SebicheParrilla/The-primis/mechanical/Pneumatics/Penumatic_Engine/README.md

# Pneumatic Engine

The pneumatic engine is the primary mechanical power source of AIZA.
It converts the energy stored in compressed air into rotational motion,
which is then transferred to the transmission.

The engine consists of four cylinders, and 2 crankshafts, two pistons per crankshaft. Compressed air is admitted to each cylinder at a specified point in the crankshaft's rotation, producing a sequence of piston movements
that maintains continuous rotation.

### Lego pistons and valves

<table>
<tr>
<td width="50%" align="center">

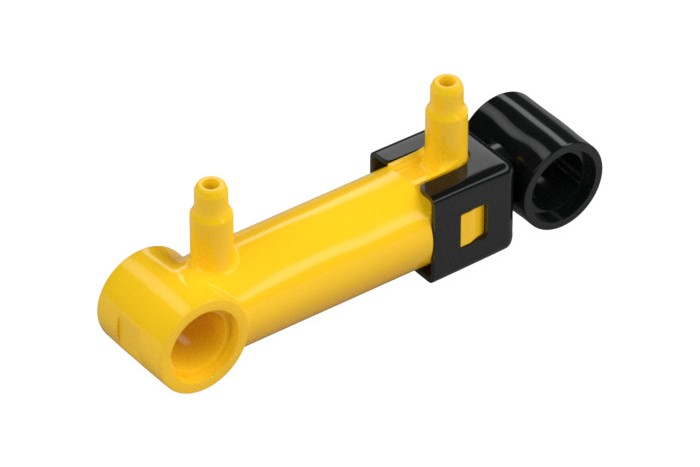
[picture p33: media/photos/legopneumaticcylinder.jpg]


**Lego Piston**
</td>
<td width="60%" valign="top">

Lego's pneumatic pistons have two inlets, depending in which inlet you apply air pressure to, the piston will contract or expand.

</td>
</tr>
</table>

<table>
<tr>
<td width="50%" align="center">

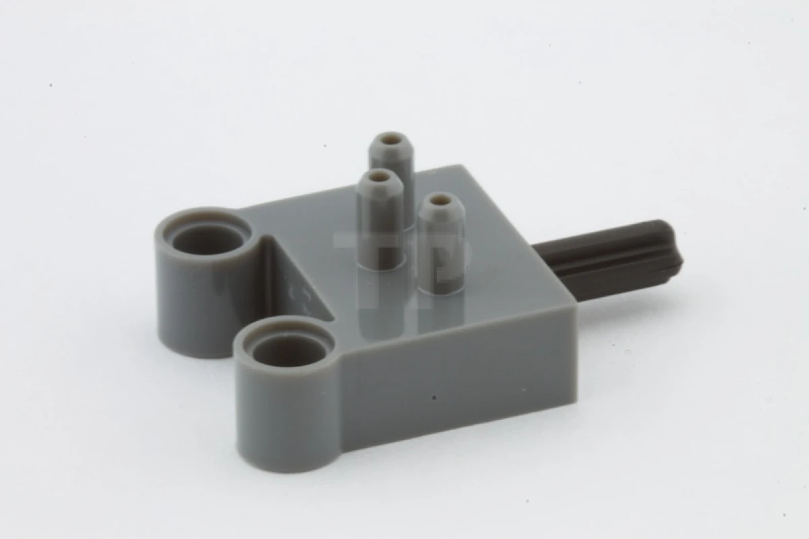
[picture p34: media/photos/LegoAirSwitch.webp]


**Lego Pneumatic Valve**
</td>
<td width="60%" valign="top">

 The switches are components that control the direction of air pressure with the direction of a lever.

</td>
</tr>
</table>

### Engine timing 
<table>
<tr>
<td width="50%" align="center">

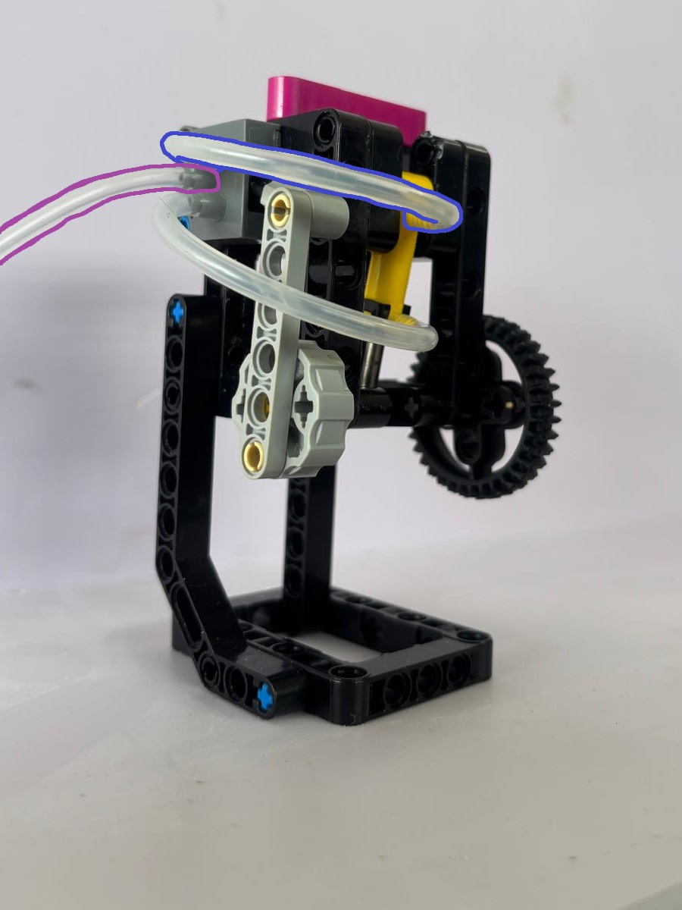
[picture p35: media/photos/Stroke22_croppedpainted.jpg]


**0° - 90°**
</td>
<td width="60%" valign="top">

Here we have a simple pneumatic engine with 1 switch and 1 piston, in this case the output of the engine is the black gear, the axle which its connected is called the crankshaft. On the rear of the engine we have a clear view of the pushrod resposible for connecting the crankshaft to the switch, if the crankshaft spins, the lever on the switch will move up and down. 
In this case, if we were to look at the engine from the front, (facing the black gear), the engine will spin clockwise.The hose outlined in purple is the supply of the switch, and the blue hose is the one activated and pressurised by the switch, if you follow the line you'll see that the line  top hole of the piston is the one being pressurised so the piston will expand, making the crankshaft spin 90°.

</td>
</tr>
</table><table>
<tr>
<td width="50%" align="center">

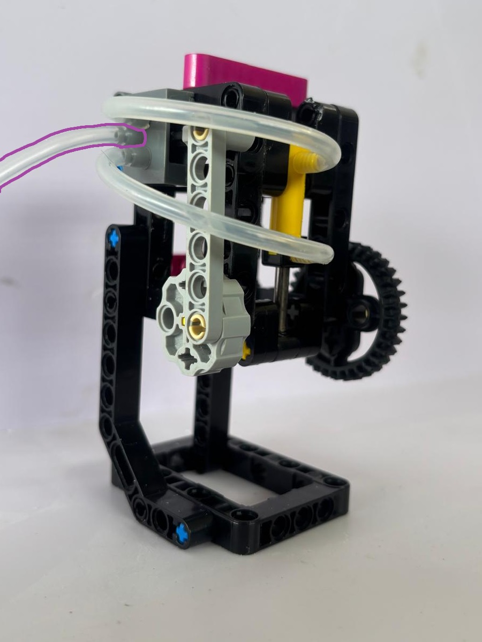
[picture p36: media/photos/Stroke33_croppedpainted.jpg]


**90° - 180°**
</td>
<td width="60%" valign="top">

The piston has expanded to it's maximum, and now needs to contract to keep spining the engine, but now the pushrod sets the valve to the middle which means neither of the outputs of the valve are being pressurised.

This causes the engine to lock itself, since the piston can't make the valve give itself pressure to contract and keep the chain reaction going. 

To counter this, one must install a flywheel specially on 1 cylinder engines so that the inertia from the flywheel keeps the motor spinning. Another way to fix this is to add more pistons, if you have a piston that is in a different timing, it can push another piston out of it's lock zone and vise-versa.

</td>
</tr>
</table><table>
<tr>
<td width="50%" align="center">

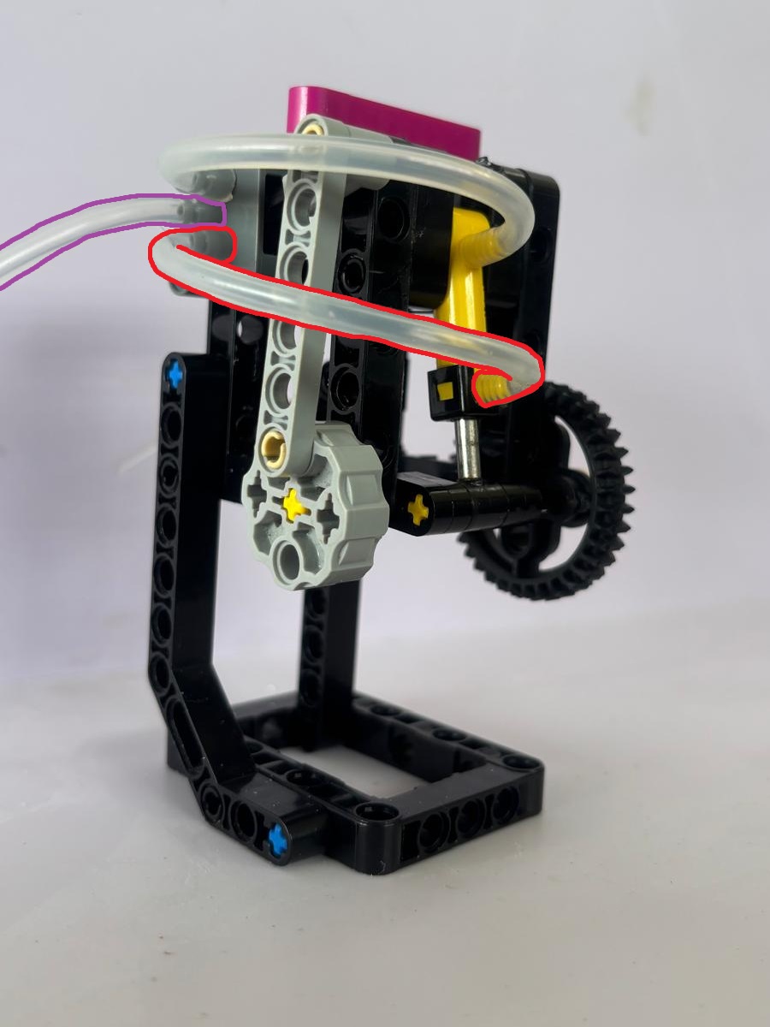
[picture p37: media/photos/Stroke44_croppedpainted.jpg]


**180° - 270°**
</td>
<td width="60%" valign="top">

Now the pushrod has reached its most upward position, and the valve has opened the lower output with pressure so the piston starts to contract.

</td>
</tr>
</table><table>
<tr>
<td width="50%" align="center">



**270° - 360°**
</td>
<td width="60%" valign="top">

This is the last 90° for a complete revolution, the valve is closed and blocking both outputs. 

Now the Piston will expand and keep the cycle going.

</td>
</tr>
</table>
