SebicheParrilla/The-primis/hardware/mechanical/Pneumatics/ASMS/README.md

# Air Supply and Management System (ASMS)

The Air supply and management system plays a crutial part in making our vehicle work, it ensures eficient and leak free supply of compressed air to the pneumatic engine. The high pressure side needed to be safe for 100psi, and ur low pressure side needed to be safe for a max of 30 psi,all of ur pneumatic components are rated higher pressure than the most they will ever endure. We knew this system was going to take up a lot of space and weight, so we allways kept in mind picking lightweight and compact components.

<div align= "center">


This flowchart represents the components in the ASMS
</div>

## Air tanks and hoses

it was very difficult to find lightweight, decent pressure and compact tanks for our proyect, but struck gold when we found a manufacturer for RC airplane pneumatic systems, this was absolutley perfect for ur proyect, since airplanes crutially need reliable, lightweight and cmpact components.

We used their hoses, that are rated at a max of 120psi and their air tanks, that have a displacement of 14.5³ inches, having **X**, making a total of **XX**³ inches.

## Air regulator
 After testing with various vertins of our pneumatic engines, we deduced that we needed to supply our engines with 20-25 psi of constant pressure for a minimum of 90 seconds
