SebicheParrilla/The-primis/build_guide/Step06/Chassis(00).md

# Step 6: Chassis

## Step 6.1 3DPrinted components
Print every component and note quatities.
| Component | Code | STL File |
|---|---|---|
| Output gears **x2** | C01 | [Download STL](../../media/CAD/STL/output_Gears.stl) |
| Chassis | C02 |[Download STL](../../media/CAD/STL/Car_Frame_3.stl)|
| Raspberry pi base | C03 |[Download STL](../../media/CAD/STL/RaspberryBase1.stl)|
| Air tank base | C04 |[Download STL](../../media/CAD/STL/Air_tanks_Base_3.stl)|
| Camera arm | C05 |[Download STL](../../media/CAD/STL/Camera_arm.stl)|
| Camera Base | C06 |[Download STL](../../media/CAD/STL/Camera_Base.stl)|

## Step 6.2  Miscelanious components

| Component | Quantity |
|---|---|
| Servo Screws | x2 |
| High pressure hose 60mm | x2 |
| High pressure hose 100mm | x1 |
| High pressure hose T | x1 |
| LEGO Pin with friction ridges | x14 |
| LEGO 4L axle | x1 |
| Photointerruptor LM393 | x1 |
| 1/2' screw | x8 |
| M4 screws | x2 |
| Panel mount sdpt toggle switch | x2 |
| Cytron Motion 2350 | x1 |
| BNO085 IMU | x1 |
| Boost converter | x1 |
| Buck converter | x1 |
| Micro usb cable | x1 |
| 18650 baterry holder in series  | x1 |
| 18650 baterries | x2 |
| Raspberry pi 3B+ | x1 |
| IMX708 | x1 |

| Tools |
|---|
| Dupont connector crimper  |
| Hot glue gun and silicone  |

[Once you have all the materials and objects printed go to the next step linked here.](../Chassis(01).png)
