SebicheParrilla/The-primis/mechanical/eCVT/eCVT_4.0.md

# eCVT 4.0
> Retrospective log from March 20, 2026: This entry's information was digitized from the physical engineering notebook.

<div align= "center">
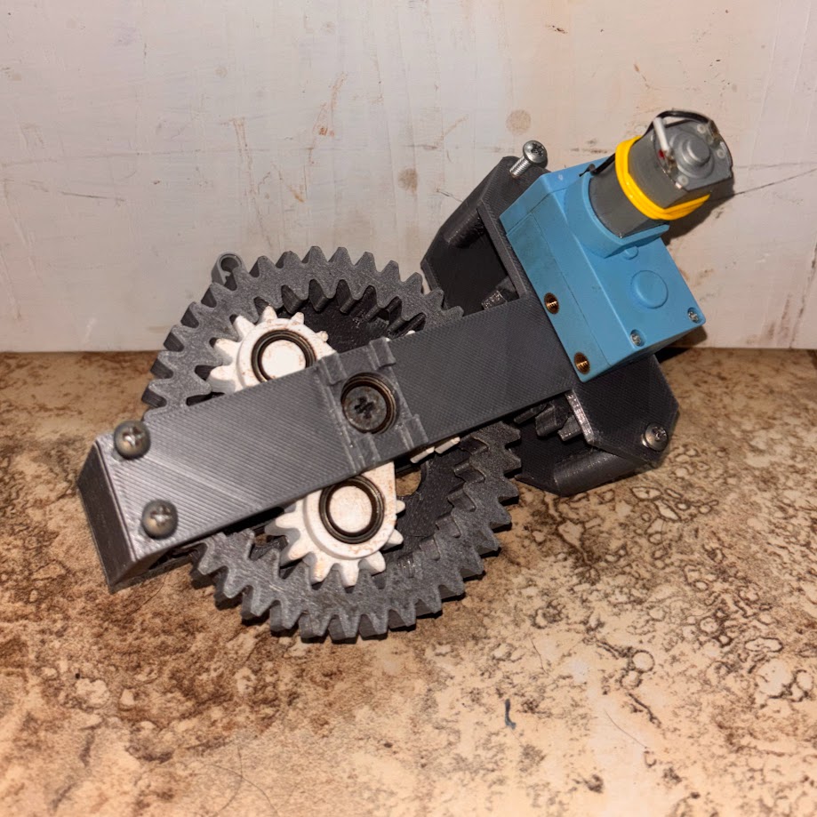
[picture p38: media/photos/IMG_2879.jpg]

</div>

## Specs
- Module: 2
- Pressure angle: 20°
- Gear ratio, 1 (Sun) : 4 (planet Carrier)
- R (Ring Gear) = 30
- S (Sun Gear) = 12
- P (Planet Gear) = 6
- OR (Outside Ring Gear) = 40

This was our first complete version that was equiped with everything the vehicle needed, we used this transmission for the first movable version of the vehicle, [AIZA 1.0](../../development_process/vehicle_iterations/AIZA_1.0.md), which we used for the Pueto Rico National Robot Olympiad.

## Improvements

With everything we learned with out past mistakes with the 3.0 and 3.1 versions we were able to make a smaller version of the transmission.

As the first iteration that had a transmission motor we made the gear ratio 4:1 opting for torque over speed.

## Improvements proyected for the E-CVT 5.0

This was  a great improvement over our past versions but we strived for a even smaller version in the future.
