SebicheParrilla/The-primis/mechanical/eCVT/eCVT_1.0.md

# eCVT 1.0
> Retrospective log from February 22, 2026: This entry's information was digitized from the physical engineering notebook.

Our first attempt of making our planetary gear transmission, this was mostly an attempt that tought us how to use fusion360, how our 3d printer worked and introduced us to gear ratio calculations.

We printed some parts and already saw some problems, so we didn't fully asemble it.

<div align= "center">
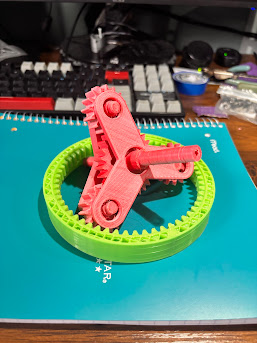
[picture p40: media/photos/IMG_1895.jpg]

</div>

## Specs
- Module: 2
- Pressure angle: 20°
- Gear ratio, 1 (Sun) : 4 (planet Carrier)
- R (Ring Gear) = 48
- S (Sun Gear) = 12
- P (Planet Gear) = 18

## Transmission Output/Input

Our plan was to make the pneumatic engines input on the sun gear, the electric motor's input on the planetary carrier and the output to be the ring gear.

## Improvements proyected for the E-CVT 2.0

Change the electric motor input to the ring gear, and the output to be the planetary carrier, this allows us to be able to move the car in the event of the pneumatic system failing.

We knew we it would be dificult to fit a big transmission on the car, so making things more compact and smaller will allways be a target.
