SebicheParrilla/The-primis/mechanical/eCVT/eCVT_3.0&3.1.md

# eCVT 3.0
> Retrospective log from March 10, 2026: This entry's information was digitized from the physical engineering notebook.

This was a prototype for a ultra small eCVT.

You can change a gear's size by making the module smaller, but you can only go so far, you will reach a point to where the teeth are going to be very small and you'll still have a big gear.

by reducing the number of teeth bt not the module you'll have the same size teeth but on a smaller radius gear.

<div align= "center">
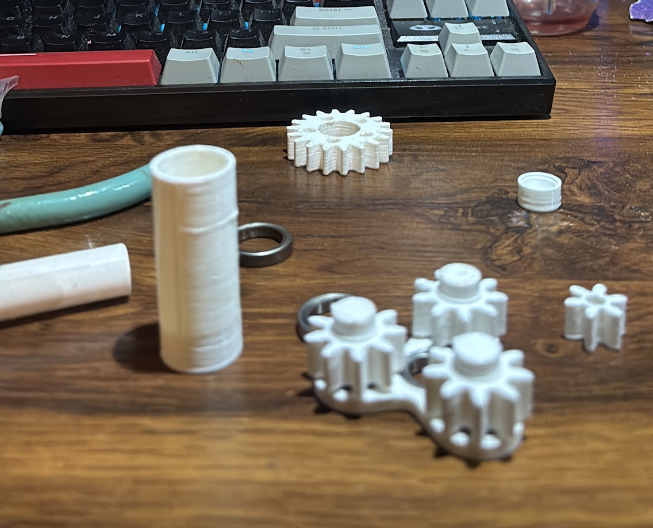
[picture p42: media/photos/ECVT3.jpg]

</div>

## Specs
- Module: 2
- Pressure angle: 20°
- Gear ratio, 1 (Sun) : 4 (planet Carrier)
- R (Ring Gear) = 24
- S (Sun Gear) = 6
- P (Planet Gear) = 9
- OR (Outside Ring Gear) = 30

## Why it failed 
Every gear from the past iteration as cut by half, and therefore it was way smaller thatn the previous version.

But we didn't see something coming, since the gears had large teeth compared to the size we had to make a big planet carrier, and we accientaly made it bigger than the teeth on ou ring gear, so it was impossible to assemble.

We desingned the planet carrier with the bearing for the planet gears and the sun gear very close together, when we assembld the planet carrier, it warped and snaped because of metal not stretching nor cmpling with the error of tolerances made by our 3d printer.

## Improvements proyected for the E-CVT 4.0

We learned that we had to keep in mind how we would assemble our designs when printed.

We knew we needed a balance of reducing the mdule and teeth number in order to have proportional gears for the transmission.

---
# eCVT 3.1

This was an attempt of fixing the problems of the 3.0, to try and make a ultra small version.

We kept printing slightly tune parts, but nothing worked, we will try later to make a ultra light and compact version, and focus on having something functional to keep testing our pneumatic engine.
