SebicheParrilla/The-primis/hardware/vehicle iterations/AIZA 1.0.md

# AIZA 1.0

 The first alive and moving vertion of AIZA, was only using the E-CVT V.4's motor to move, the pneumatic engine was installed, but the ASMS wasn't, so it had no way for it to activate.

## [Vehicle Photos](../../v-photos)

<div align= "center">
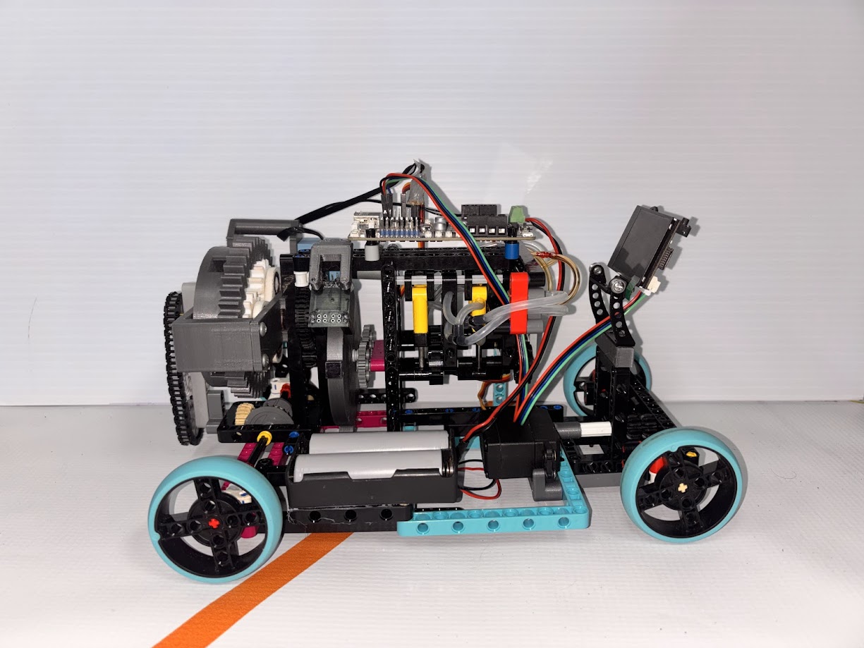
[picture p43: v-photos/Past iterations/IMG_2725.jpg]

</div>

It used the Huskylens Ai camera to detect the color of pilars and the lines of the playmat to determine its trayectory, and had a rack and pinion based steering system.
