SebicheParrilla/The-primis/mechanical/Pneumatics/Penumatic_Engine/2.0.md

# Pneumatic engine 2.0
> Retrospective log from March 3, 2026: This entry's information was digitized from the physical engineering notebook.

<div align= "center">
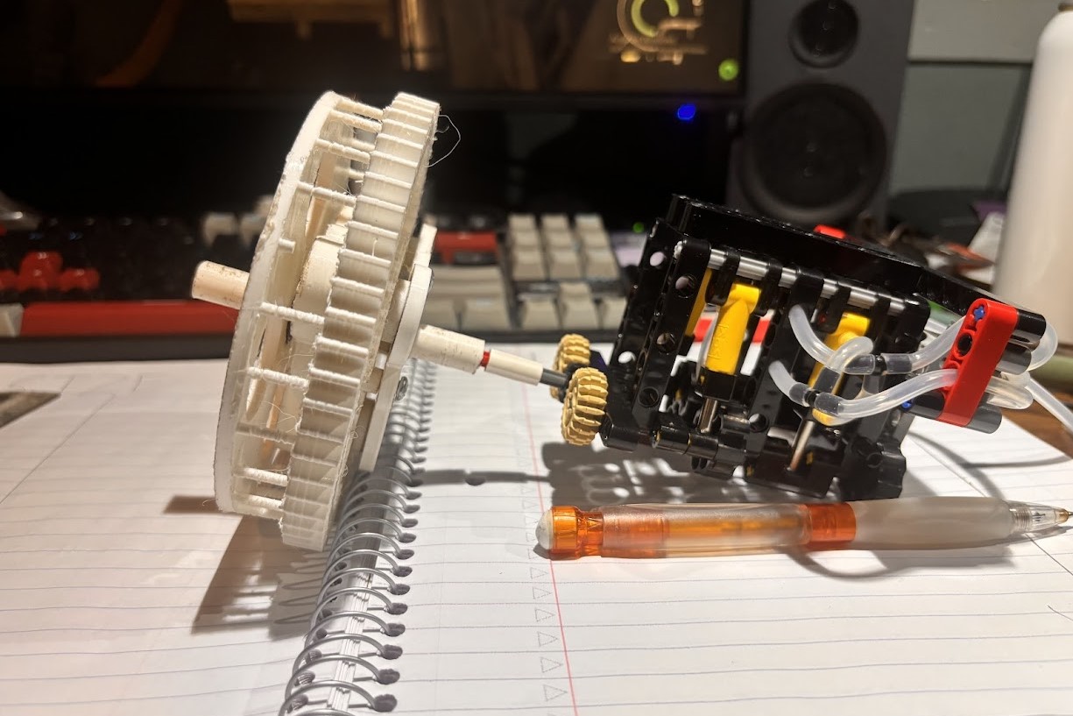
[picture p46: media/photos/pneng2ecvt2.jpg]
</td>
</div>

This engine had the same structure as the previous engine, with 3 frames in parallel, but with 5x7 frames instead of 7x11 frames. This made a engine with the same advantages as the previous engine, with almot half the size.

---

<div align= "center">
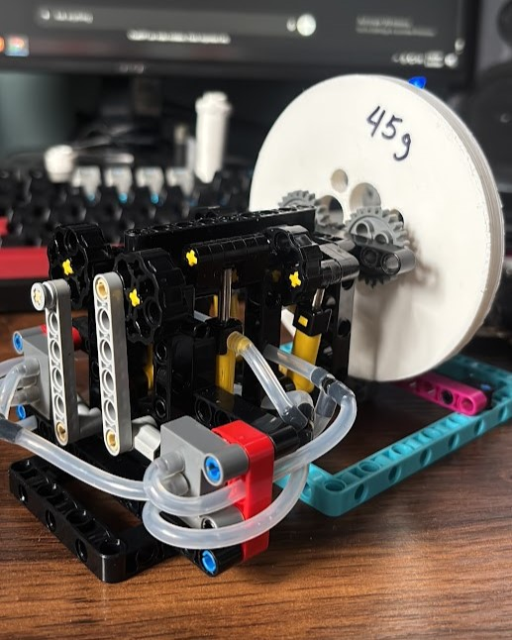
[picture p47: media/photos/pneng2flywheel.jpg]
</td>
</div>

On the image above you can see the engine with a flywheel on its output, and the both crackshafts with a 24 tooth gear, and the output with a 8 tooth gear, so a 1:3 gear ratio, so the flywheel spun 3 times as fast as the engine, amking it spin faster and store more energy, this later prooved that torque was reduced significantly and was not worth loosing.

Although it wasn't connected to the ASMS and inoperational, it was used in the [AIZA V.1](../../../development_process/vehicle_iterations/AIZA_1.0.md) .
