SebicheParrilla/The-primis/hardware/mechanical/eCVT/eCVT 4.0.md

# eCVT 4.0
> Retrospective log: This entry's information was digitized from the physical engineering notebook on 2026-06-29.

<div align= "center">

</div>

## Specs
- Module: 2
- Pressure angle: 20°
- Gear ratio, 1 (Sun) : 4 (planet Carrier)
- R (Ring Gear) = 30
- S (Sun Gear) = 12
- P (Planet Gear) = 6
- OR (Outside Ring Gear) = 40

This was our first complete version that was equiped with everything the vehicle needed, we used this transmission for the first movable version of the vehicle, [AIZA 1.0](../../../hardware/vehicle%20iterations/AIZA%201.0.md), which we used for the Pueto Rico National Robot Olympiad.

## Improvements

With everything we learned with out past mistakes with the 3.0 and 3.1 versions we were able to make a smaller version of the transmission.

As the first iteration that had a transmission motor we made the gear ratio 4:1 opting for torque over speed.

## Improvements proyected for the E-CVT 5.0

This was  a great improvement over our past versions but we astrided for a even smaller version in the future.
