SebicheParrilla/The-primis/hardware/mechanical/E-CVT/E-CVT 1.0.md

# E-CVT 1.0
> Retrospective log: This entry's information was digitized from the physical engineering notebook on 2026-06-27.

Our first attempt of making our planetary gear transmission, this was mostly an attempt that tought us how to use fusion360, how our 3d printer worked and introduced us to gear ratio calculations.



## Specs
- Module: 2
- Pressure angle: 20°
- Gear ratio, 1 (Sun) : 4 (planet Carrier)
- R (Ring Gear) = 48
- S (Sun Gear) = 12
- P (Planet Gear) = 18

This is where we learned how to make planetary gearboxes with proper meshing, we used this formula.
- (R + S) / (number of planets) = x
(x) must be 1 for it to have proper meshing.

## Transmission Output/Input

Our plan was to make the pneumatic engines input on the sun gear, the electric motor's input on the planetary carrier and the output to be the ring gear.

## Improvements proyected for the E-CVT 2.0

Change the electric motor input to the ring gear, and the output to be the planetary carrier, this allows us to be able to move the car in the event of the pneumatic system failing.
