SebicheParrilla/The-primis/electrical/e-valve.md

# Electronic Valve

<div align= "center">

</div>

---

This component is a normally closed valve that uses a solenoid to open or close the passage of compressed air to the pneumatic engine, allowing us to control wether its ON/OFF.
