SebicheParrilla/The-primis/electrical/OV5647.md

## OV5647 Camera

This is the first camera we used for AIZA. We used it until we felt it was worth it to invest in a wider FOV camera and to familiarise ourselfs with coding.

<div align= "center">
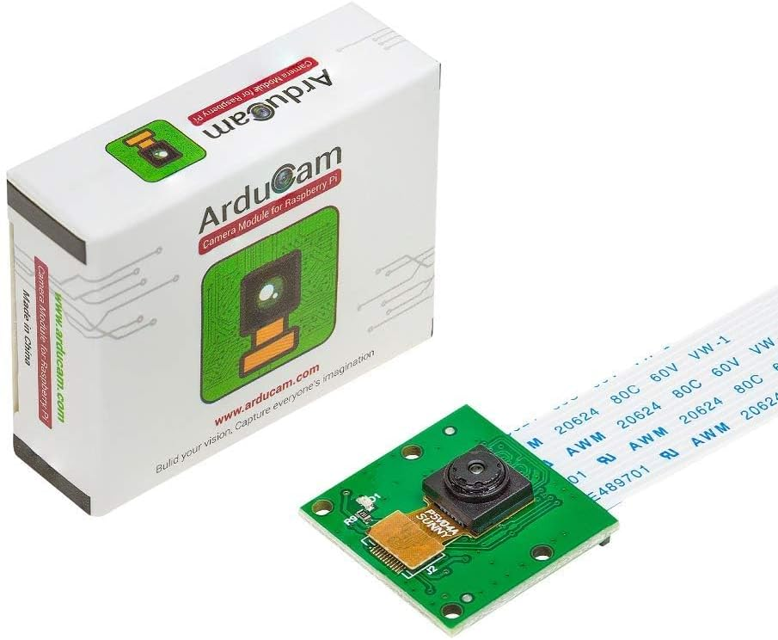
[picture p54: media/photos/OV5647.jpg]


The camera had a max resolution of 1080p and had a FOV of 56°

</div>
