SebicheParrilla/The-primis/logs/3-2-2026(X).md

# Brainstorming/analising eCVT behaivor 
> Retrospective log: This entry's information was digitized from the physical engineering notebook on 2026-06-30.

We are considering a T-slot photo interruptor as a RPM sensor, this will allow the microcontroller to compare these values to the transmission motor encoder to calculate the wheel speed.

Hall efect sensors, that are another alternative as a RPM sensor, need mateal aand magnetized components to work, so it will be heavyver and take more space

(DIGITALIZE THE TABLE IN ENG NOTEBOOK 1)
