SebicheParrilla/The-primis/development_process/vehicle_iterations/AIZA_2.1.md

# AIZA 2.1

<div align= "center">
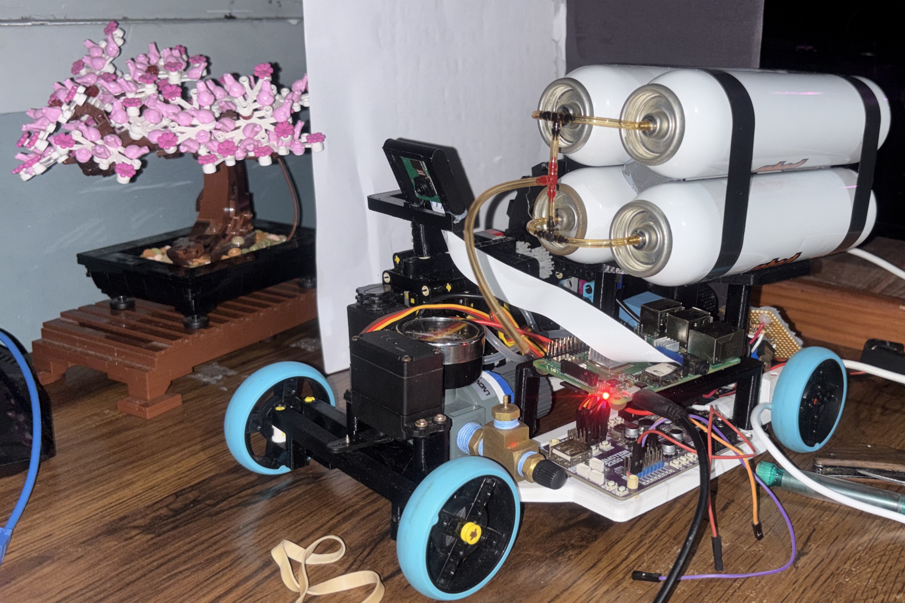
[picture p57: media/photos/AIZA 2.1.jpg]

</div>

---

With the same chassis as the 2.0 but with some minor tweaks, this was the first version of AIZA to have the [Raspberrypi](../../electrical/Raspberry_pi_3B+.md) installed, along with the [Camera](../../electrical/IMX708.md), the first time the robot had all of its systems in place, 

▶️ [Watch the AIZA 2.1 in action!](https://youtu.be/QNBB8k_d7_M)
