SebicheParrilla/The-primis/development_process/logs/eCVTanalisis.md

# Brainstorming/analising eCVT behaivor 
> Retrospective log from March 2, 2026: This entry's information was digitized from the physical engineering notebook. [Click here to see the digitalized version](../../development_process/digitalized_notebook/engineering_notebook_page_019-1.png).

We are considering a T-slot photo interruptor as a RPM sensor, this will allow the microcontroller to compare these values to the transmission motor encoder to calculate the wheel speed.

Hall efect sensors, that are another alternative as a RPM sensor, need mateal aand magnetized components to work, so it will be heavyver and take more space
