SebicheParrilla/The-primis/electrical/Cytron_Motion_2350_Pro/README.md

## Cytron Motion 2350 Pro
<div align= "center">

</div>
