SebicheParrilla/The-primis/build_guide/Step06/Chassis (1).png

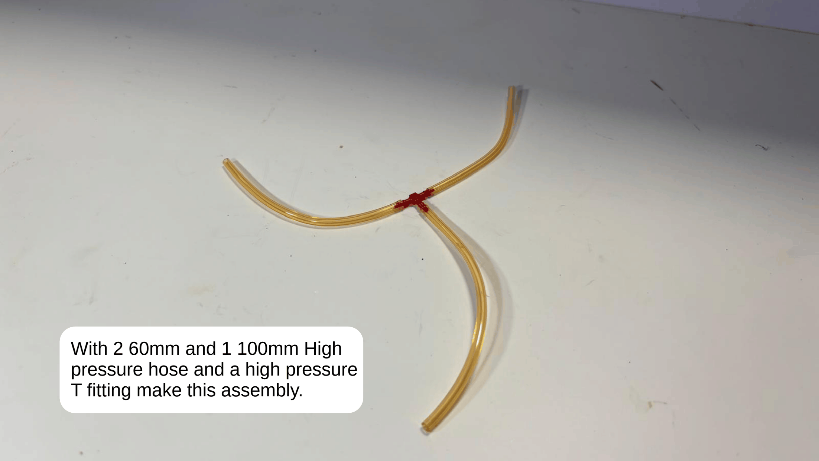
build_guide/Step06/Chassis (1).png
