SebicheParrilla/The-primis/build_guide/Step06/Chassis (2).png

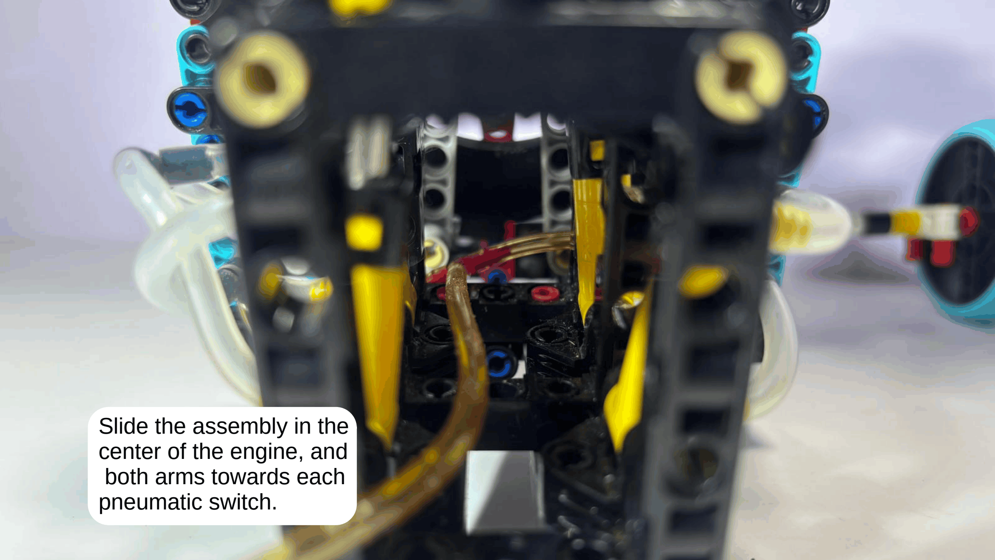
build_guide/Step06/Chassis (2).png
