SebicheParrilla/The-primis/build_guide/Step06/Chassis (3).png

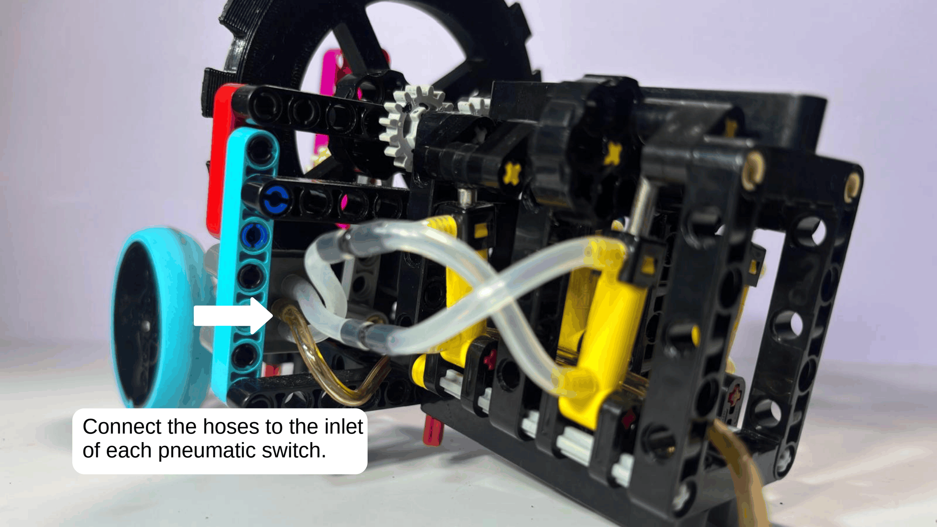
build_guide/Step06/Chassis (3).png
