SebicheParrilla/The-primis/build_guide/Step06/Chassis (6).png

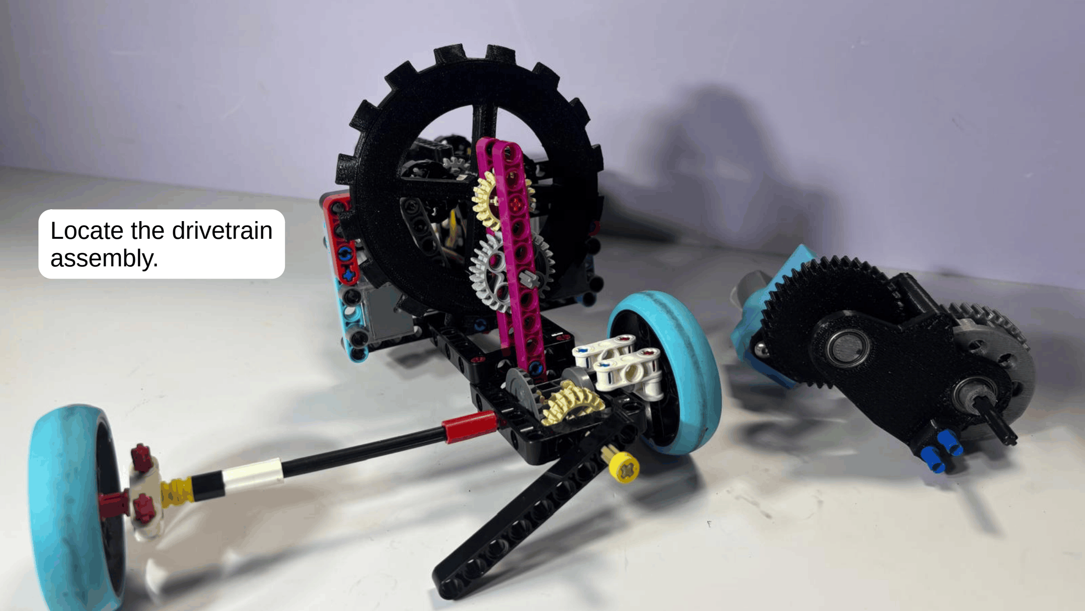
build_guide/Step06/Chassis (6).png
