SebicheParrilla/The-primis/build_guide/Step06/Chassis (14).png

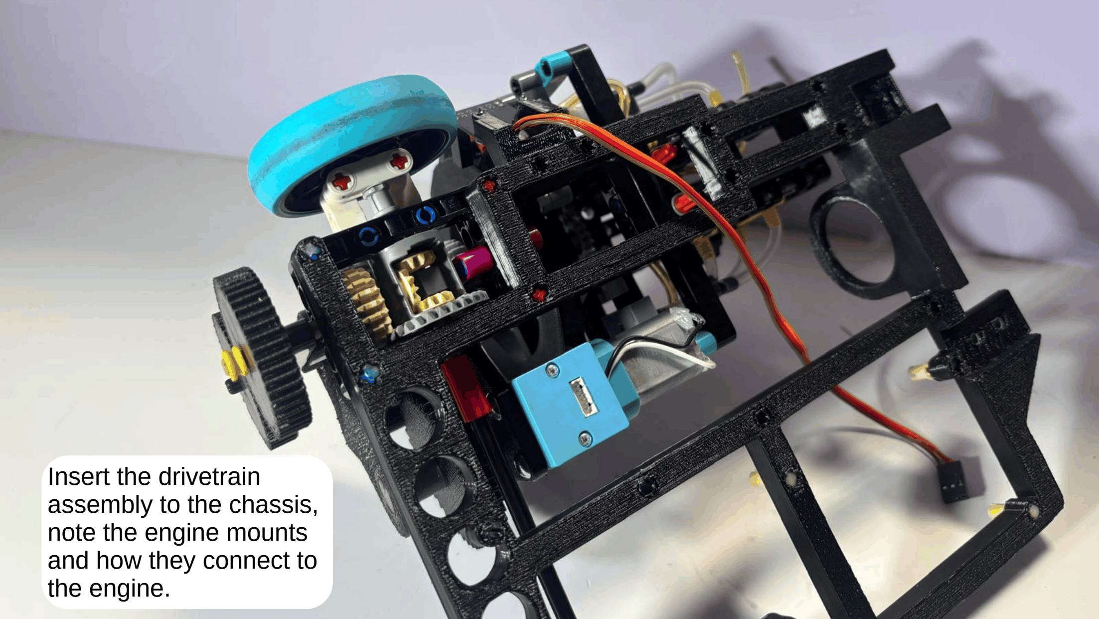
build_guide/Step06/Chassis (14).png
