SebicheParrilla/The-primis/build_guide/Step06/Chassis (17).png

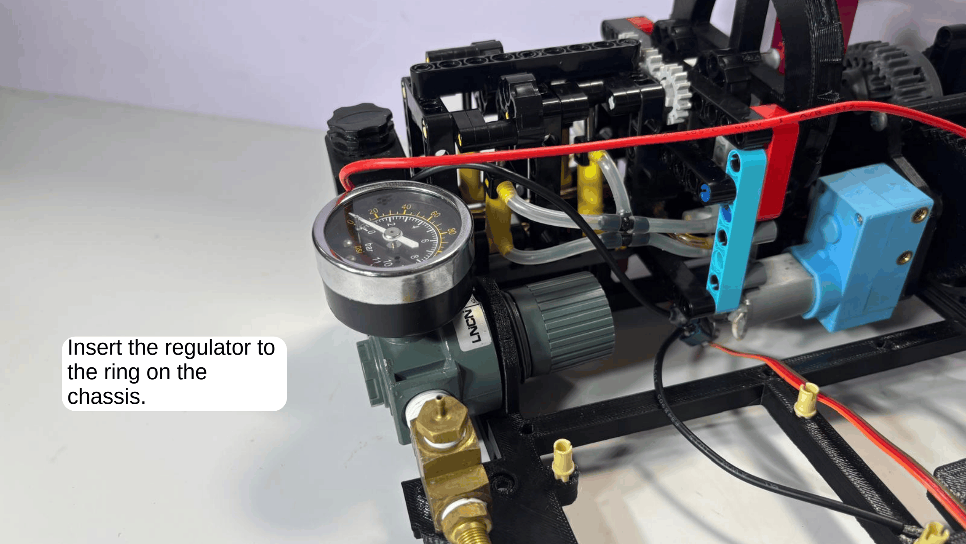
build_guide/Step06/Chassis (17).png
