SebicheParrilla/The-primis/build_guide/Step06/Chassis (18).png

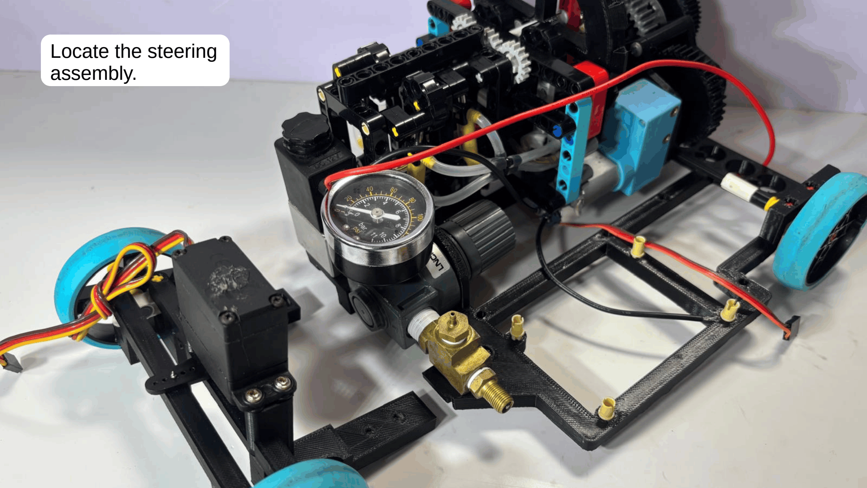
build_guide/Step06/Chassis (18).png
