SebicheParrilla/The-primis/build_guide/Step06/Chassis (25).png

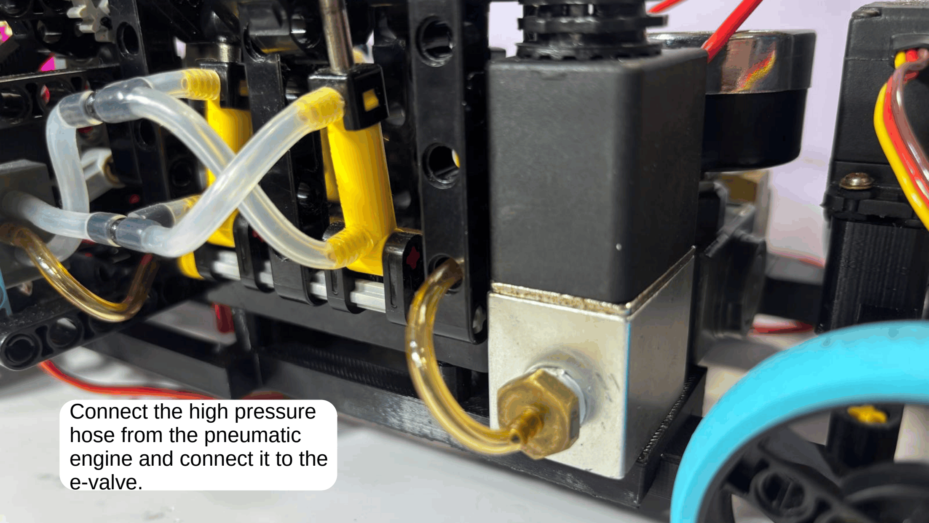
build_guide/Step06/Chassis (25).png
