SebicheParrilla/The-primis/build_guide/Step06/Chassis (28).png

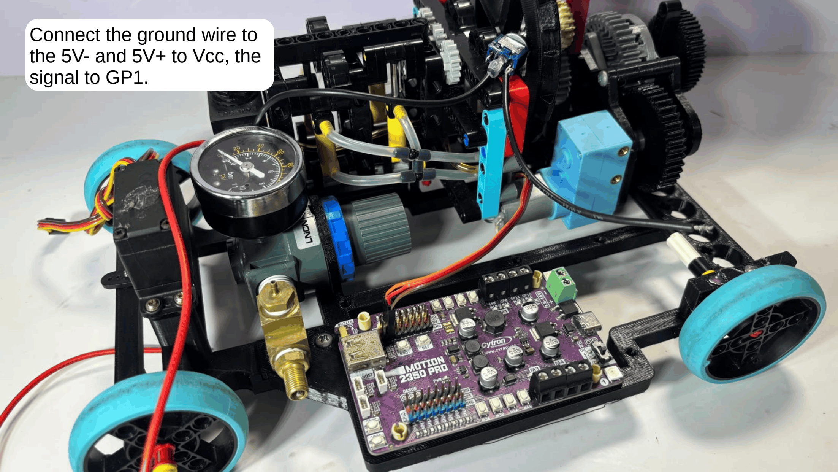
build_guide/Step06/Chassis (28).png
