SebicheParrilla/The-primis/build_guide/Step06/Chassis (30).png

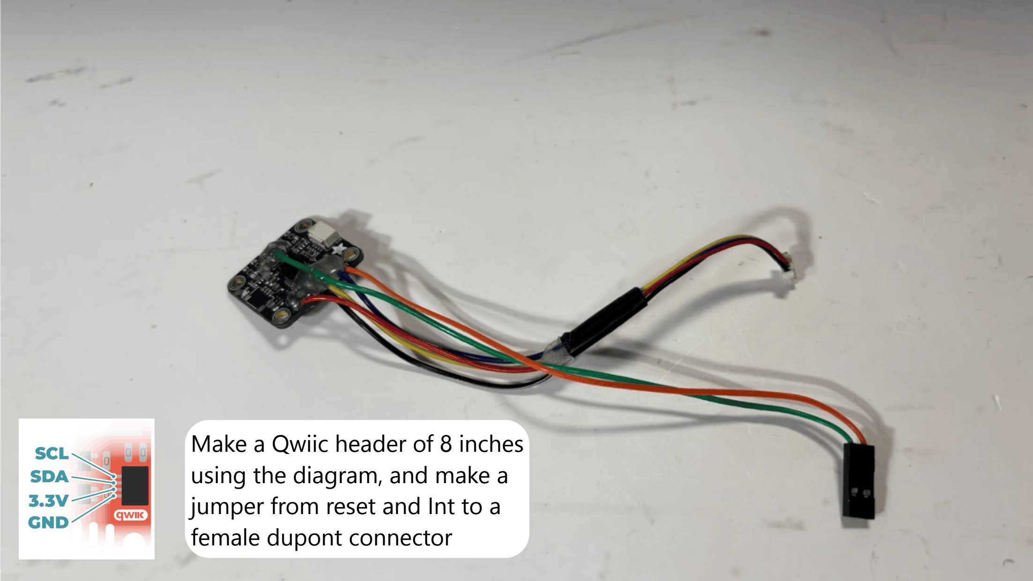
build_guide/Step06/Chassis (30).png
