SebicheParrilla/The-primis/build_guide/Step06/Chassis (34).png

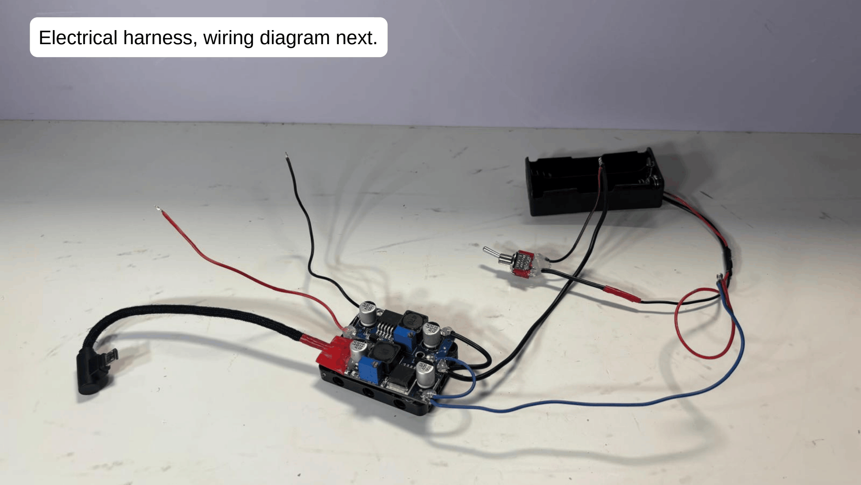
build_guide/Step06/Chassis (34).png
