SebicheParrilla/The-primis/build_guide/Step06/Chassis (41).png

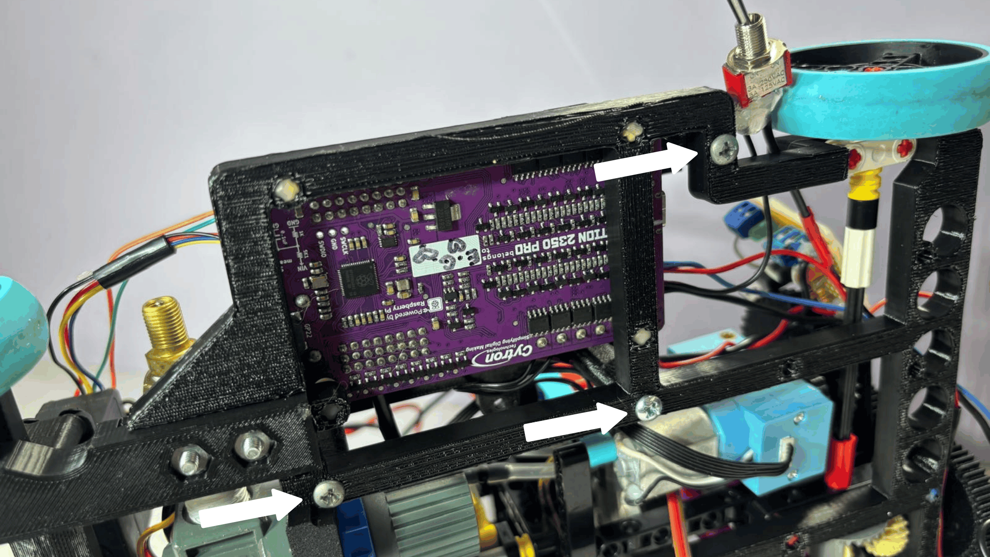
build_guide/Step06/Chassis (41).png
