SebicheParrilla/The-primis/build_guide/Step06/Chassis (45).png

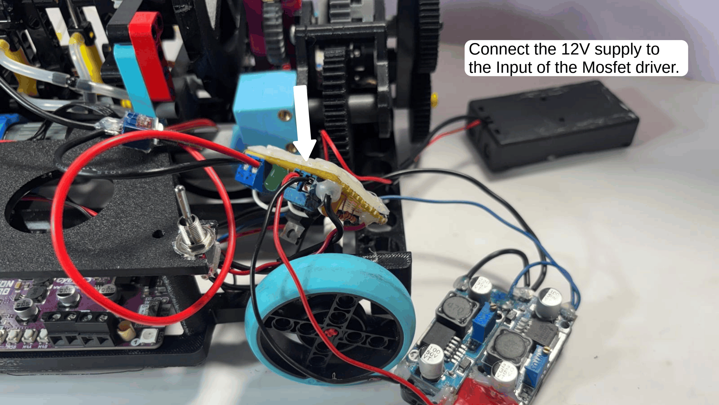
build_guide/Step06/Chassis (45).png
