SebicheParrilla/The-primis/build_guide/Step06/Chassis (46).png

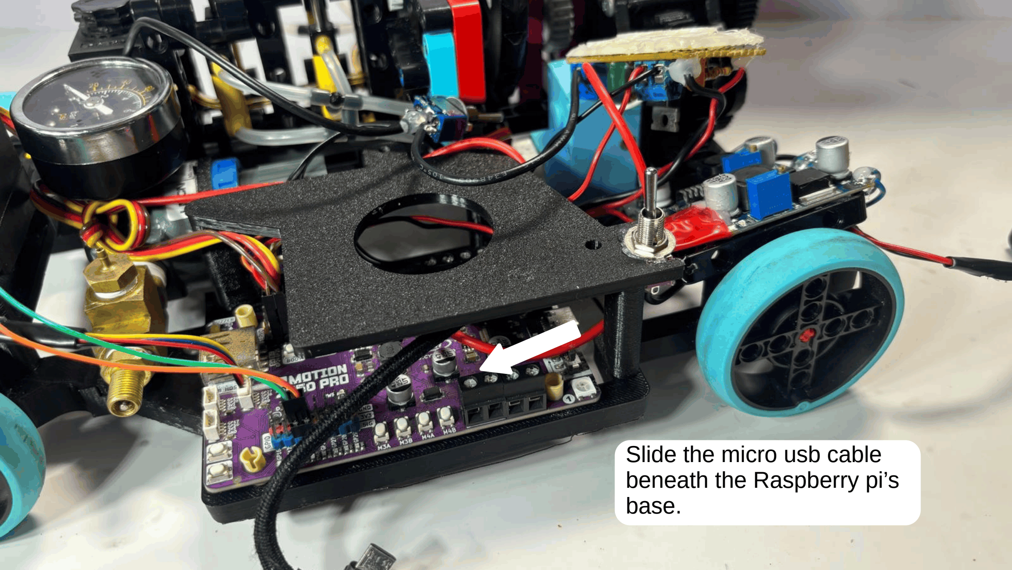
build_guide/Step06/Chassis (46).png
