SebicheParrilla/The-primis/build_guide/Step06/Chassis (47).png

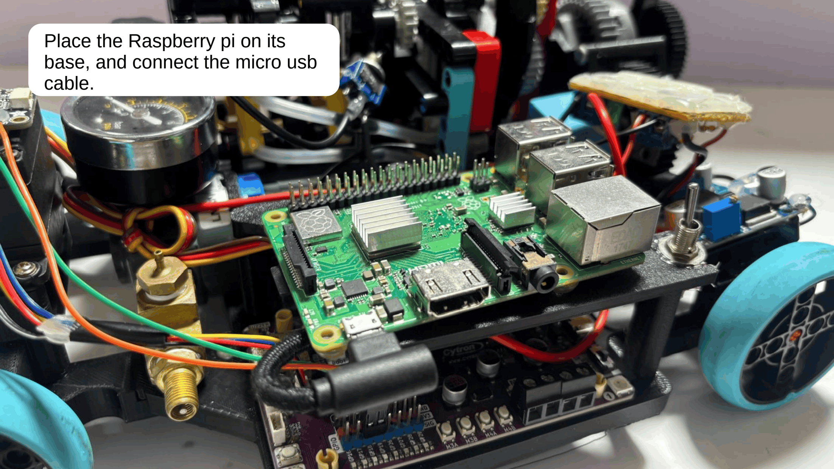
build_guide/Step06/Chassis (47).png
