SebicheParrilla/The-primis/build_guide/Step06/Chassis (51).png

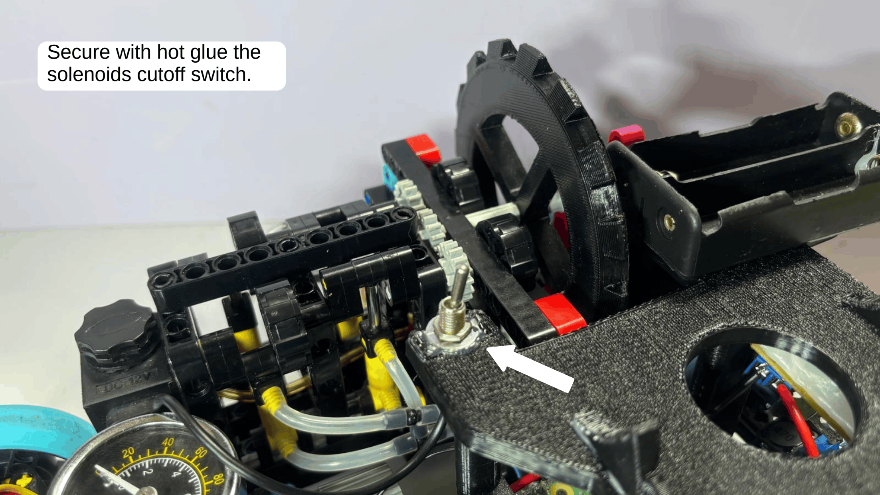
build_guide/Step06/Chassis (51).png
