SebicheParrilla/The-primis/build_guide/Step06/Chassis(11).png

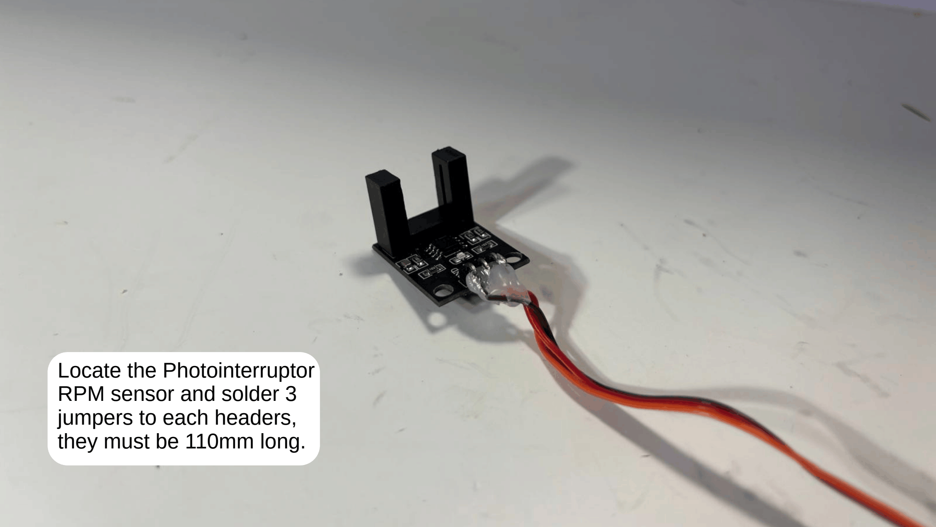
build_guide/Step06/Chassis(11).png
