SebicheParrilla/The-primis/build_guide/Step06/Chassis(13).png

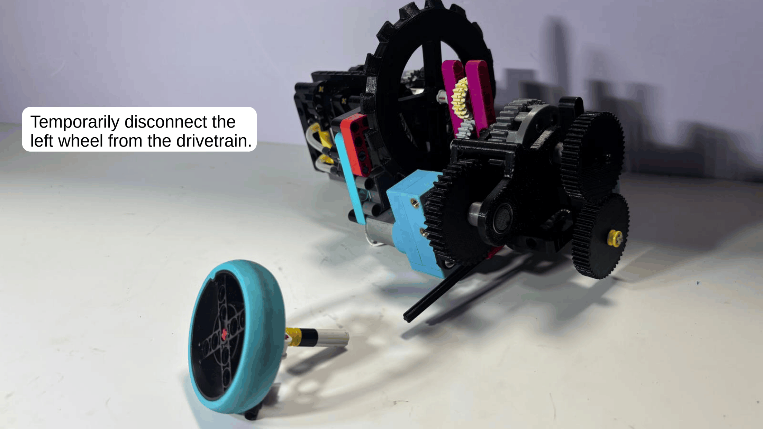
build_guide/Step06/Chassis(13).png
