SebicheParrilla/The-primis/build_guide/Step06/Chassis(15).png

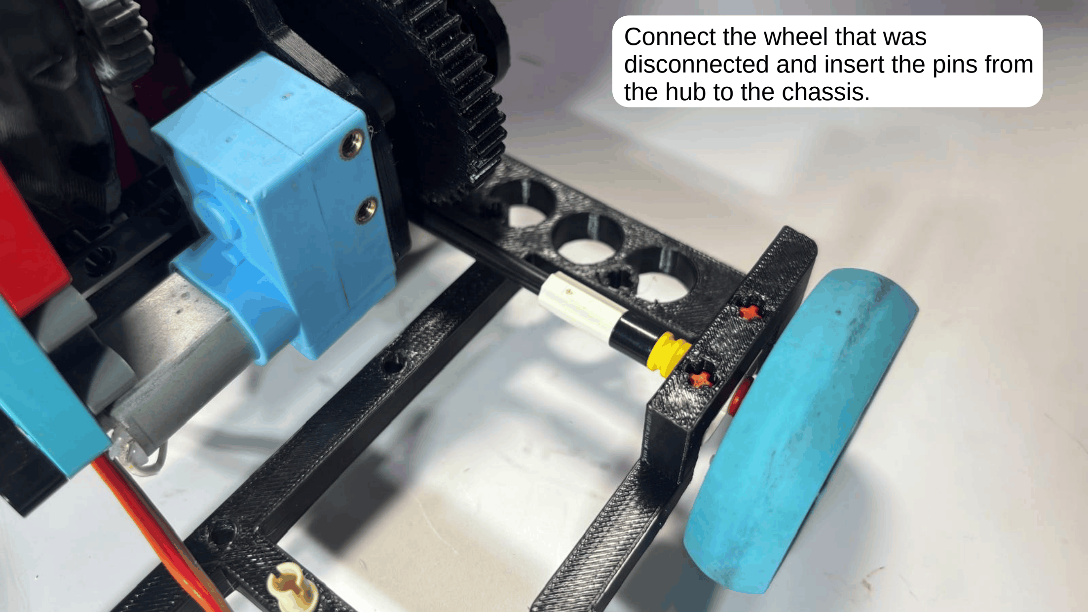
build_guide/Step06/Chassis(15).png
