SebicheParrilla/The-primis/build_guide/Step06/Chassis(19).png

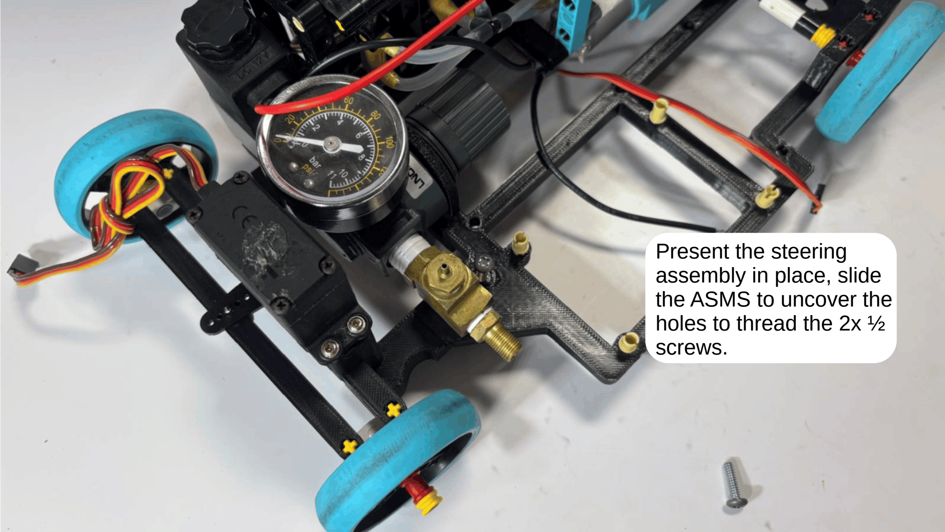
build_guide/Step06/Chassis(19).png
