SebicheParrilla/The-primis/build_guide/Step06/Chassis(20).png

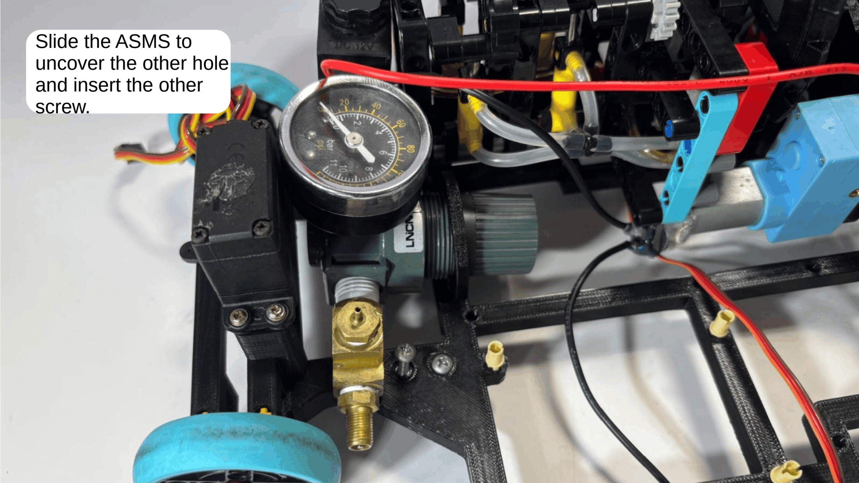
build_guide/Step06/Chassis(20).png
