SebicheParrilla/The-primis/build_guide/Step06/Chassis(24).png

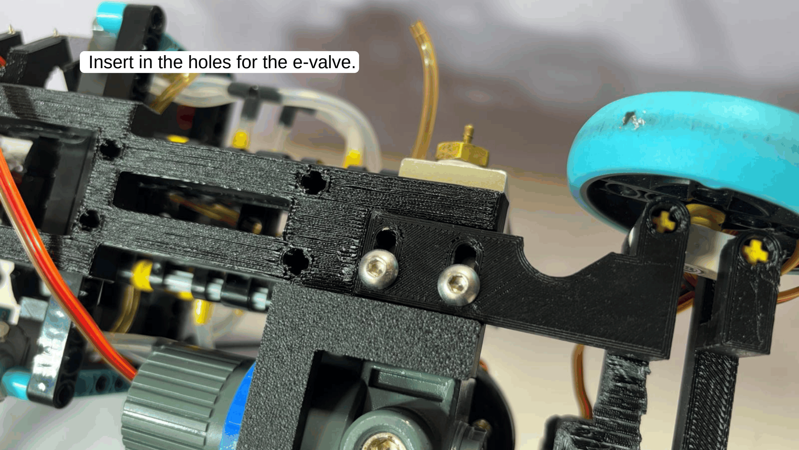
build_guide/Step06/Chassis(24).png
