SebicheParrilla/The-primis/build_guide/Step06/Chassis(26).png

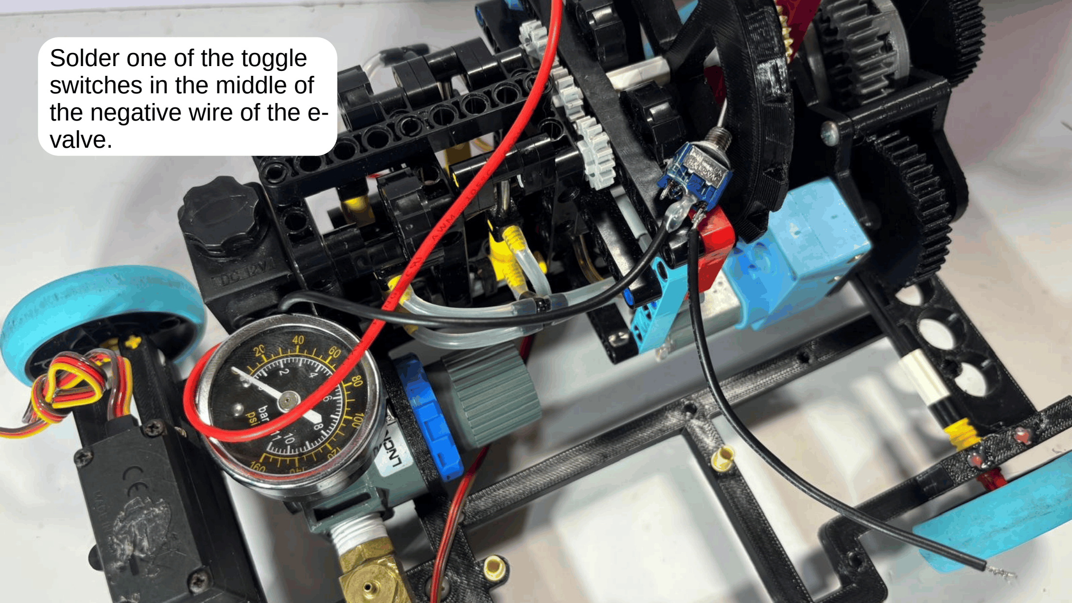
build_guide/Step06/Chassis(26).png
