SebicheParrilla/The-primis/build_guide/Step06/Chassis(32).png

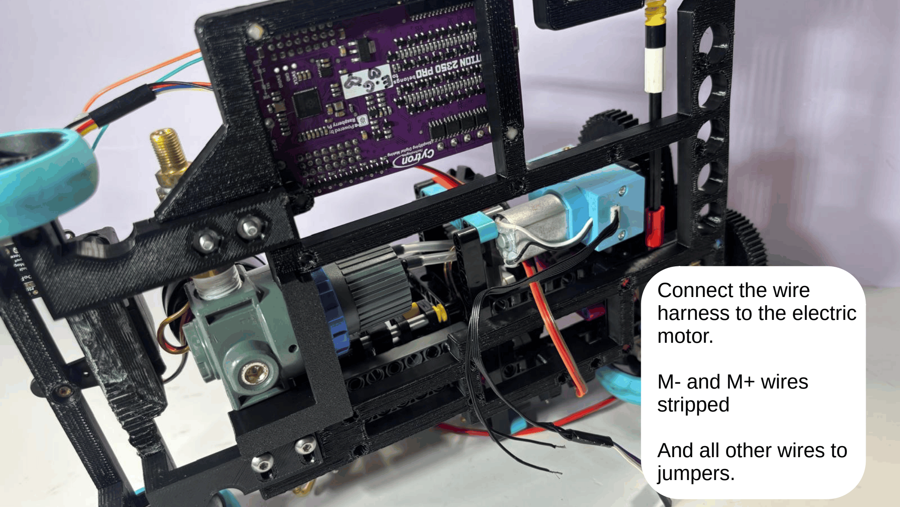
build_guide/Step06/Chassis(32).png
