SebicheParrilla/The-primis/build_guide/Step06/Chassis(35).png

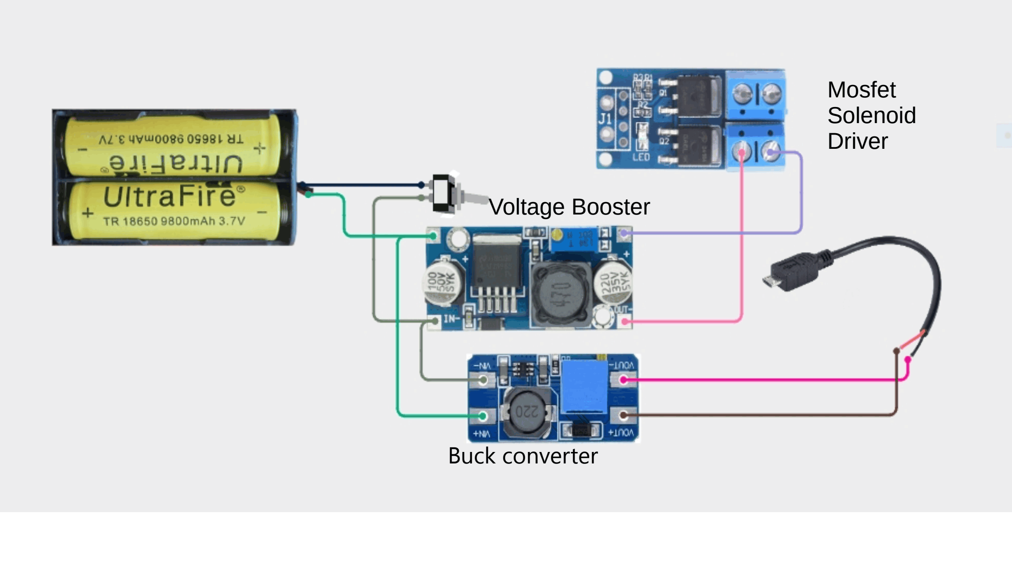
build_guide/Step06/Chassis(35).png
