SebicheParrilla/The-primis/build_guide/Step06/Chassis(37).png

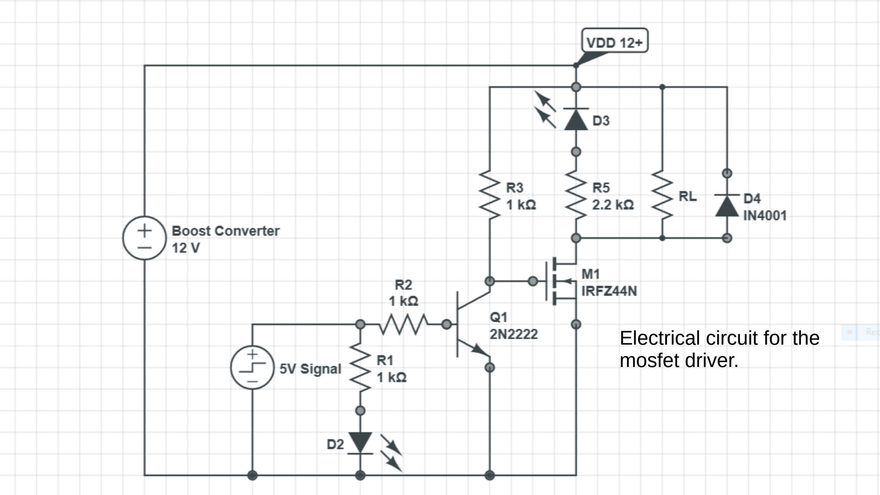
build_guide/Step06/Chassis(37).png
