SebicheParrilla/The-primis/build_guide/Step06/Chassis(38).png

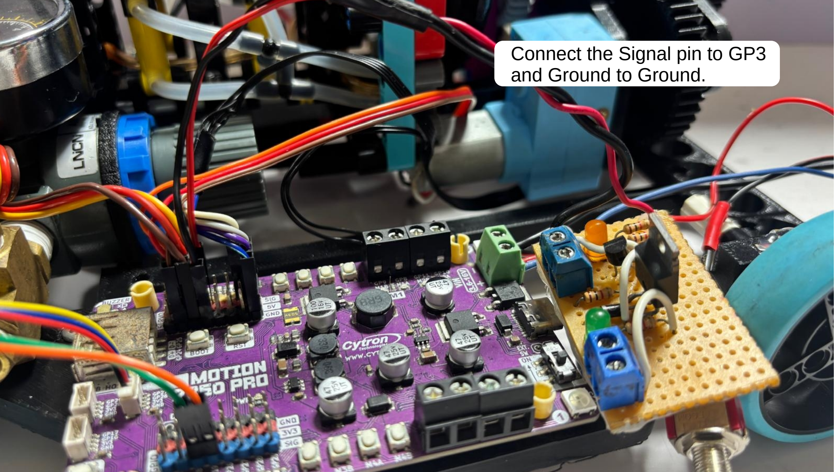
build_guide/Step06/Chassis(38).png
