SebicheParrilla/The-primis/build_guide/Step06/Chassis(39).png

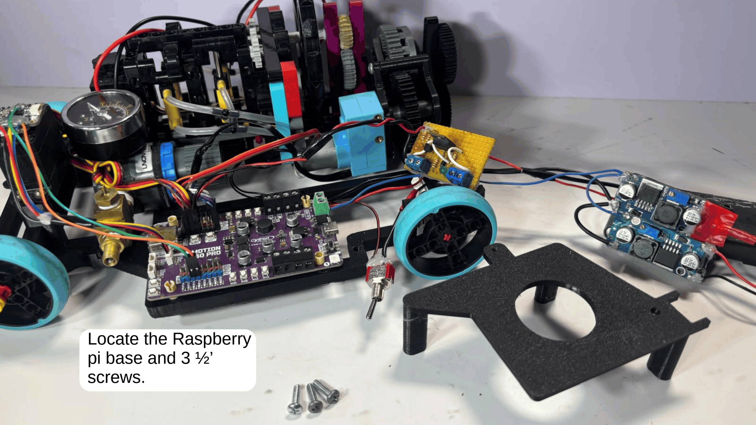
build_guide/Step06/Chassis(39).png
