SebicheParrilla/The-primis/build_guide/Step06/Chassis(53).png

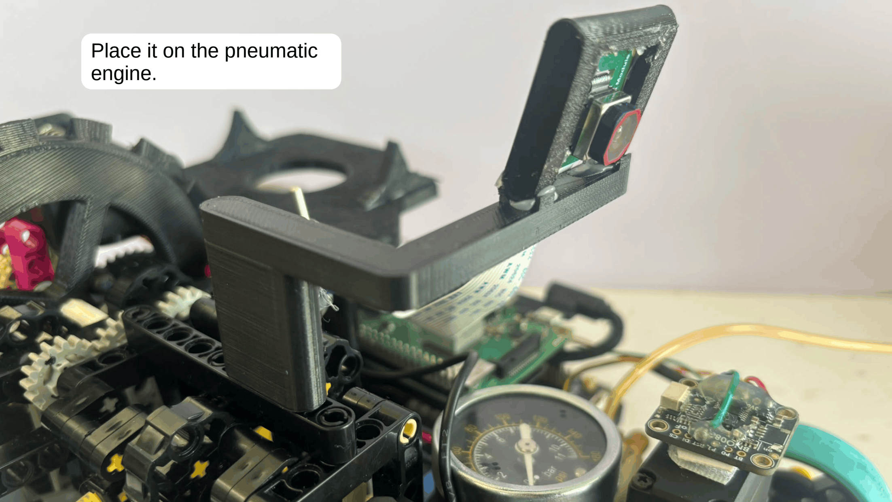
build_guide/Step06/Chassis(53).png
