SebicheParrilla/The-primis/build_guide/Step06/Chassis(54).png

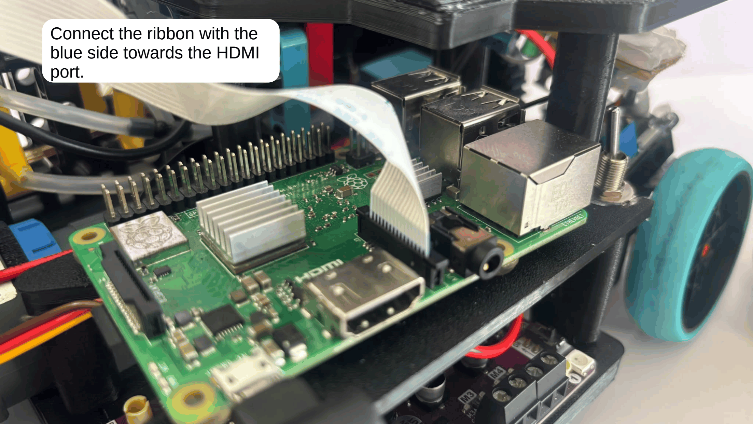
build_guide/Step06/Chassis(54).png
