SebicheParrilla/The-primis/media/photos/AIZA (6).jpeg

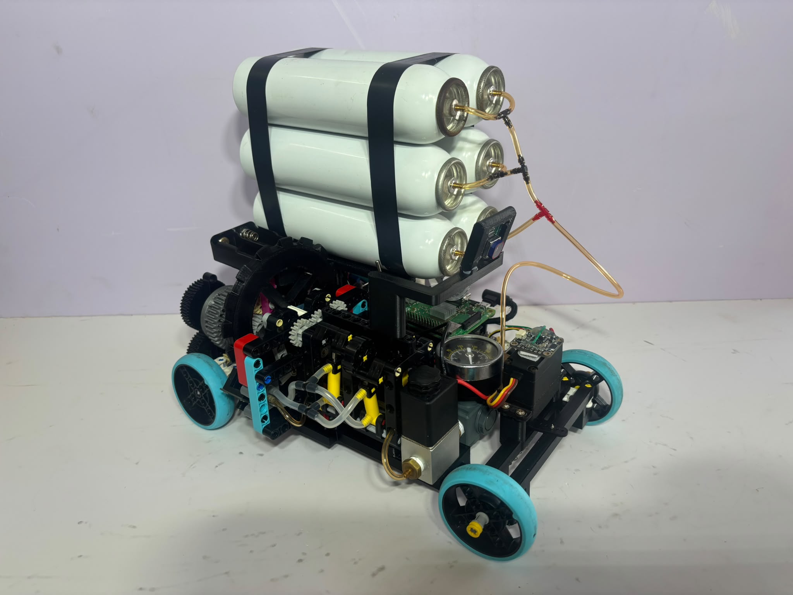
media/photos/AIZA (6).jpeg
