SebicheParrilla/The-primis/media/photos/pneng2.1front.jpg

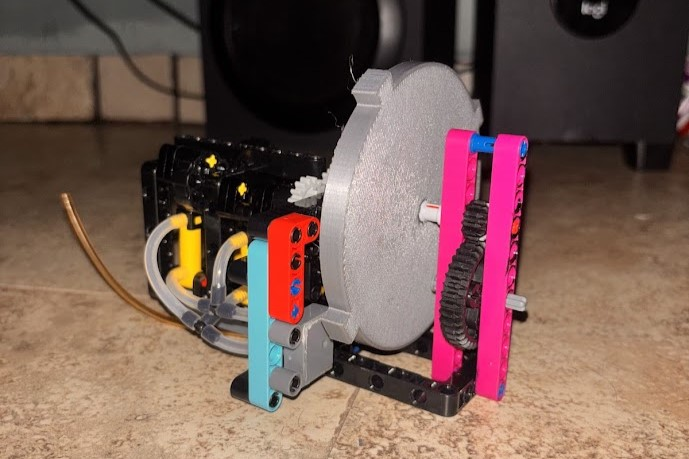
media/photos/pneng2.1front.jpg
