SebicheParrilla/The-primis/media/photos/pneuma2.1back.jpg

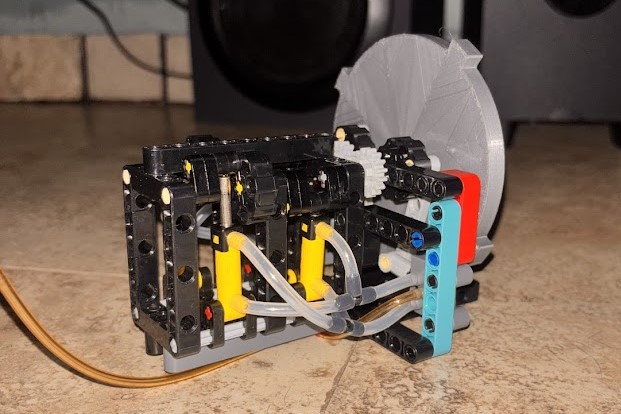
media/photos/pneuma2.1back.jpg
