SebicheParrilla/The-primis/media/photos/Stroke11_croppedpainted.jpg

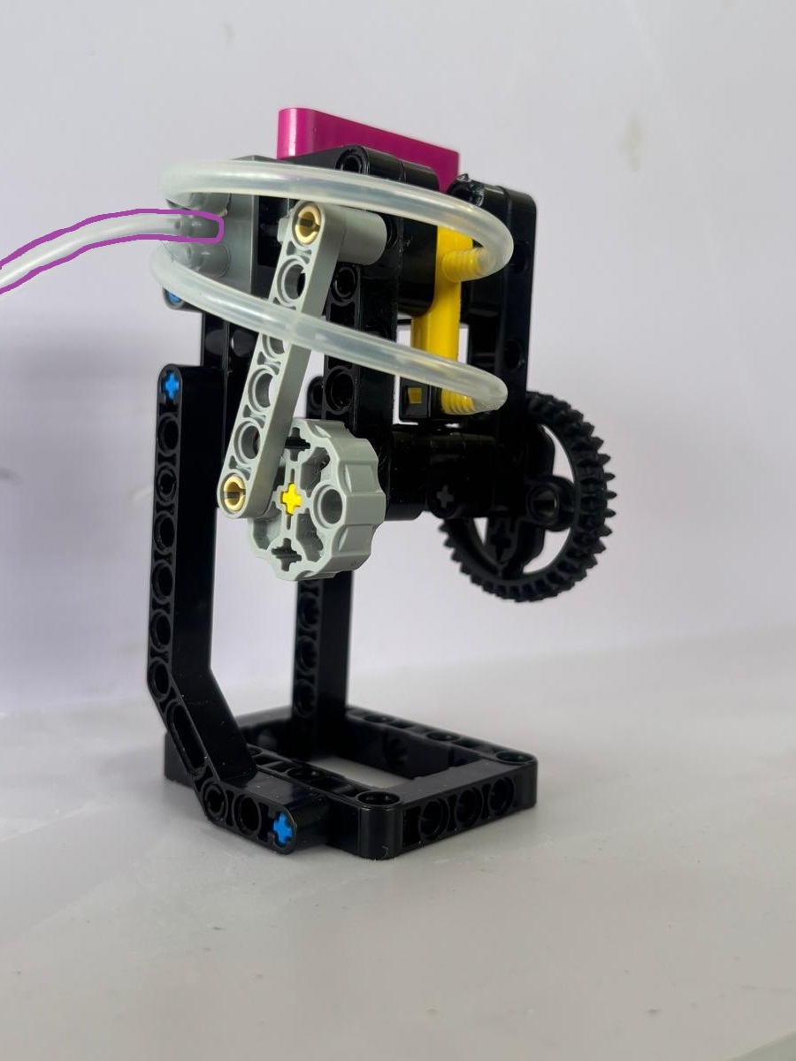
media/photos/Stroke11_croppedpainted.jpg
