SebicheParrilla/The-primis/media/team_photos/WhatsApp Image 2026-04-29 at 11.09.17 PM.jpeg

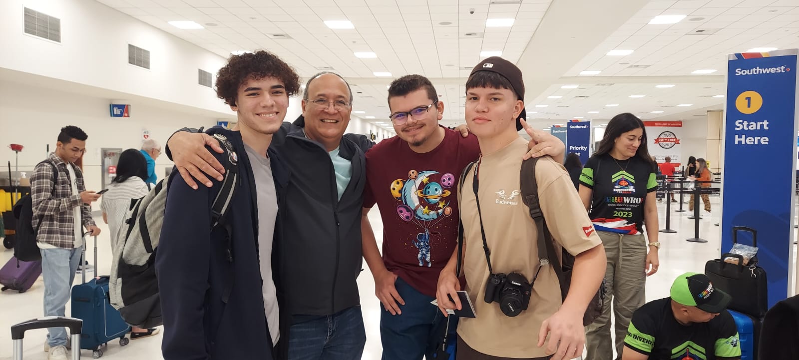
media/team_photos/WhatsApp Image 2026-04-29 at 11.09.17 PM.jpeg
