SebicheParrilla/The-primis/t-photos/XT48179.jpg

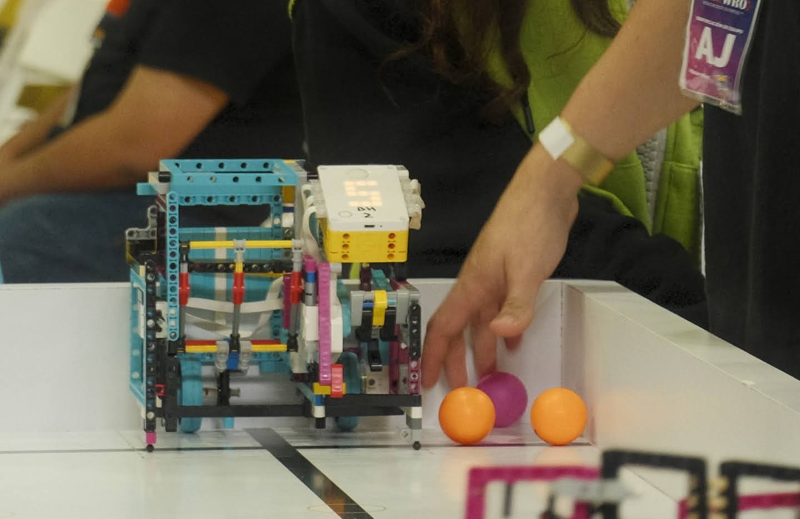
t-photos/XT48179.jpg
