SebicheParrilla/The-primis/LEGO_BOM.md

<div align= "center">
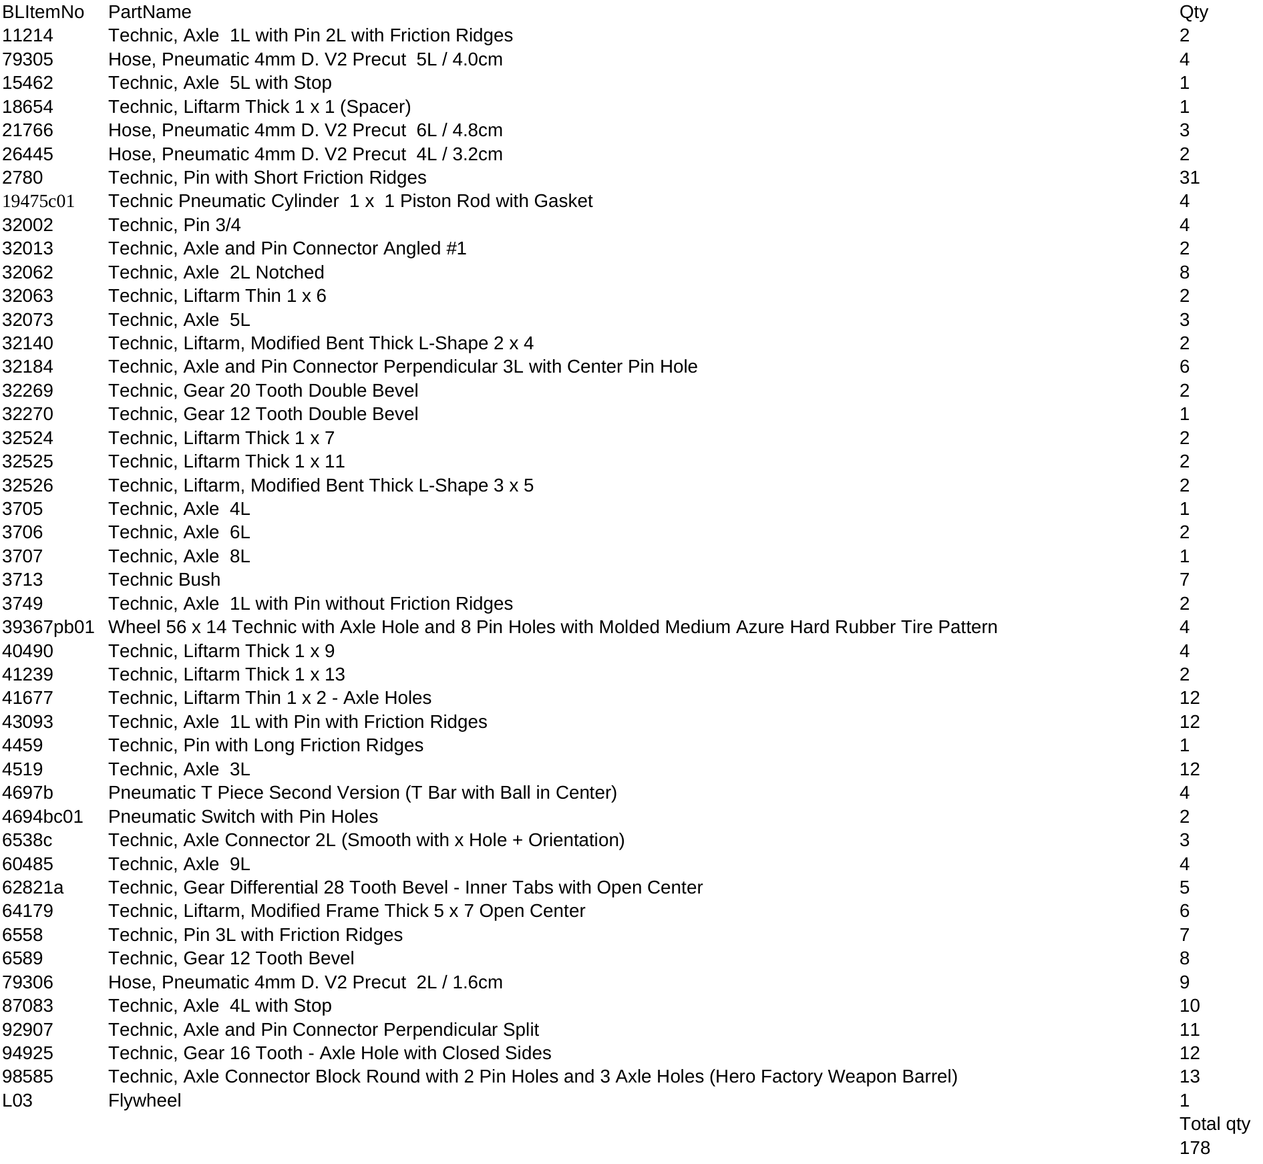
[picture p97: media/photos/Complete Pneumatic Engine V 2.1-1.png]

</div>
