SebicheParrilla/The-primis/media/CAD/STL/Steering_Center_link.stl

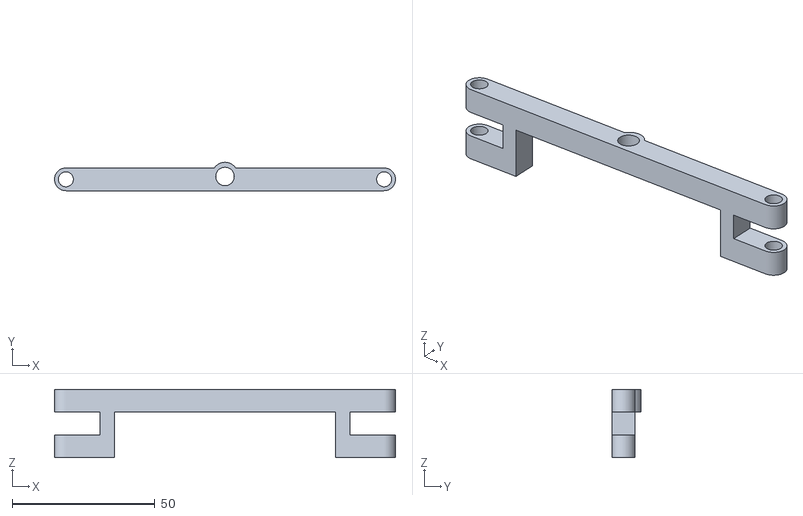
[picture p98: CAD file, 2026-11-11]
media/CAD/STL/Steering_Center_link.stl
119.6 x 9.99 x 23.9
