SebicheParrilla/The-primis/media/CAD/STL/RaspberryBase1.stl

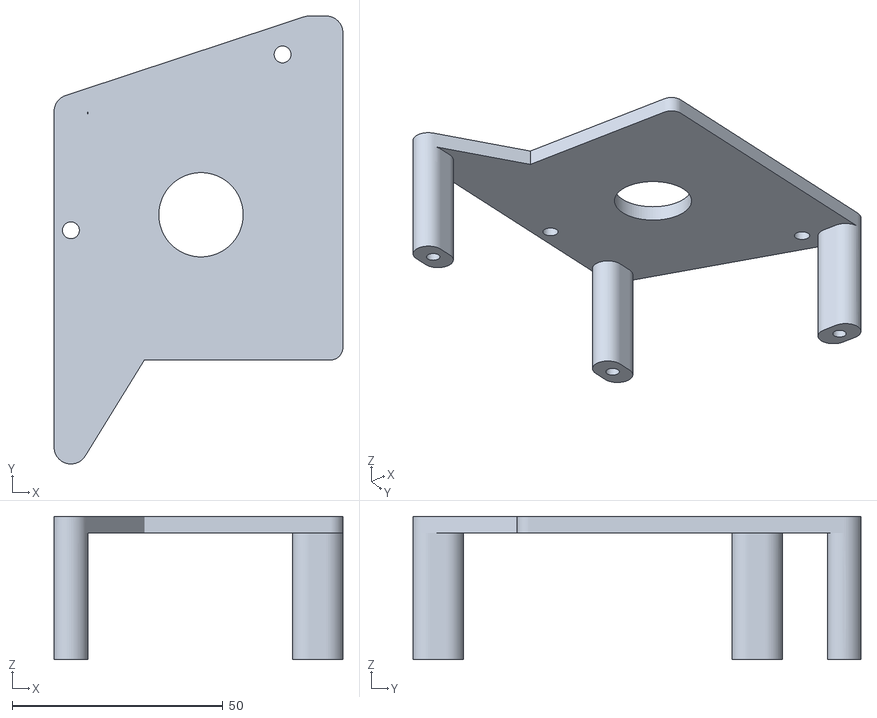
[picture p99: CAD file, 2026-11-11]
media/CAD/STL/RaspberryBase1.stl
68.6 x 106.3 x 34.0
