SebicheParrilla/The-primis/media/CAD/STL/Steering_Base_stiff.stl

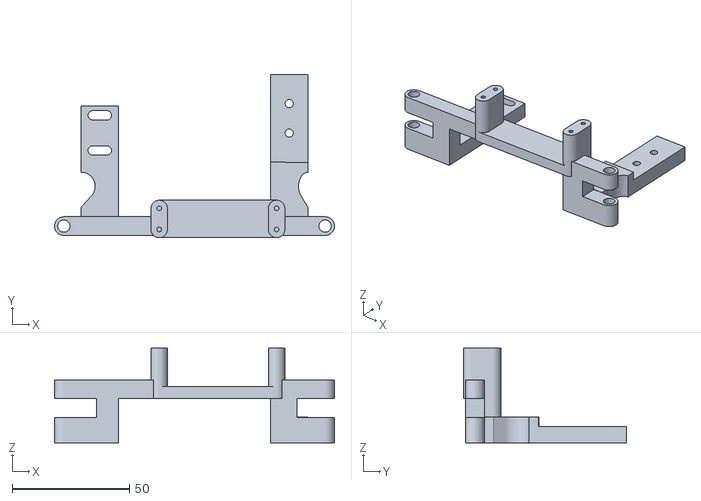
[picture p100: CAD file, 2026-11-11]
media/CAD/STL/Steering_Base_stiff.stl
119.6 x 69.7 x 40.5
