SebicheParrilla/The-primis/media/CAD/STL/Camera_Base.stl

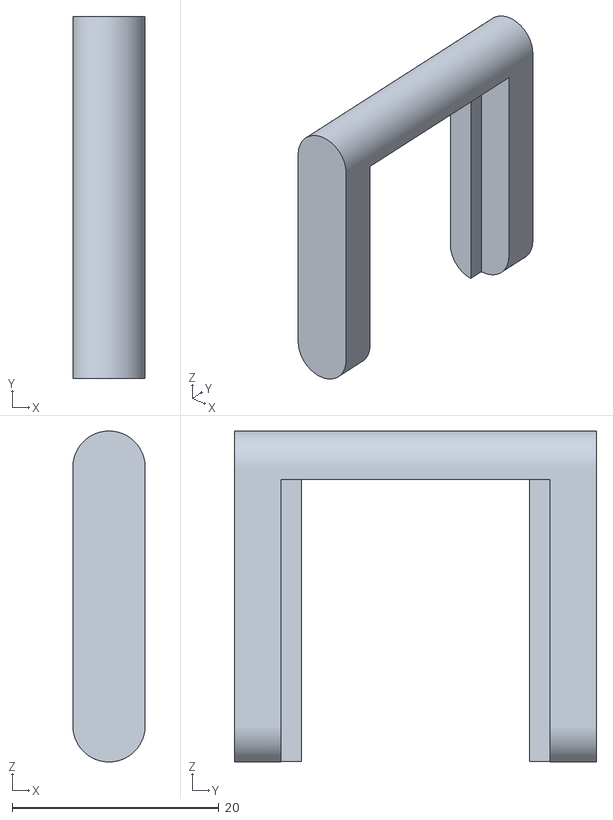
[picture p101: CAD file, 2026-11-11]
media/CAD/STL/Camera_Base.stl
7.00 x 35.0 x 32.0
