SebicheParrilla/The-primis/media/CAD/STL/Car_Frame_3.stl

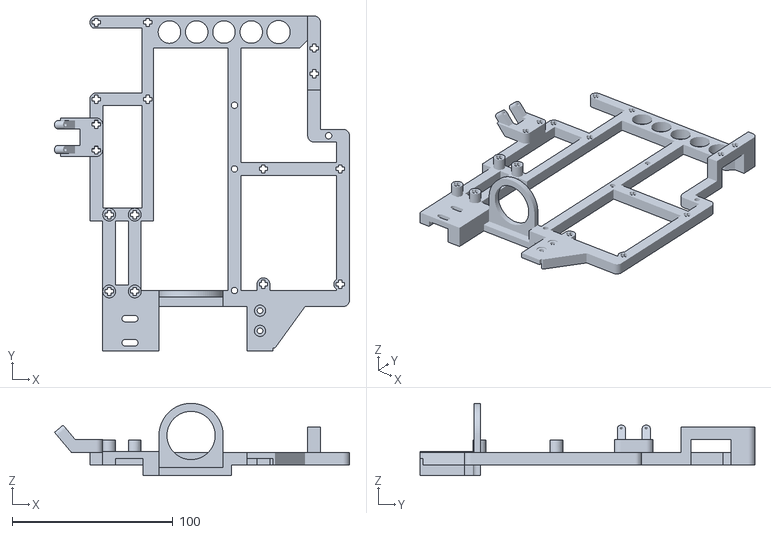
[picture p102: CAD file, 2026-11-11]
media/CAD/STL/Car_Frame_3.stl
183.5 x 208.4 x 45.0
