SebicheParrilla/The-primis/media/CAD/STL/Air_tanks_Base_3.stl

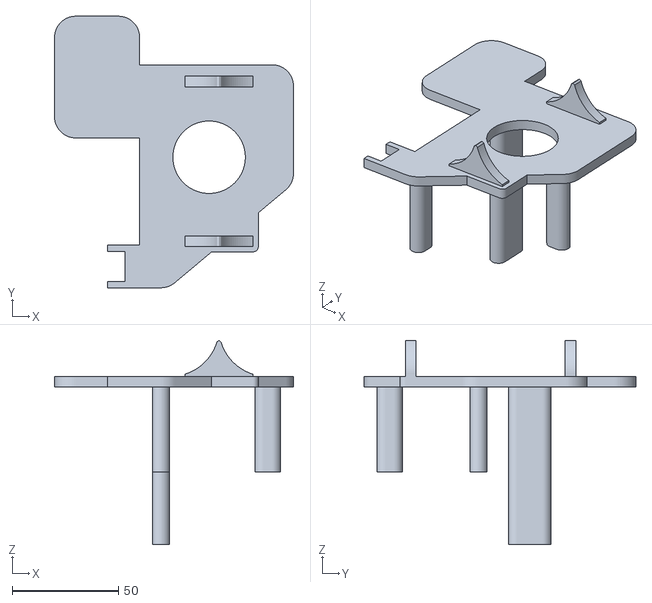
[picture p103: CAD file, 2026-11-11]
media/CAD/STL/Air_tanks_Base_3.stl
112.2 x 127.5 x 95.9
