SebicheParrilla/The-primis/media/CAD/STL/Camera_arm.stl

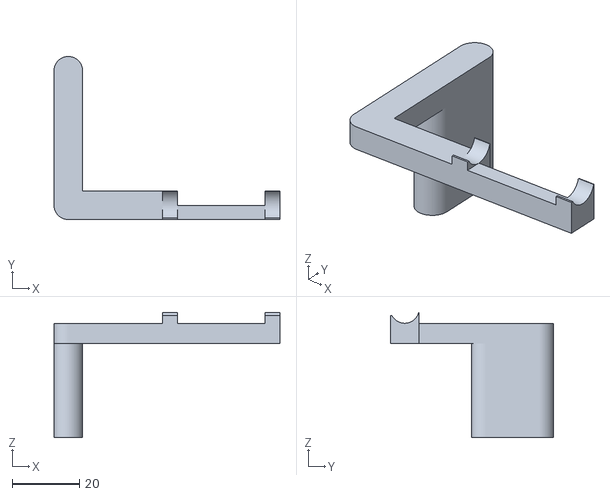
[picture p104: CAD file, 2026-11-11]
media/CAD/STL/Camera_arm.stl
67.2 x 48.5 x 37.2
