SebicheParrilla/The-primis/media/CAD/STL/output_Gears.stl

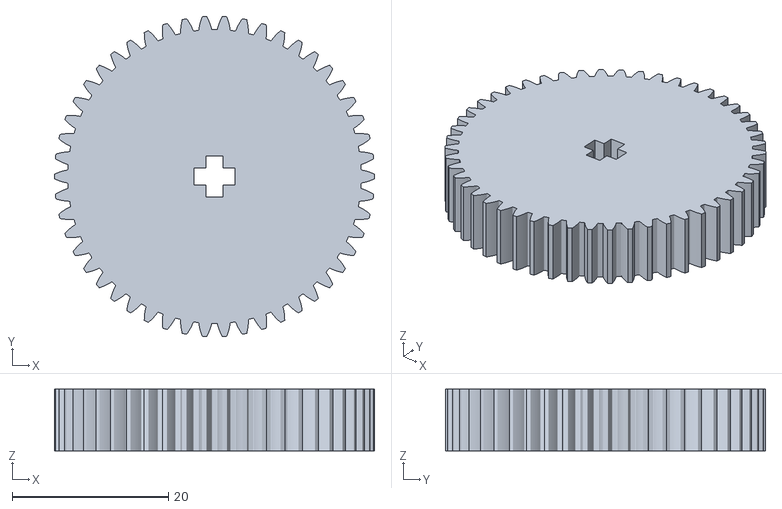
[picture p105: CAD file, 2026-11-11]
media/CAD/STL/output_Gears.stl
41.0 x 41.0 x 7.90
