SebicheParrilla/The-primis/media/CAD/STL/Flywheel_2.stl

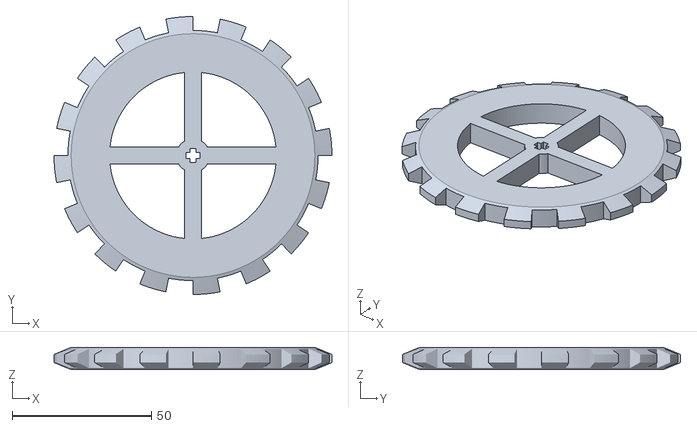
[picture p106: CAD file, 2026-10-28]
media/CAD/STL/Flywheel_2.stl
100.0 x 100.0 x 7.97
