SebicheParrilla/The-primis/media/CAD/STL/Trans_Output_Base.stl

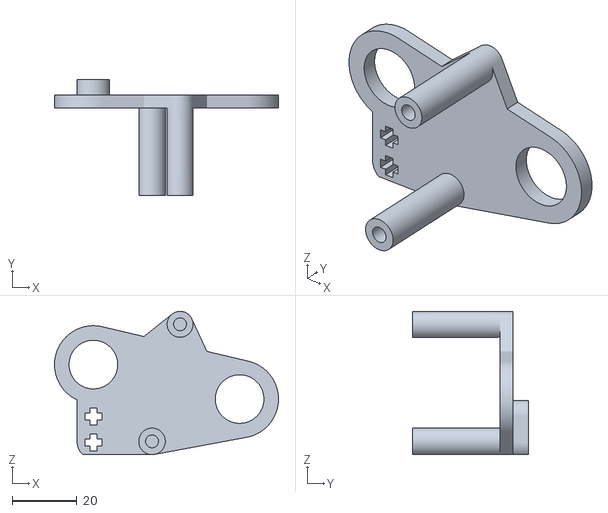
[picture p107: CAD file, 2026-10-28]
media/CAD/STL/Trans_Output_Base.stl
69.1 x 35.9 x 44.2
