SebicheParrilla/The-primis/media/CAD/STL/Ring_Gear_30.stl

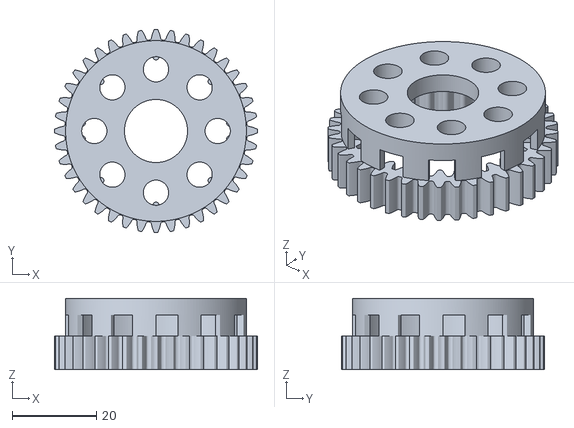
[picture p108: CAD file, 2026-10-28]
media/CAD/STL/Ring_Gear_30.stl
48.3 x 48.3 x 17.0
