SebicheParrilla/The-primis/media/CAD/STL/Dead_Planet_carrier.stl

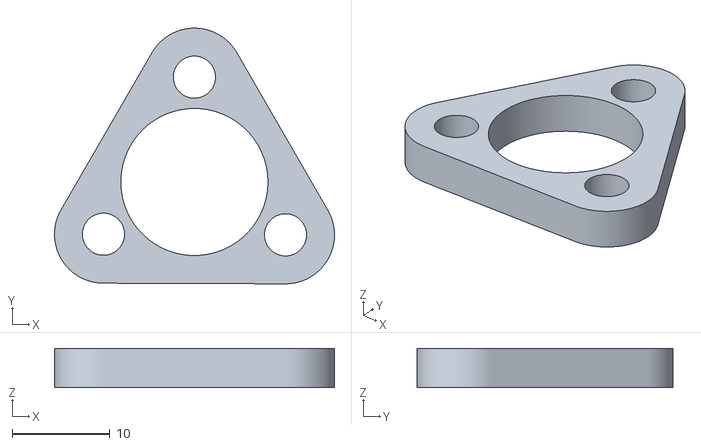
[picture p109: CAD file, 2026-10-28]
media/CAD/STL/Dead_Planet_carrier.stl
28.6 x 26.1 x 4.00
