SebicheParrilla/The-primis/media/CAD/STL/Sun_Gear.stl

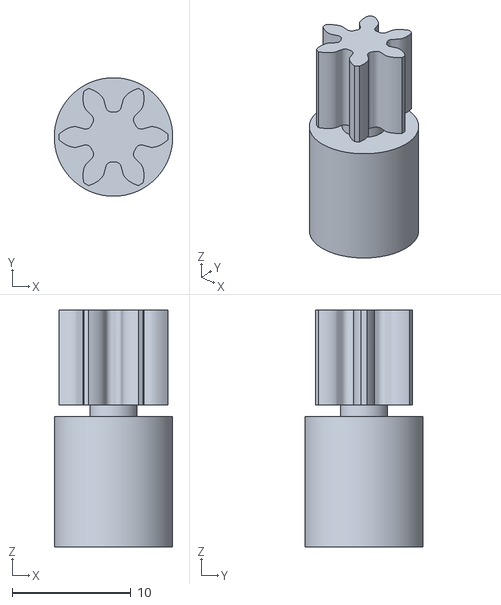
[picture p110: CAD file, 2026-10-28]
media/CAD/STL/Sun_Gear.stl
10.00 x 10.00 x 20.0
