SebicheParrilla/The-primis/media/CAD/STL/Trans_Motor_Gear.stl

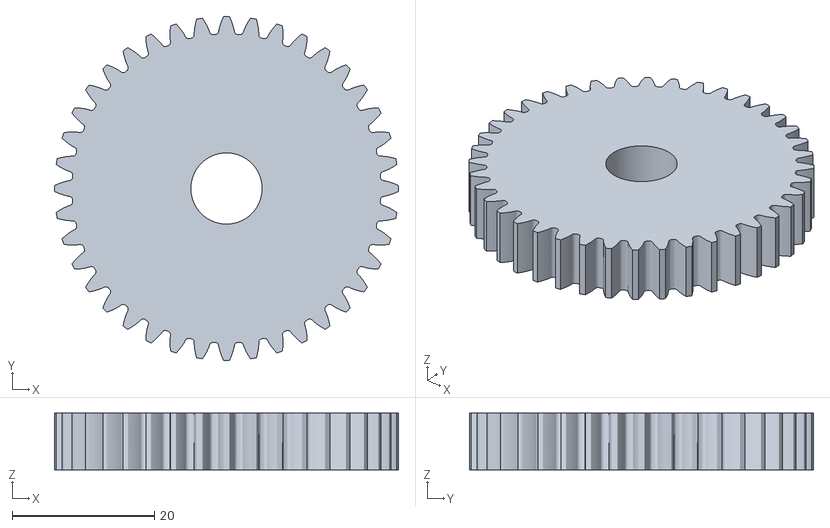
[picture p111: CAD file, 2026-10-28]
media/CAD/STL/Trans_Motor_Gear.stl
48.3 x 48.3 x 8.00
