SebicheParrilla/The-primis/media/CAD/STL/Trans_Base_2.stl

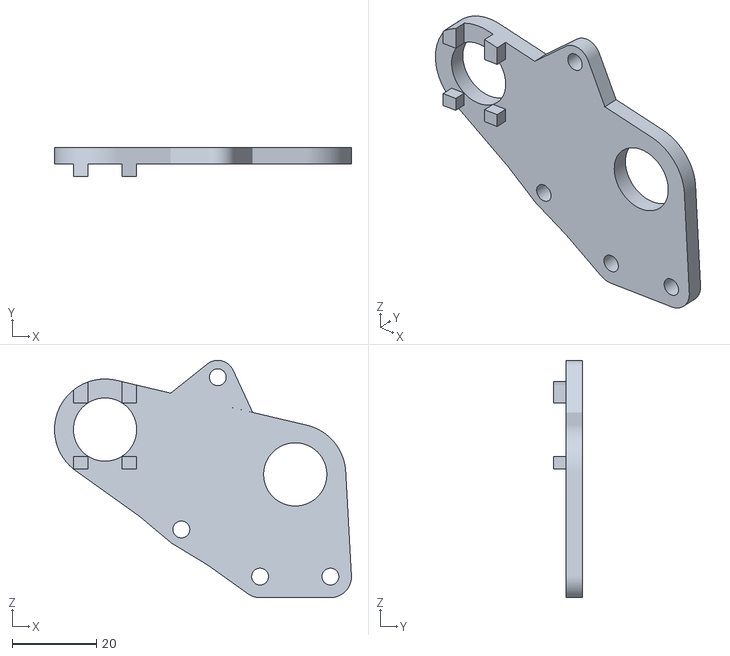
[picture p112: CAD file, 2026-10-28]
media/CAD/STL/Trans_Base_2.stl
70.5 x 7.00 x 56.3
