SebicheParrilla/The-primis/media/CAD/STL/Motor_Axle.stl

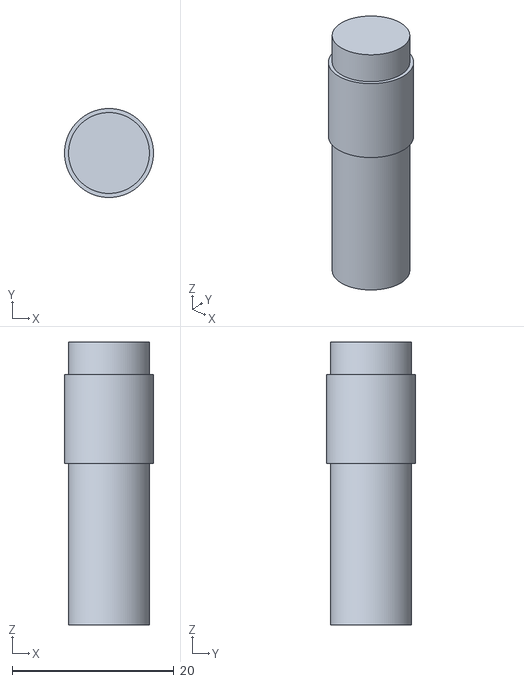
[picture p113: CAD file, 2026-10-28]
media/CAD/STL/Motor_Axle.stl
11.0 x 11.0 x 35.0
