SebicheParrilla/The-primis/media/CAD/STL/Planet_Gear.stl

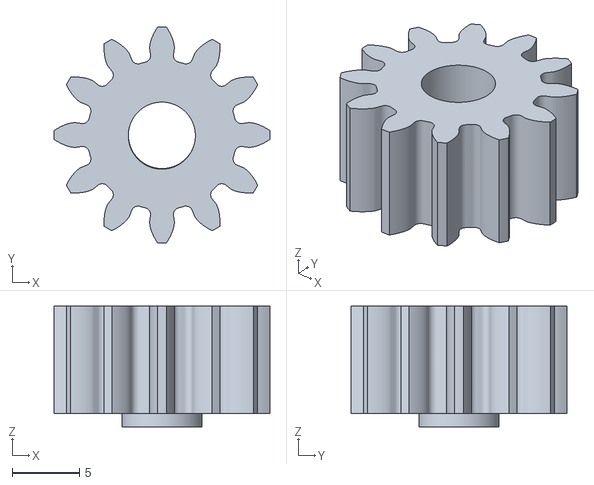
[picture p114: CAD file, 2026-10-28]
media/CAD/STL/Planet_Gear.stl
16.1 x 16.1 x 9.00
