SebicheParrilla/The-primis/media/CAD/STL/Live_Planet_Carrier_2.stl

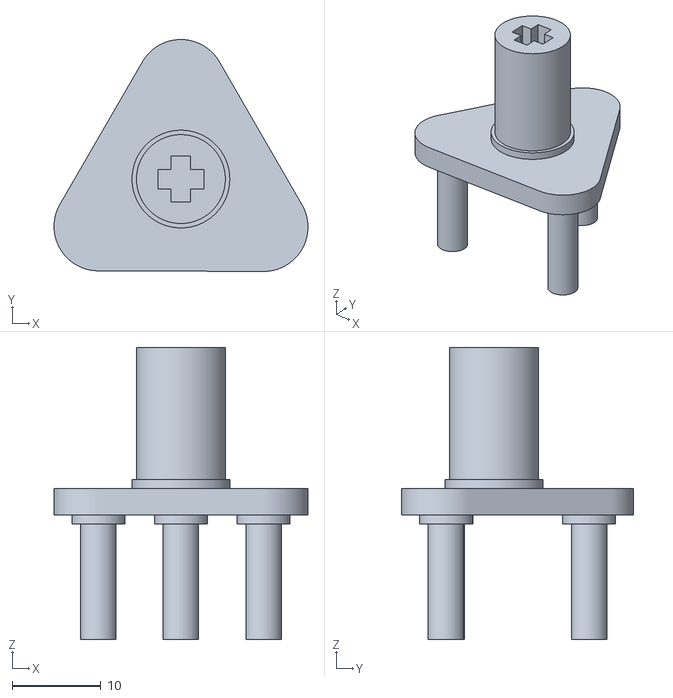
[picture p115: CAD file, 2026-10-28]
media/CAD/STL/Live_Planet_Carrier_2.stl
28.6 x 26.1 x 32.9
