SebicheParrilla/The-primis/media/CAD/STL/Purple wall.stl

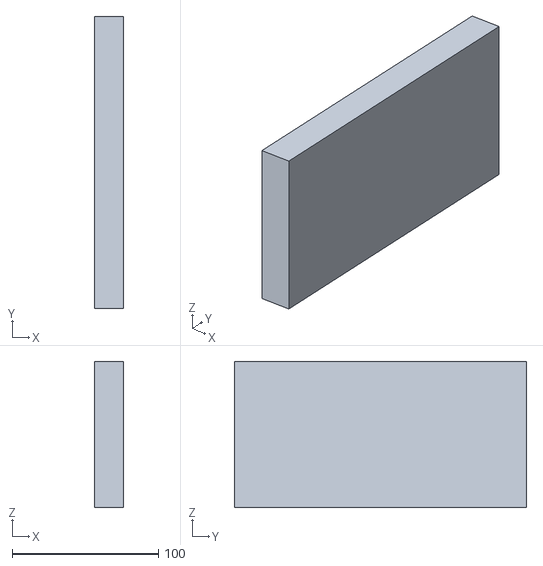
[picture p116: CAD file, 2026-10-27]
media/CAD/STL/Purple wall.stl
20.0 x 200.0 x 100.0
