SebicheParrilla/The-primis/build_guide/Step01.md

# Build Guide

This is the complete guide for anyone that want to make our robot!

Please read the documents thuroghly. Instructions are labled in numeric order, once you finish the steps of a document, continue with the next one with the link provided.

### Time and cost estimate 

(PLACEHOLDER: detail total time and cost)

# 01 Lego components and flywheel

We'll start with the lego components, that includes the Pneumatic engine, parts of the drivetrain and the two front knucle and wheel asembly.

Components you'll need:

STL files for printing the components:

[Pneumatic engine flywheel STL]()
