SebicheParrilla/The-primis/build_guide/Step01/Step01.md

# Build Guide

This is the complete guide for anyone that want to make our robot!

Complete the steps from top to bottom entirely, once you finish the steps of a document continue with the next one by clicking the link at the end of the finnished document.

### Total materials

The cost of following the entire instructions. 

<div align= "center">
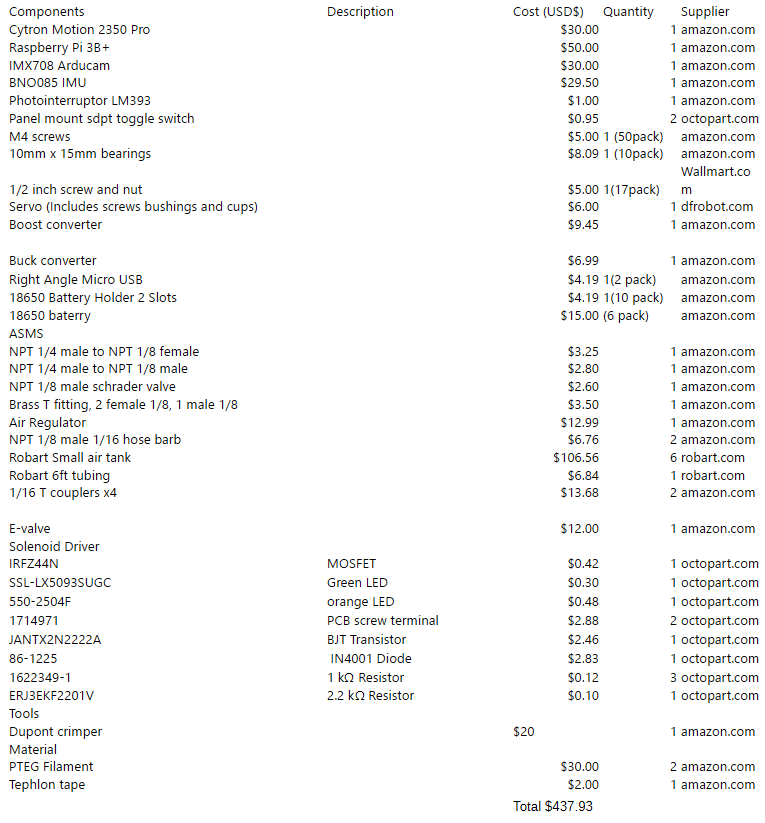
[picture p117: media/photos/BOM.png]

</div>

[CLick here to start building!](../Step02/00Lego.md)
