SebicheParrilla/The-primis/build_guide/Step02/00Lego.md

# Step 2: Lego Components

In this step we'll asemble the entire lego drivetrain and the two front wheel knuckles.
## Materials and components
### Components to print:

| Component | Code | STL File |
|---|---|---|
| Pneumatic Engine's Flywheel | L03 | [Download STL](../../media/CAD/STL/Flywheel_2.stl) |

### LEGO pieces

<div align= "center">

</div>

Since almost all LEGO pieces that you bought are going to be used in this step, we don't think you need to separate these pieces from the rest.

---

[When you're finished preping the materials you can start asembling the LEGO components in order, page 1 linked here.](01Lego.png)
