SebicheParrilla/The-primis/build_guide/Step04/ASMS(00).md

# Step 4: ASMS

## Step 4.1 Components
Locate and prepare every component
| Component | Amount |
|:--|--:|
| Pneumatic Air Tanks | x6 |
| Pressure Regulator | x1 |
| E-Valve  | x1 |
| NPT M¼ to NPT F⅛  brass fitting | x1 |
| NPT M¼ to NPT M⅛ | x1 |
| Brass T fitting, 2x F⅛, 1x M⅛| x1 |
| NPT M⅛ to ¹⁄₁₆ hose barb| x2 |
| NPT M⅛ schrader valve| x1 |
| High pressure hose cut to 40mm| x9 |
| High pressure hose cut to 70mm| x1 |
| High pressure hose cut to 120mm| x1 |
| High pressure T fitting for hose| x5 |

## Step 4.2  Tools and materials

| Component | Quantity |
|---|---|
| Adjustable wrench | x2 |
| Tephlon tape  | x2 |

[Once you have all the materials and objects printed go to the next step linked here.](../ASMS(01).png)
