SebicheParrilla/The-primis/build_guide/Step05/Steering(00).md

# Step 5: Steering 

## Step 5.1 3DPrinted components
Print every component and note quatities.
| Component | Code | STL File |
|---|---|---|
| Steering Base | S01 | [Download STL](../../media/CAD/STL/Steering_Base_stiff.stl) |
| Center link | S02 |[Download STL](../../media/CAD/STL/Steering_Center_link.stl)|

## Step 2.2  Miscelanious components

| Component | Quantity |
|---|---|
| 1/2' Nuts  | x2 |
| Lego Wheel knuckles (L02) | x2 |
| Servo | x1 |
| Servo bushings | x5 |
| Servo bushing cups | x5 |
| Servo Screws | x5 |
| Servo Pitman | x1 |

[Once you have all the materials and objects printed go to the next step linked here.](../Steering(01).png)
