SebicheParrilla/The-primis/build_guide/Step03/eCVT01.md

# Step 3: eCVT BOM

## Step 3.1 3DPrinted components
Print every component and note quatities.
| Component | Code | STL File |
|---|---|---|
| Ring gear | e01 | [Download STL](../../media/CAD/STL/Ring_Gear_30.stl) |
| Live Planet Carrier | e02 |[Download STL](../../media/CAD/STL/Live_Planet_Carrier_2.stl)|
| **x3** Planet Gear  | e03 | [Download STL](../../media/CAD/STL/Planet_Gear.stl) |
| Sun Gear | e04 | [Download STL](../../media/CAD/STL/Sun_Gear.stl) |
| Dead Planet Carrier | e05 |[Download STL](../../media/CAD/STL/Dead_Planet_carrier.stl)|
| transmission Output Base  | e06 | [Download STL](../../media/CAD/STL/Trans_Output_Base.stl) |
| transmission motor Gear Shaft | e07 | [Download STL](../../media/CAD/STL/Motor_Axle.stl) |
| Transmission motor Gear | e08 |[Download STL](../../media/CAD/STL/Trans_Motor_Gear.stl)|
| Transmission Base | e10 | [Download STL](../../media/CAD/STL/Trans_Base_2.stl) |

## Step 3.2  Miscelanious components

| Component | Quantity |
|---|---|
| M4 Screws | x2 |
| 1/2' screws  | x2 |
| 10x15 bearings  | x5 |

[Once you have all the materials and objects printed go to the next step linked here.](eCVT02.png)
