SebicheParrilla/The-primis/build_guide/Step02/Lego53.md

# Lego components complete

These are the codes for the components you just made.
| Component | New Code |
|---|---|
| Pneumatic engine+drivetrain | L01 |
|2x Wheel knuckles | L02 |

[Feel free to continue to the next step, linked here.](../Step03/eCVT01.md)
