SebicheParrilla/The-primis/build_guide/Step02/9Lego.png

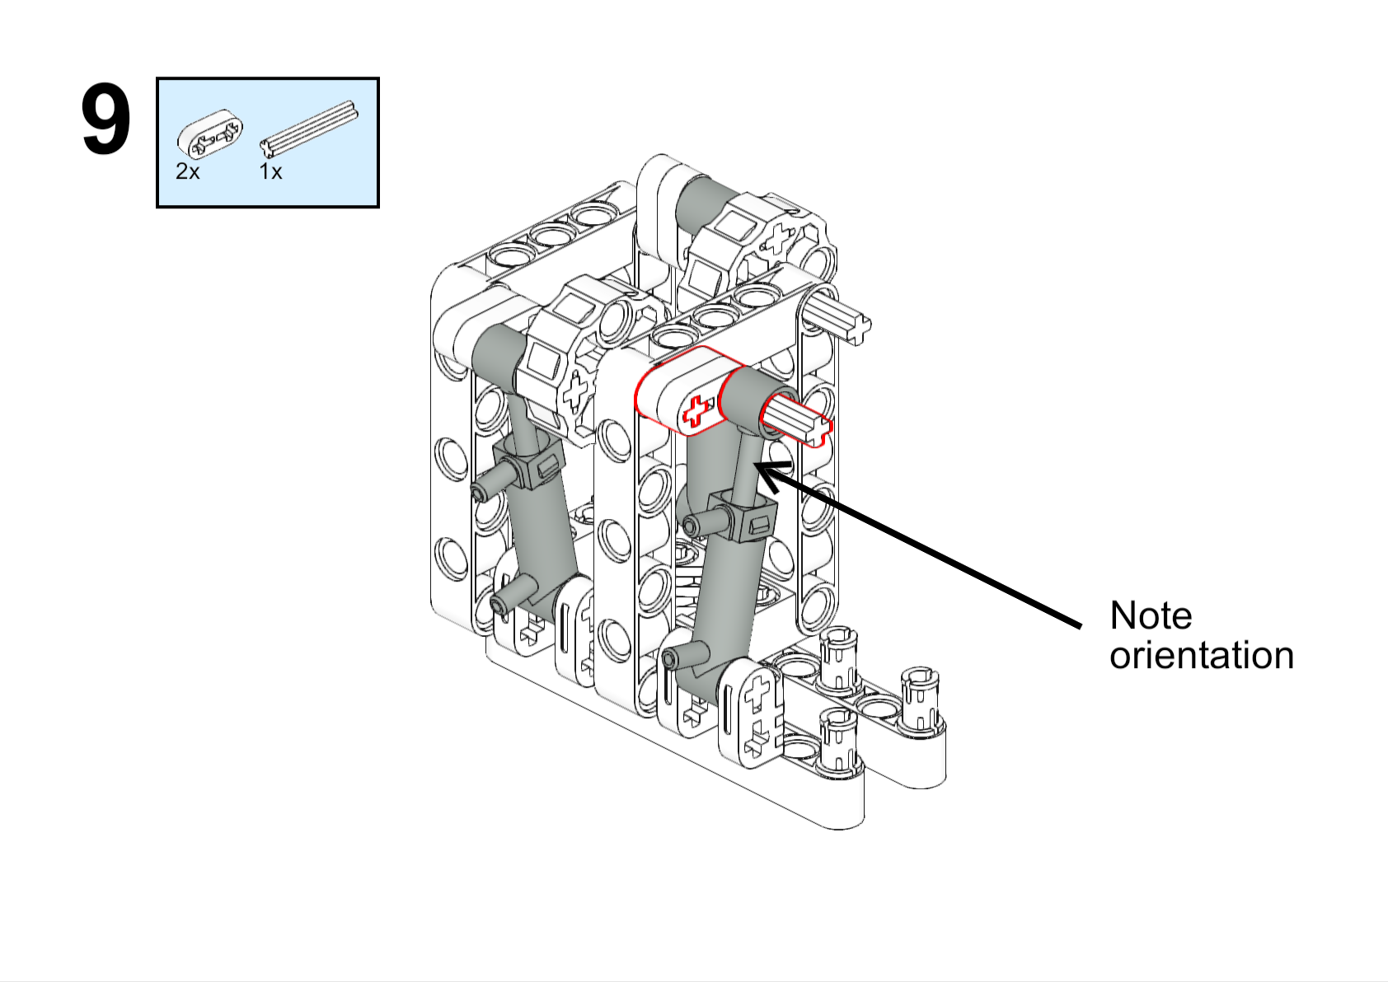
build_guide/Step02/9Lego.png
