SebicheParrilla/The-primis/build_guide/Step02/10Lego.png

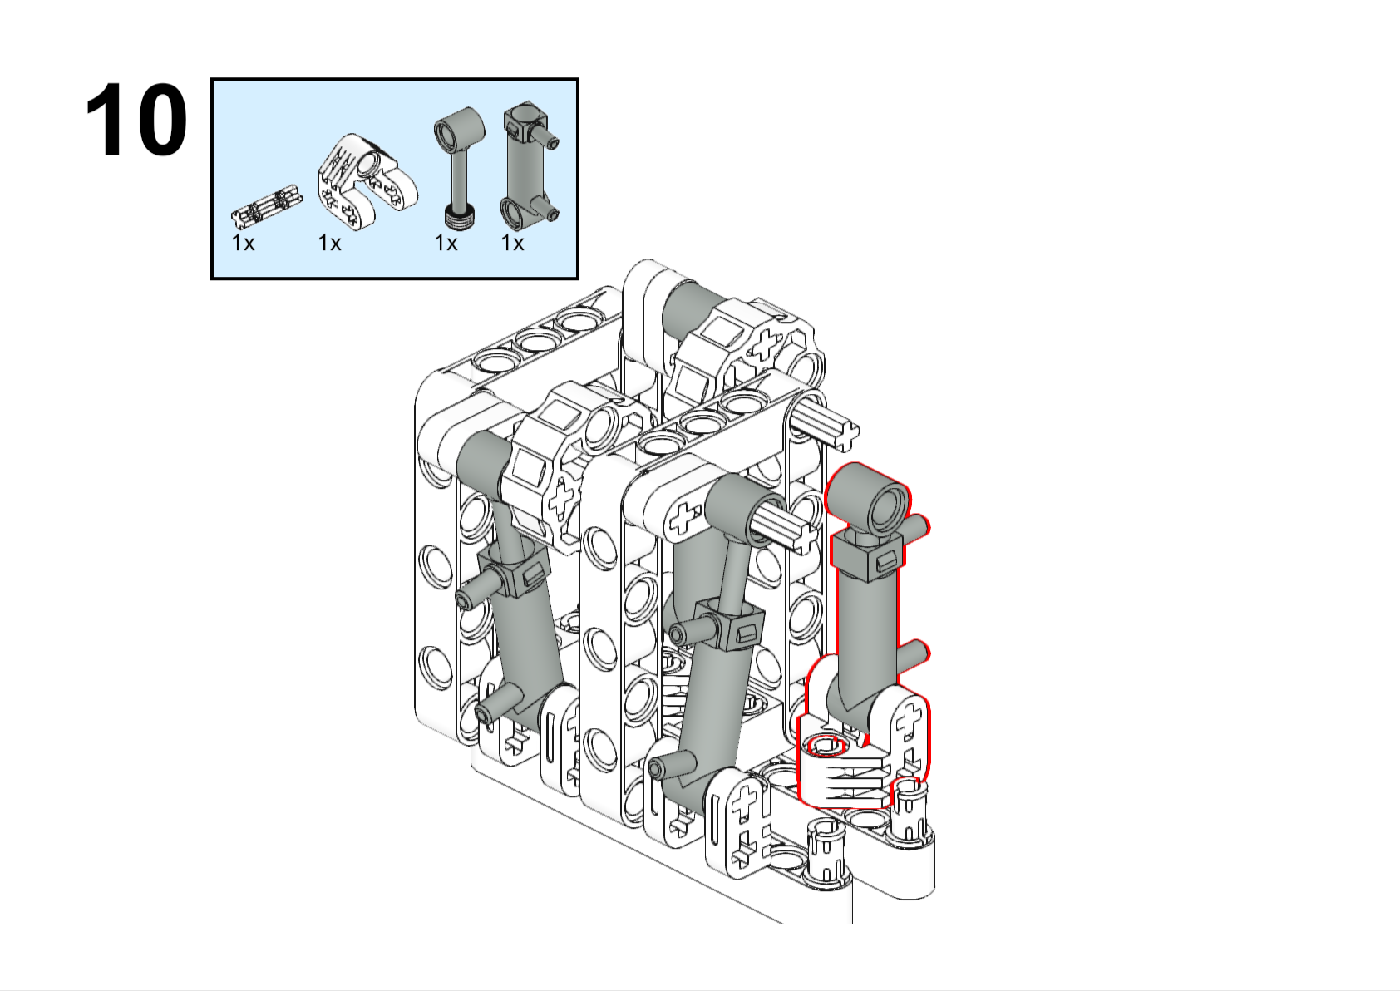
build_guide/Step02/10Lego.png
