SebicheParrilla/The-primis/build_guide/Step02/11Lego.png

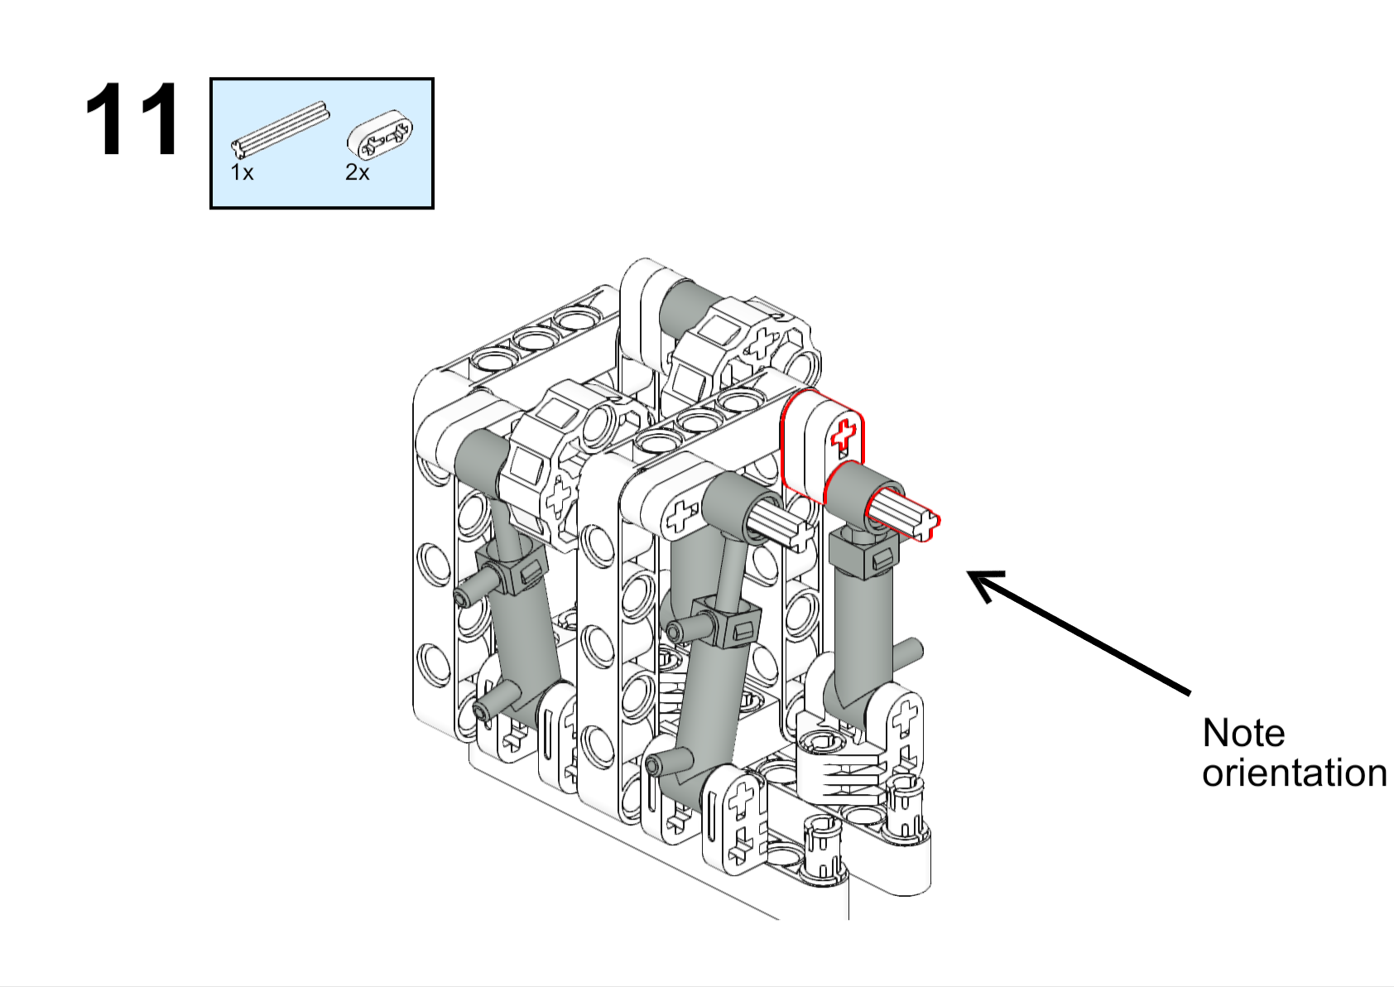
build_guide/Step02/11Lego.png
