SebicheParrilla/The-primis/build_guide/Step02/12Lego.png

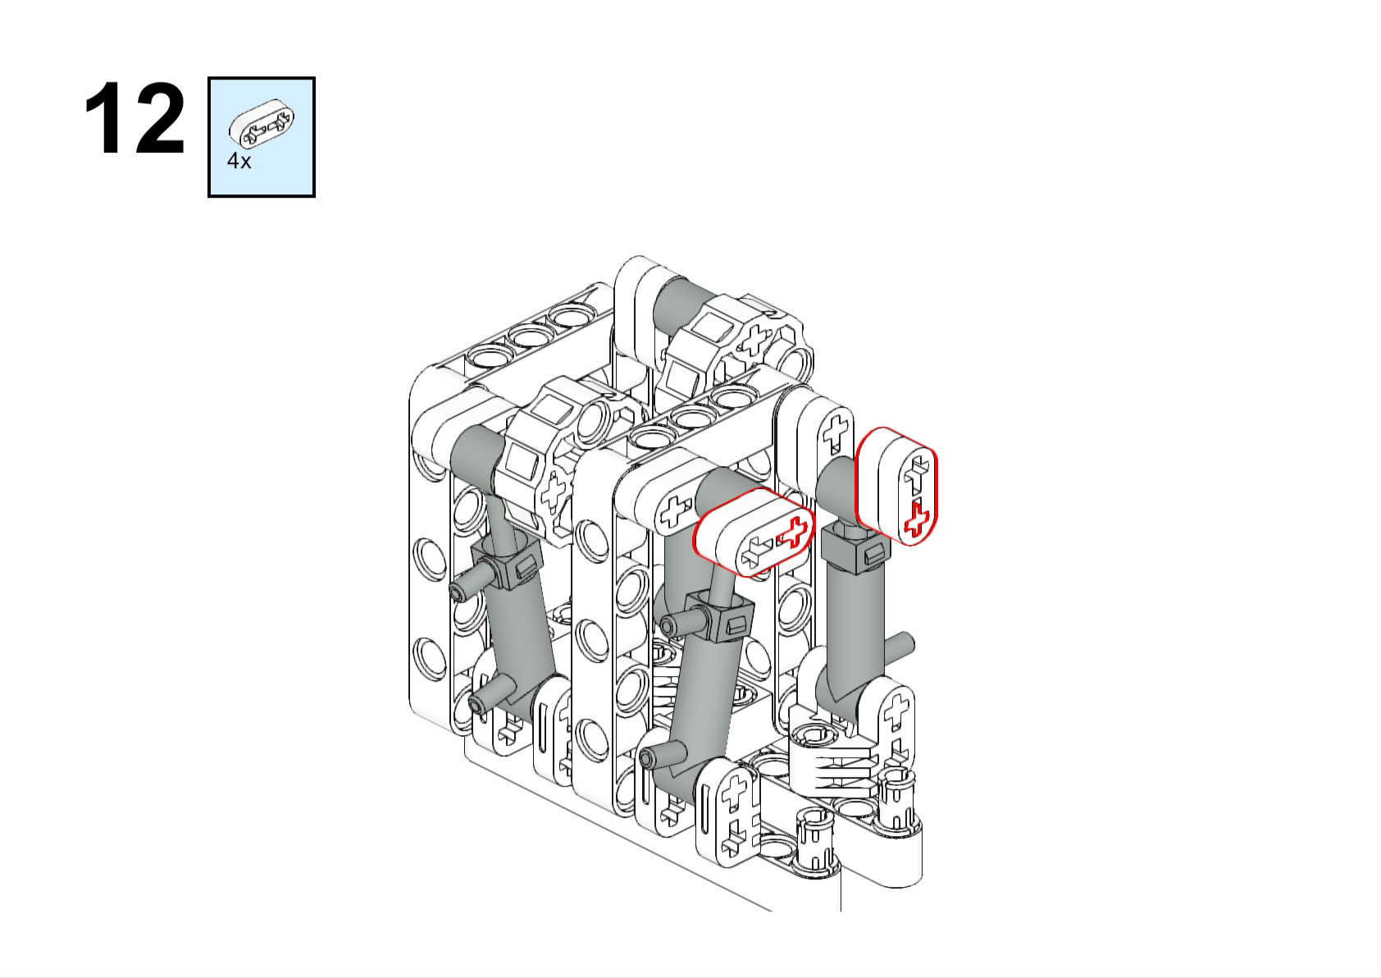
build_guide/Step02/12Lego.png
