SebicheParrilla/The-primis/build_guide/Step02/15Lego.png

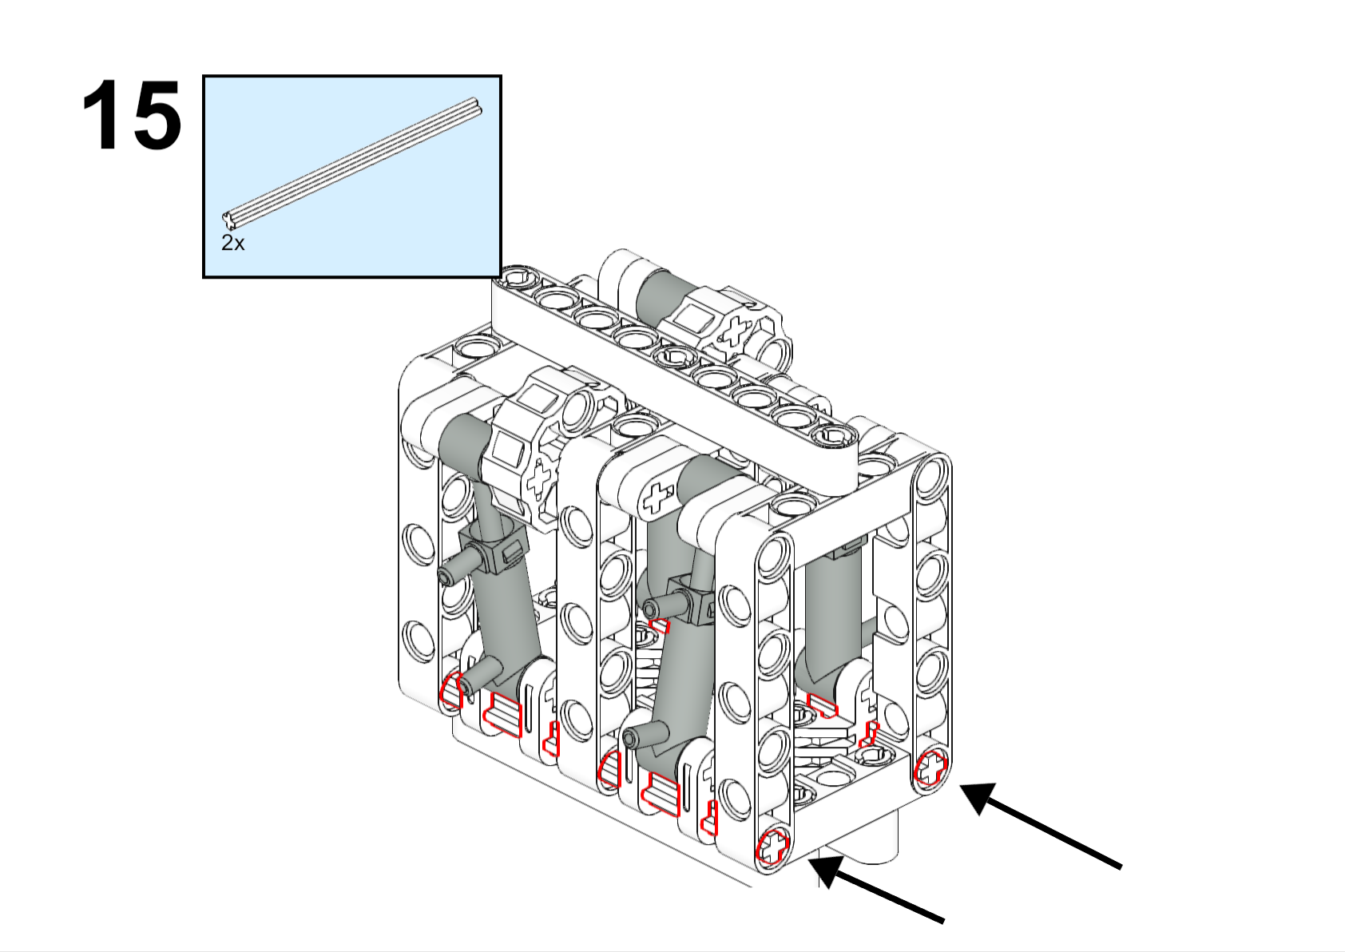
build_guide/Step02/15Lego.png
