SebicheParrilla/The-primis/build_guide/Step02/18Lego.png

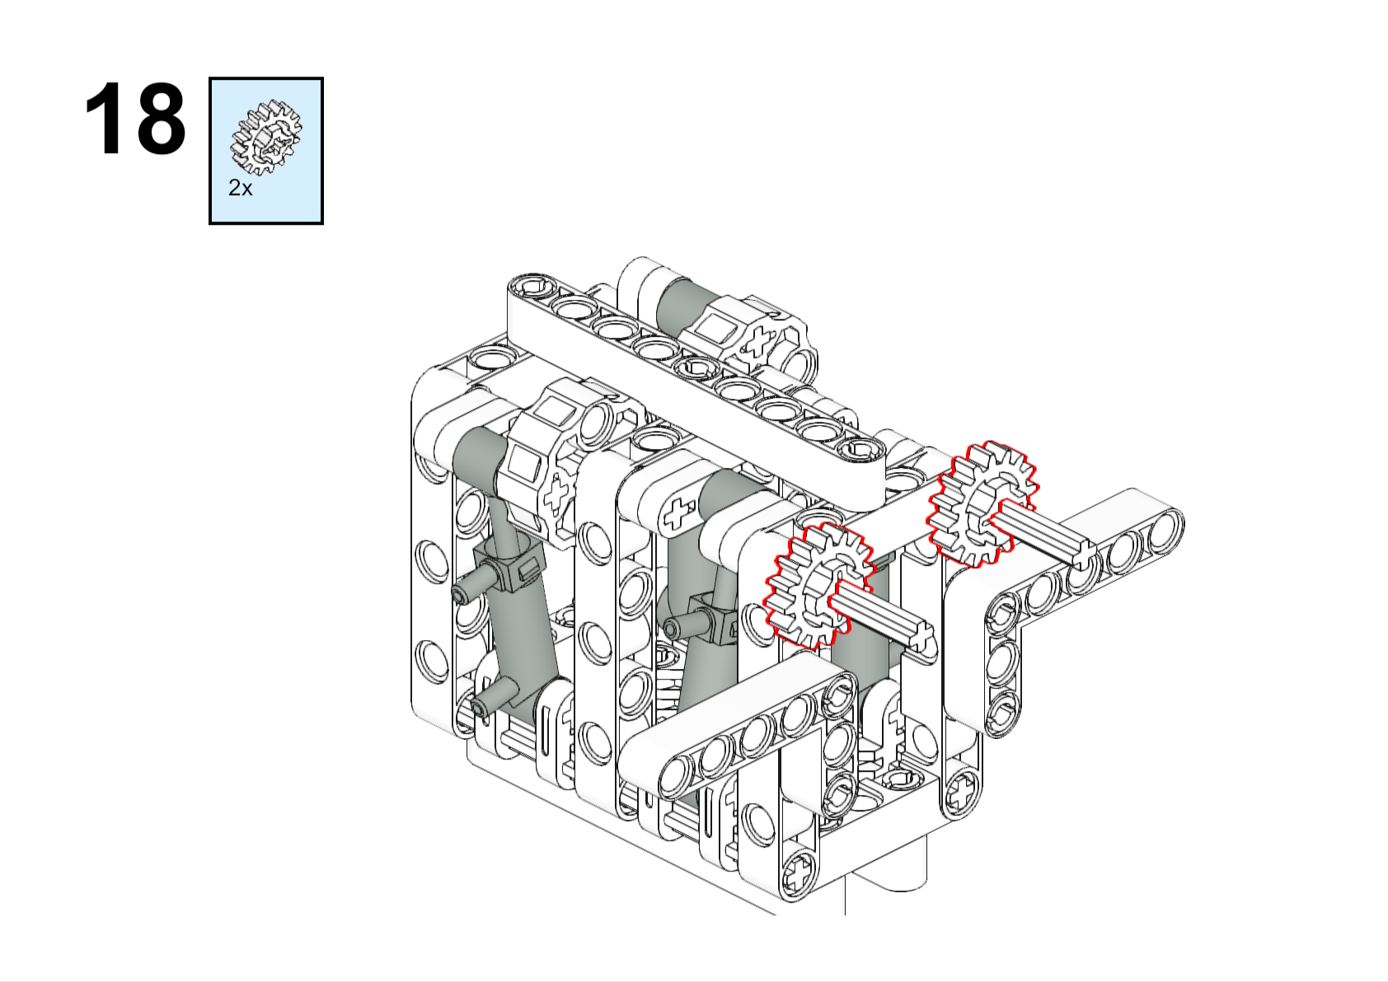
build_guide/Step02/18Lego.png
