SebicheParrilla/The-primis/build_guide/Step02/21Lego.png

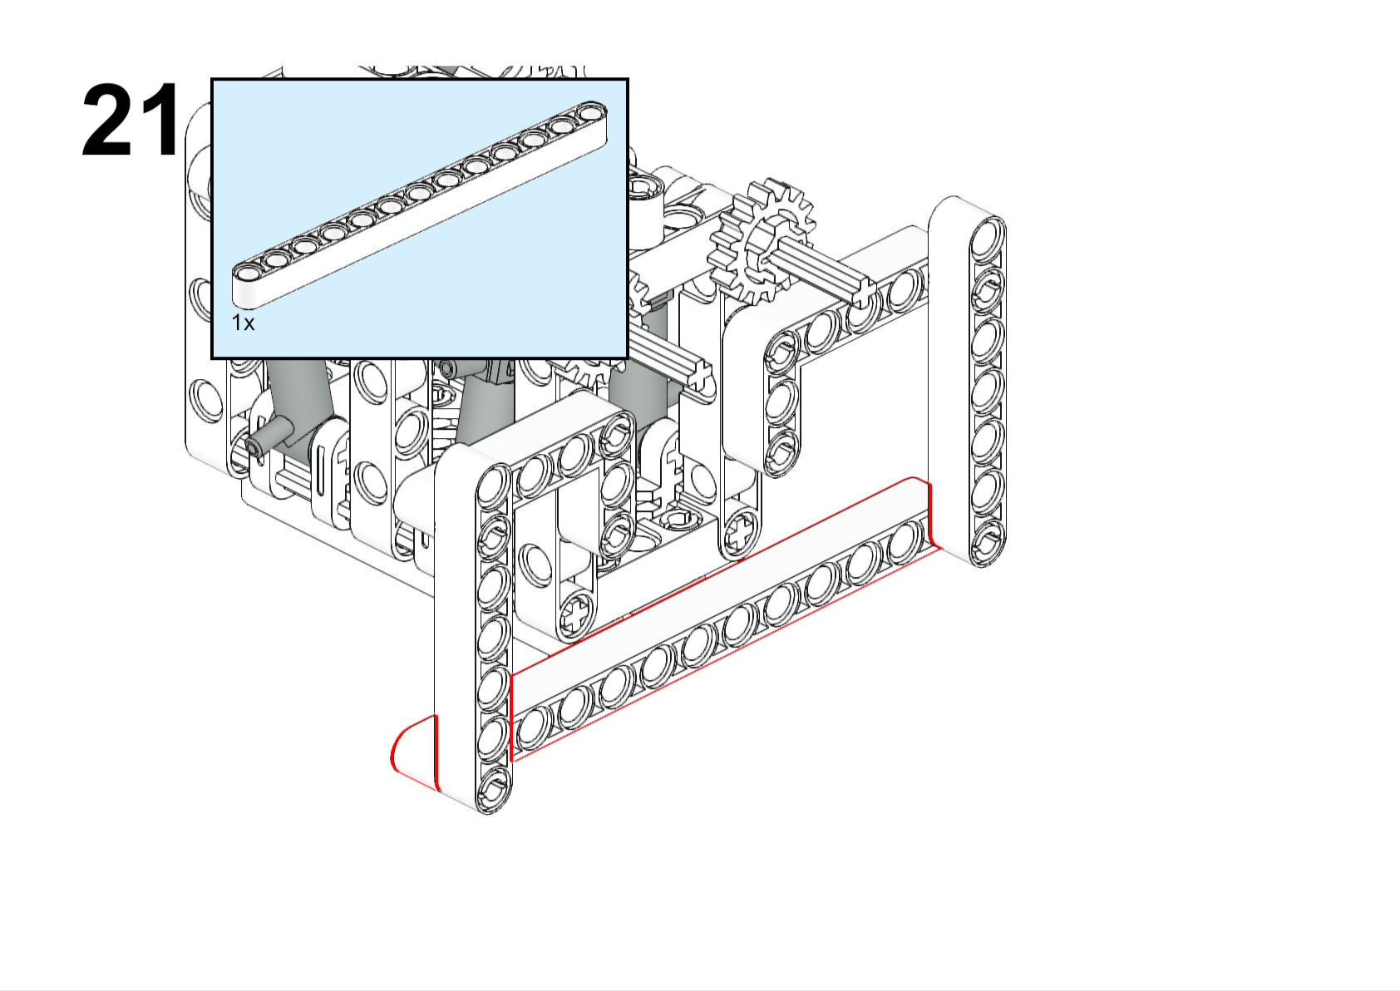
build_guide/Step02/21Lego.png
