SebicheParrilla/The-primis/build_guide/Step02/25Lego.png

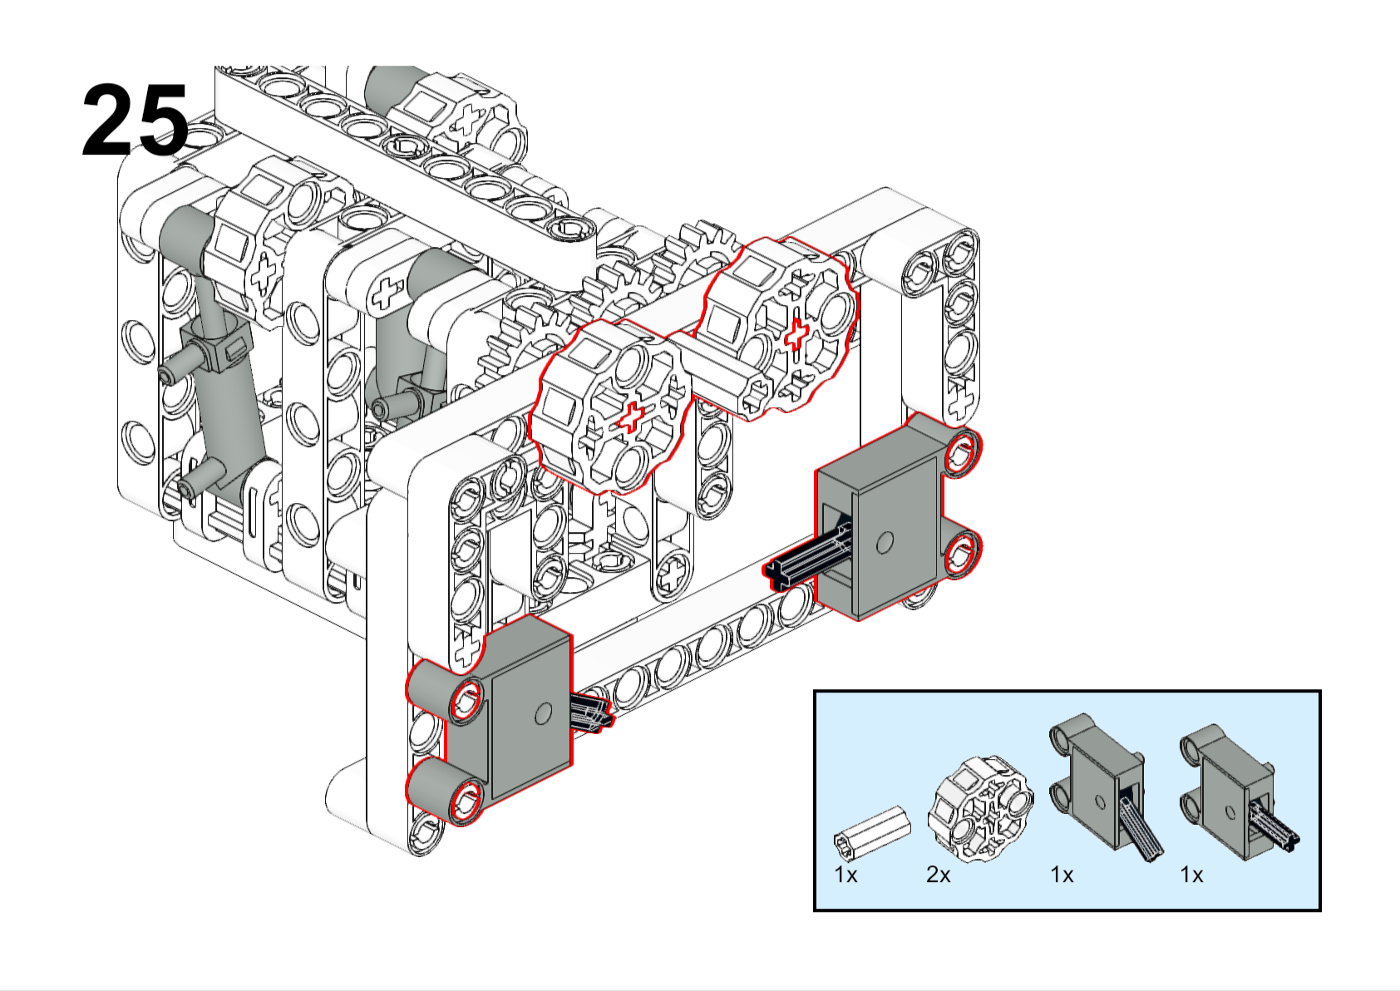
build_guide/Step02/25Lego.png
