SebicheParrilla/The-primis/build_guide/Step02/29Lego.png

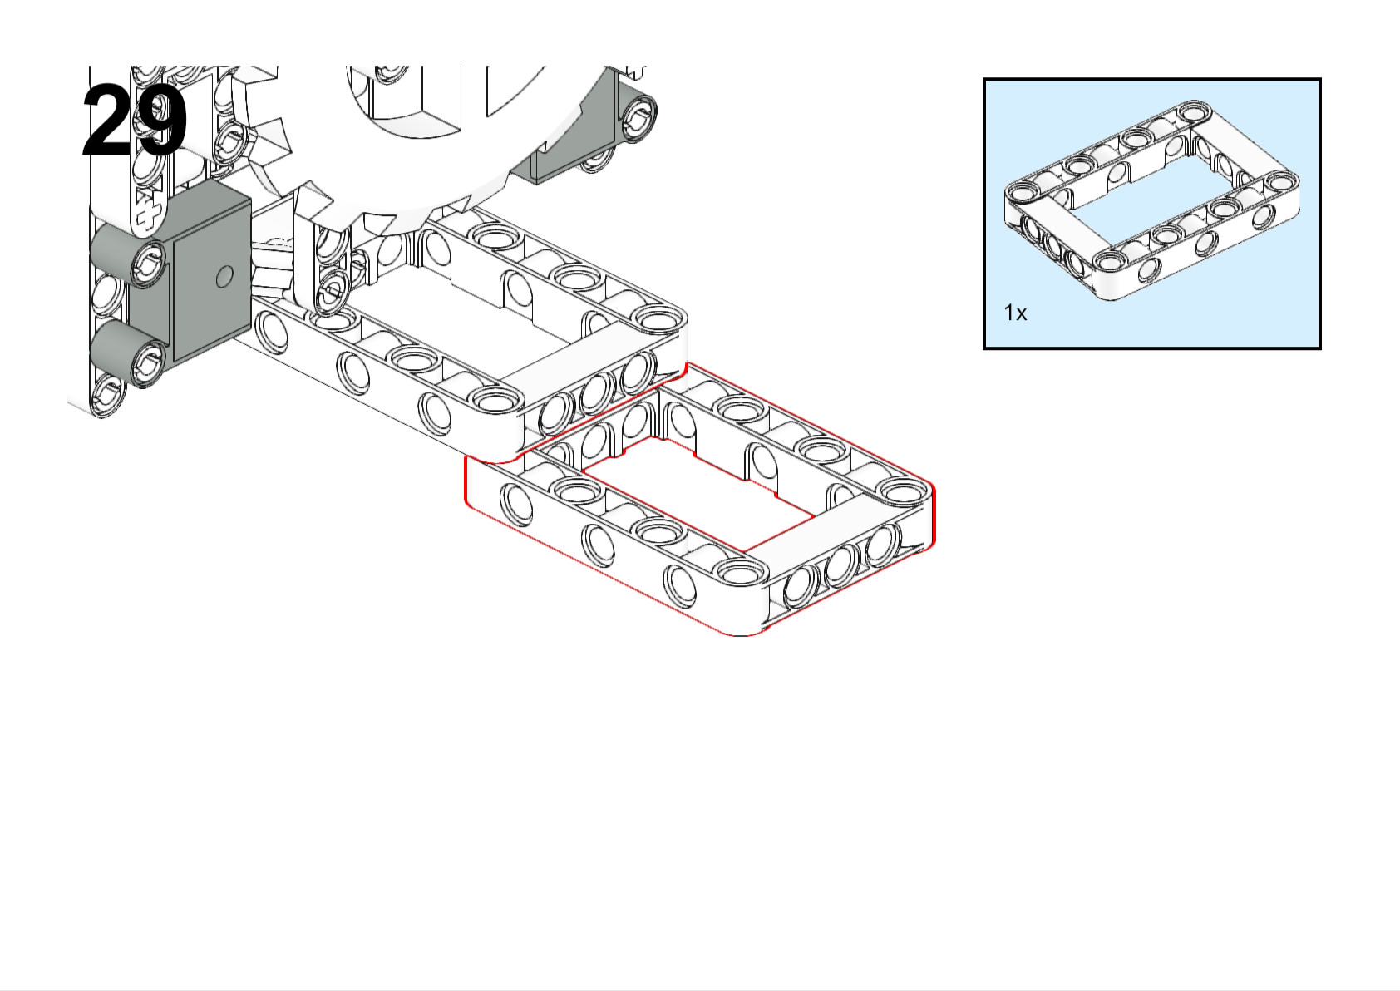
build_guide/Step02/29Lego.png
