SebicheParrilla/The-primis/build_guide/Step02/33Lego.png

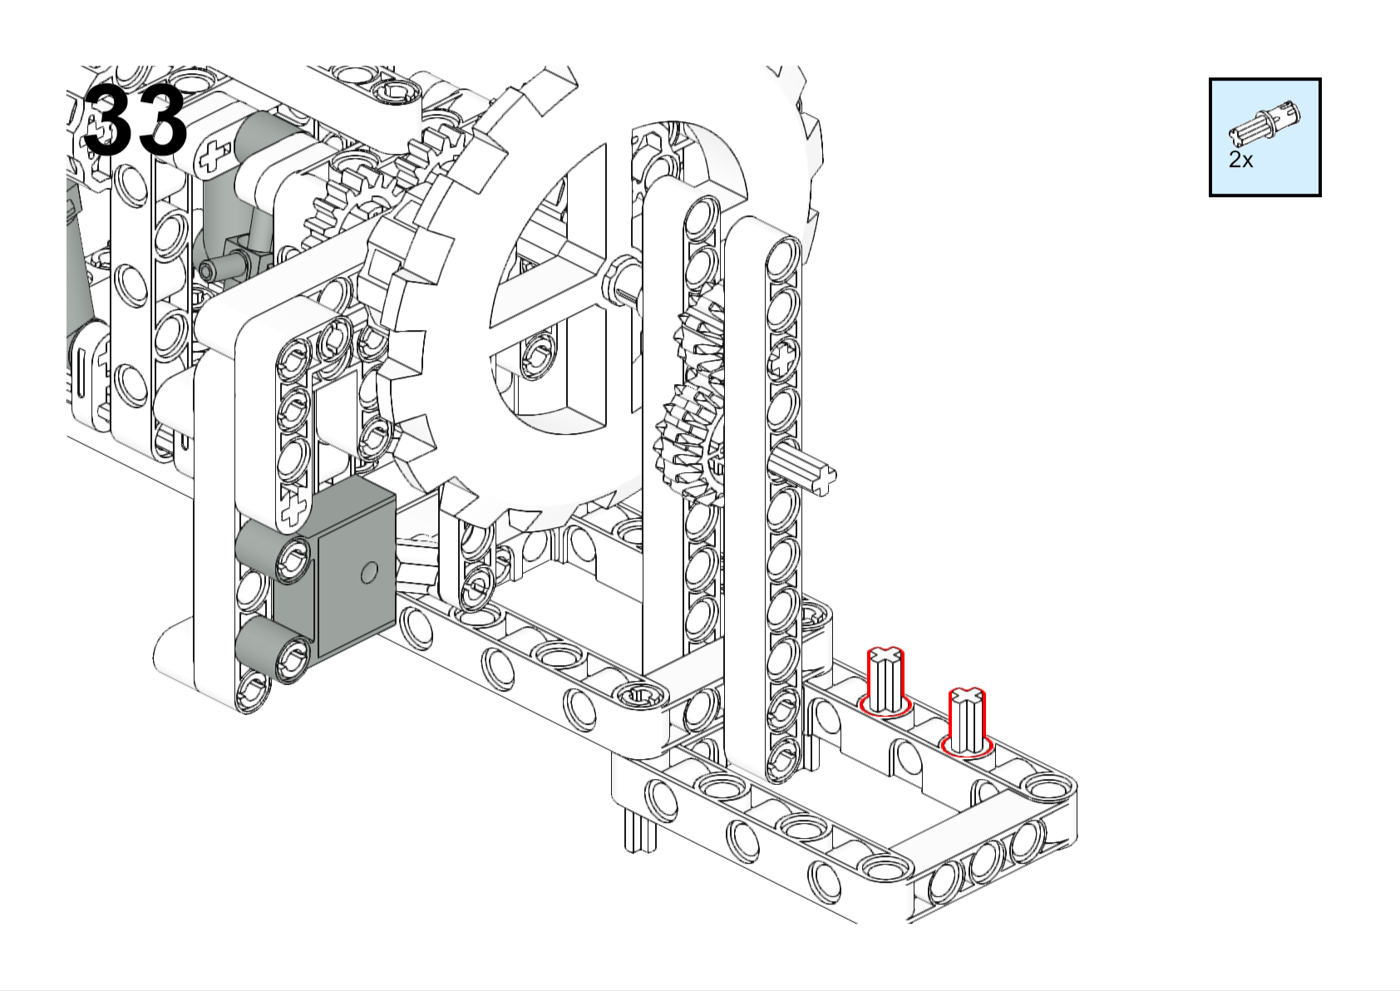
build_guide/Step02/33Lego.png
