SebicheParrilla/The-primis/build_guide/Step02/35Lego.png

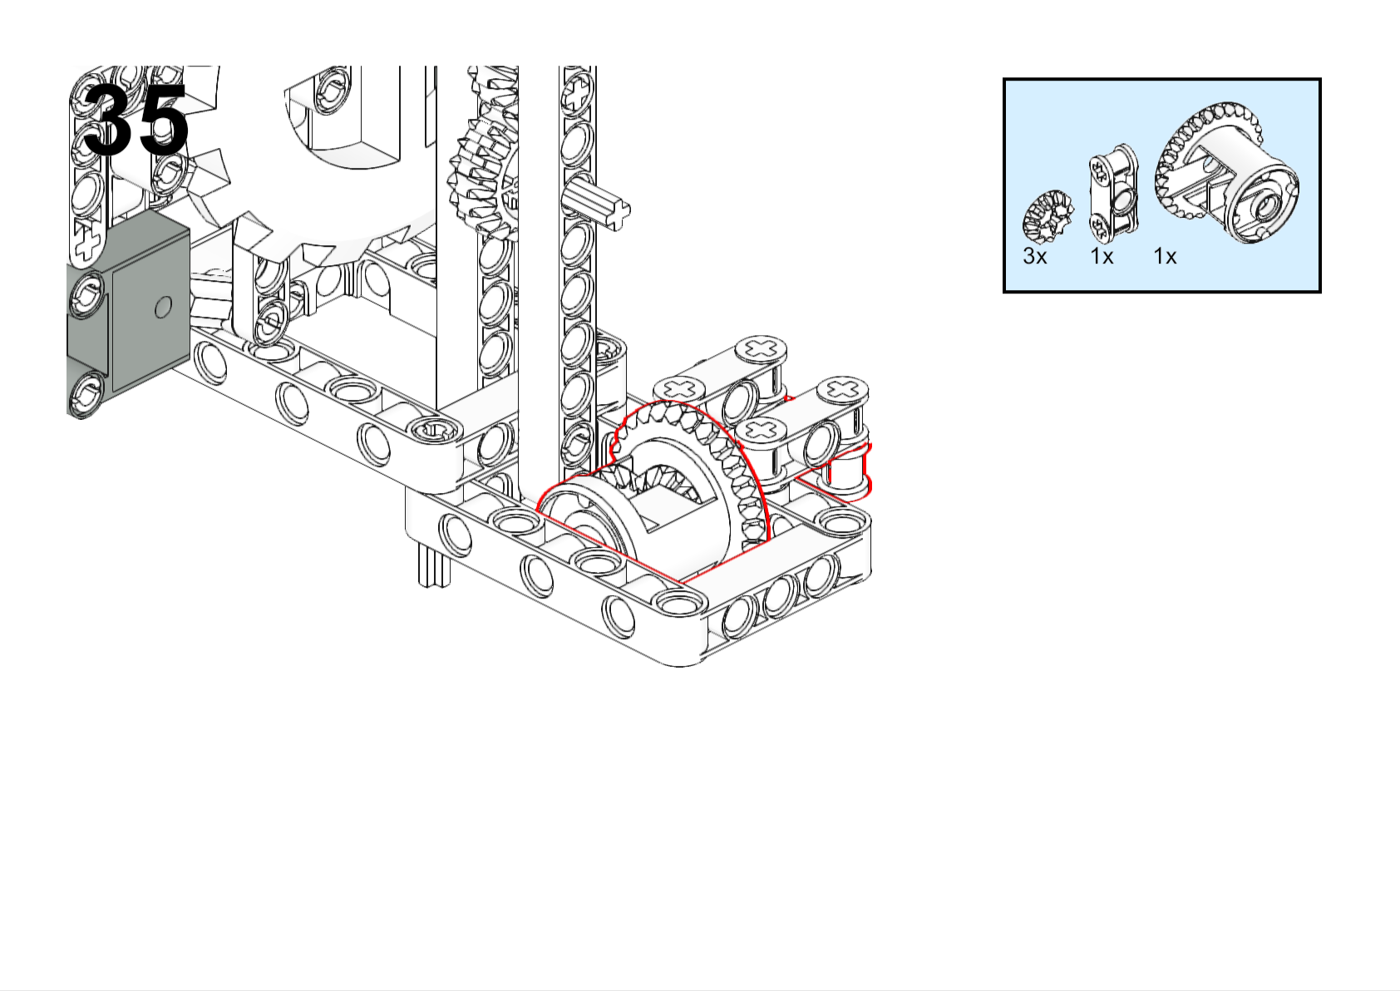
build_guide/Step02/35Lego.png
