SebicheParrilla/The-primis/build_guide/Step02/36Lego.png

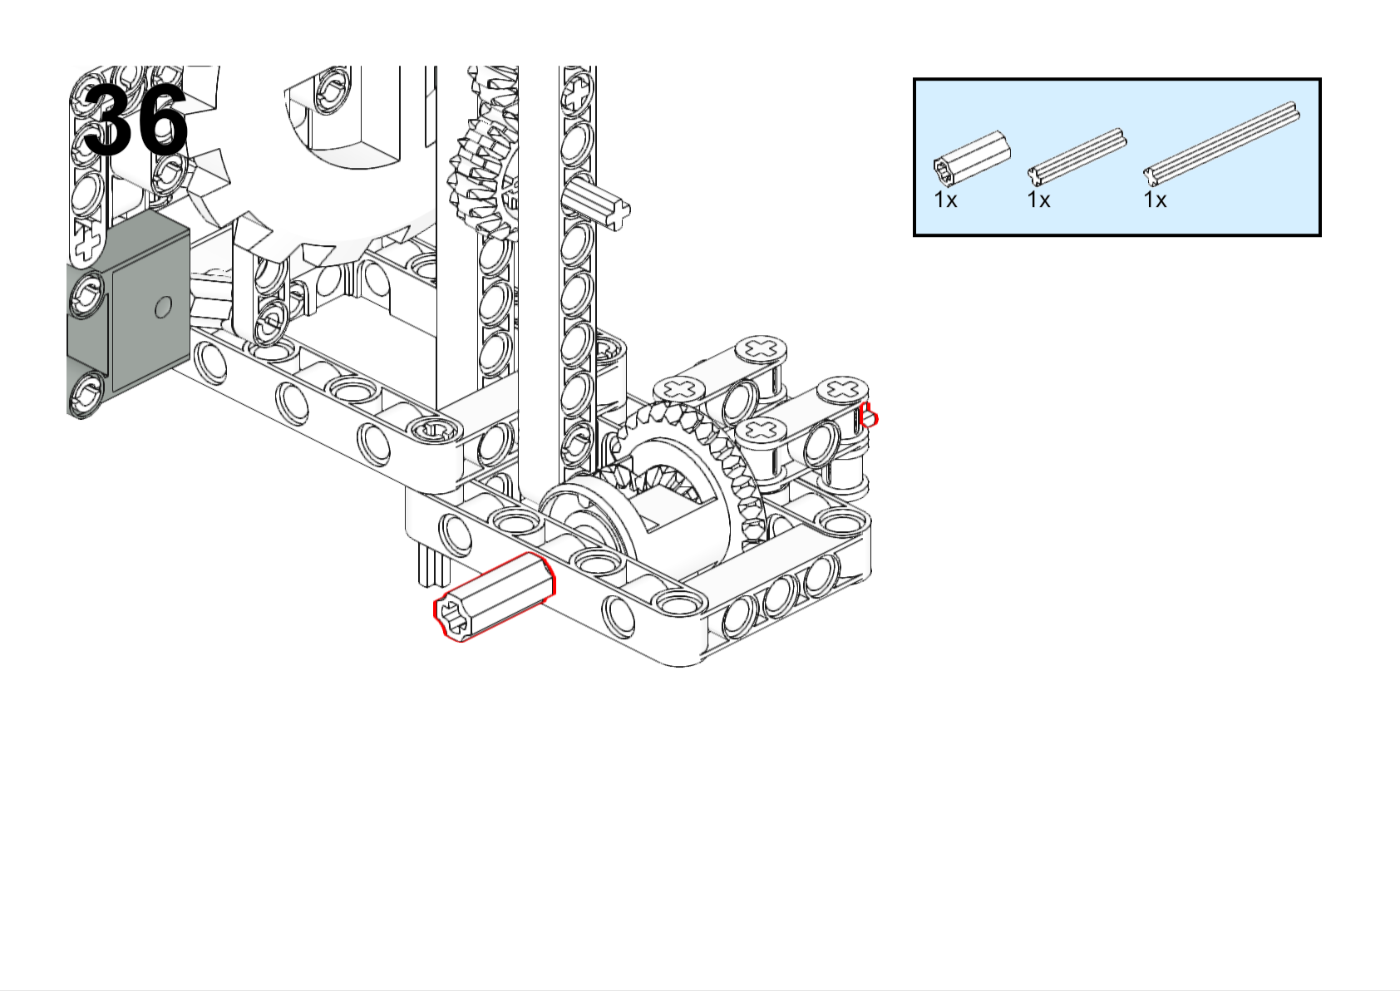
build_guide/Step02/36Lego.png
