SebicheParrilla/The-primis/build_guide/Step02/37Lego.png

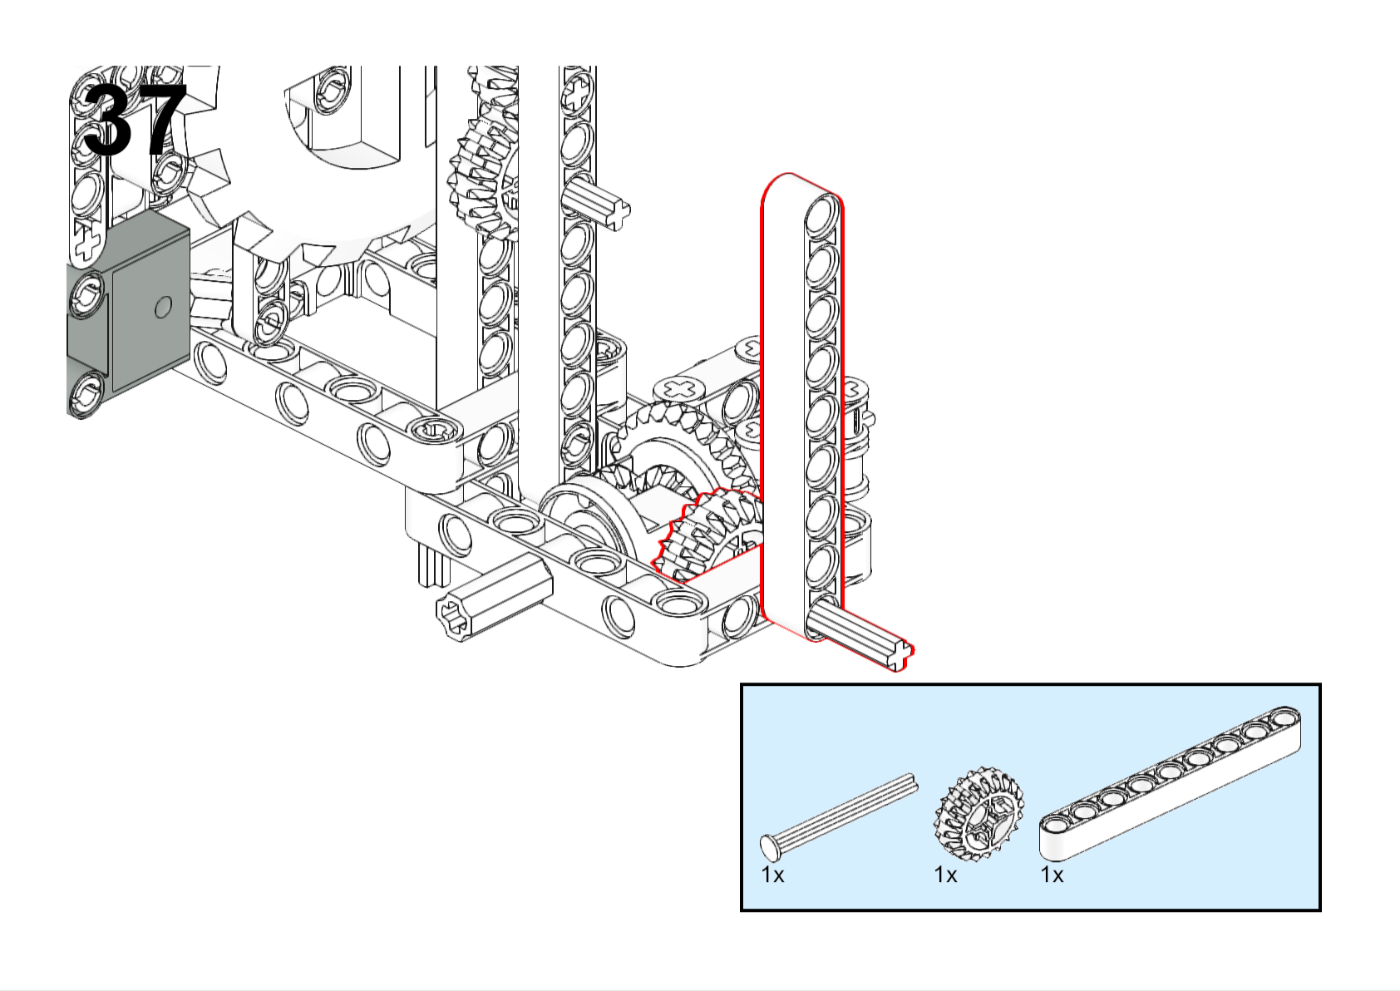
build_guide/Step02/37Lego.png
