SebicheParrilla/The-primis/build_guide/Step02/42Lego.png

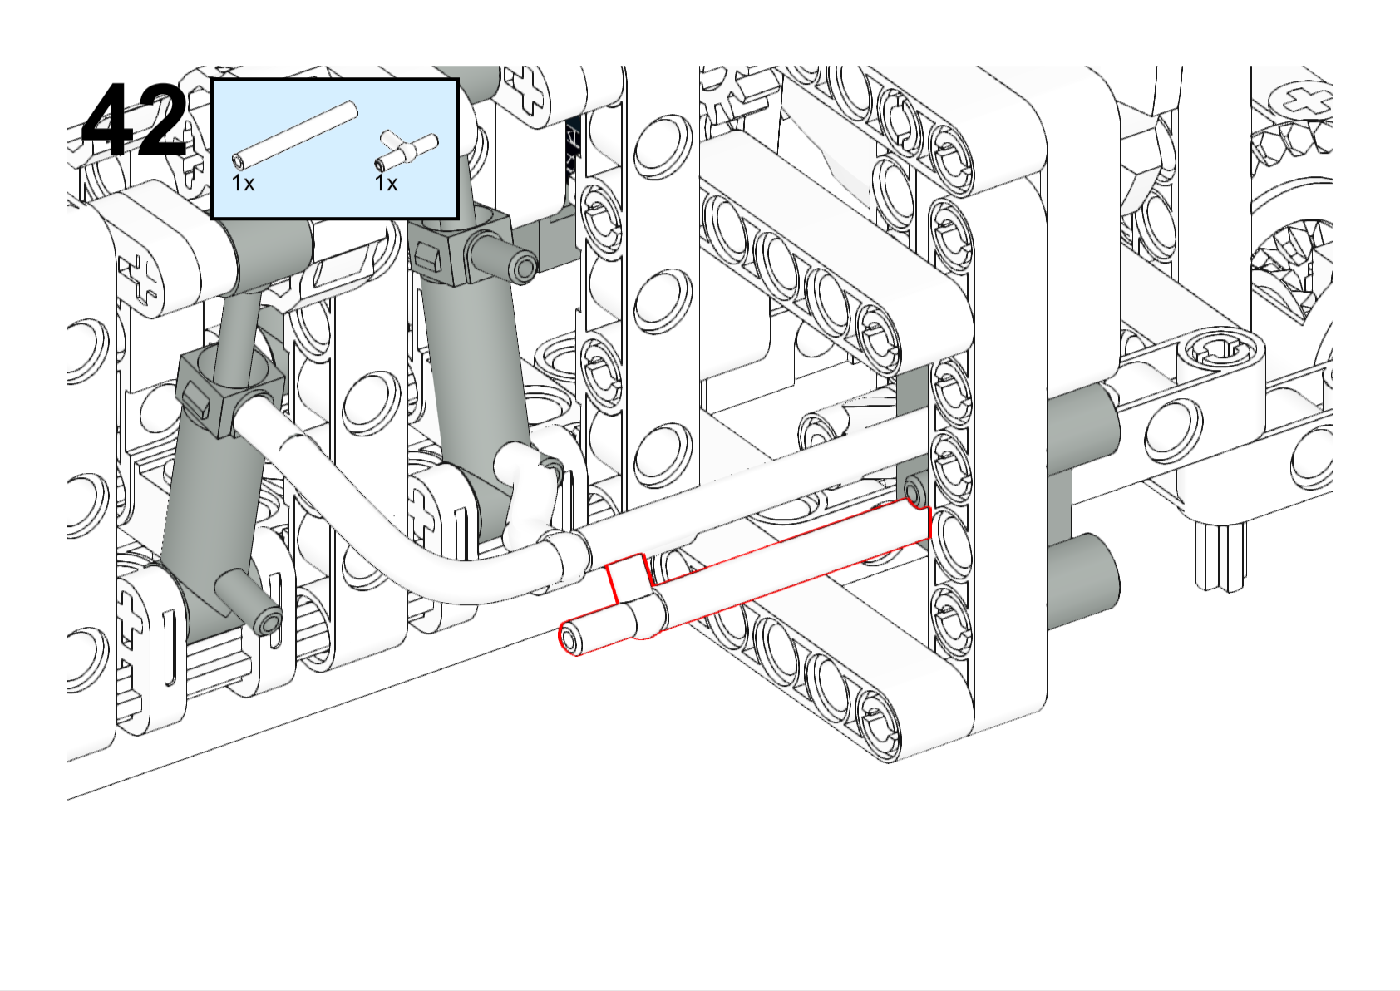
build_guide/Step02/42Lego.png
