SebicheParrilla/The-primis/build_guide/Step02/44Lego.png

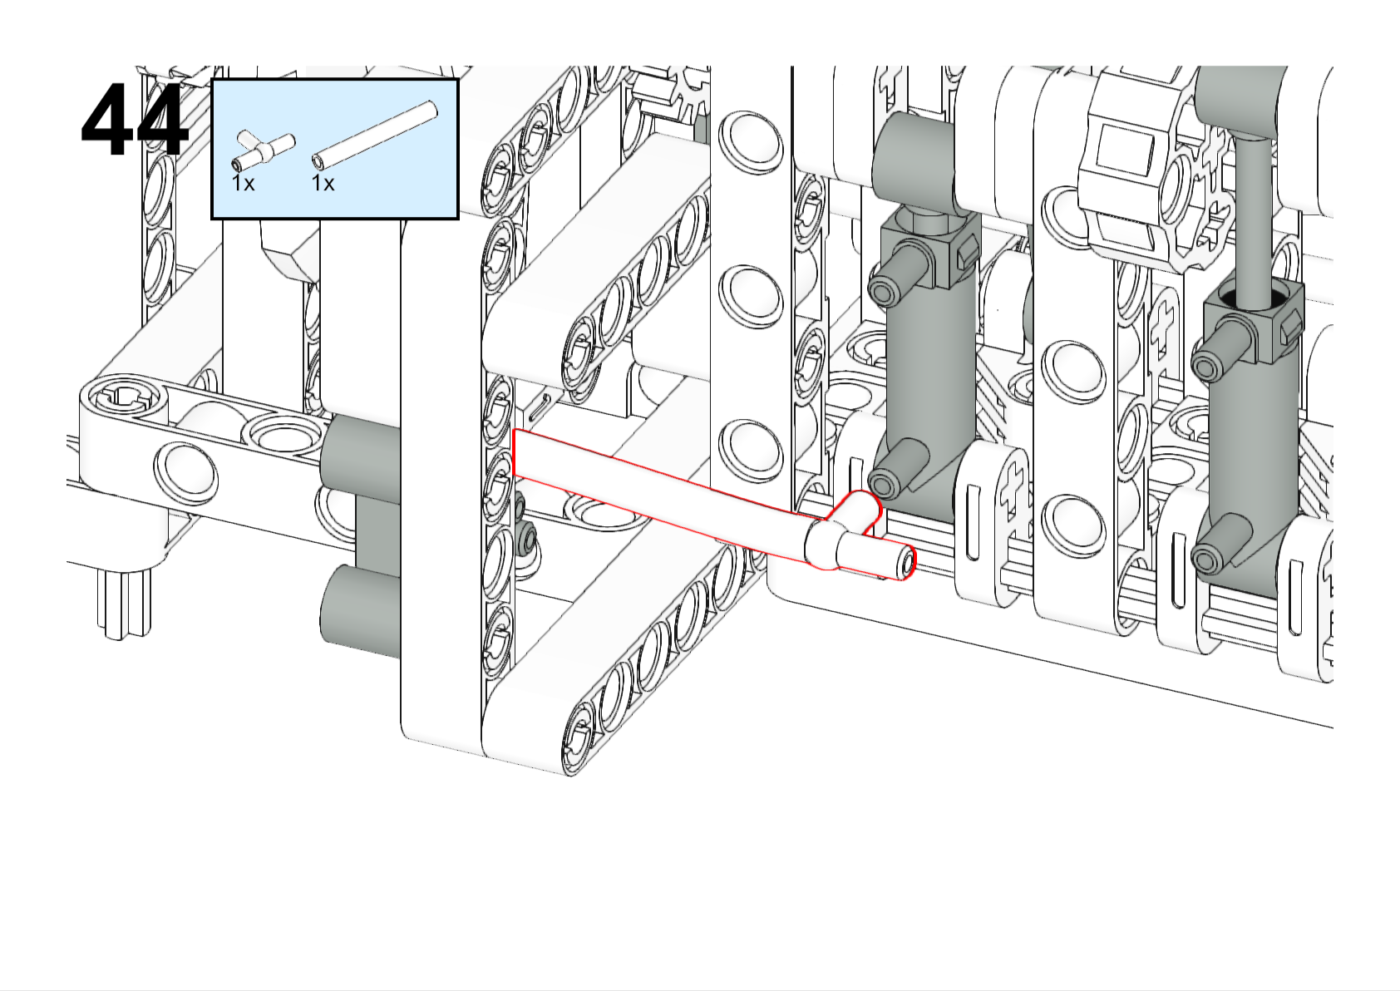
build_guide/Step02/44Lego.png
