SebicheParrilla/The-primis/build_guide/Step02/45Lego.png

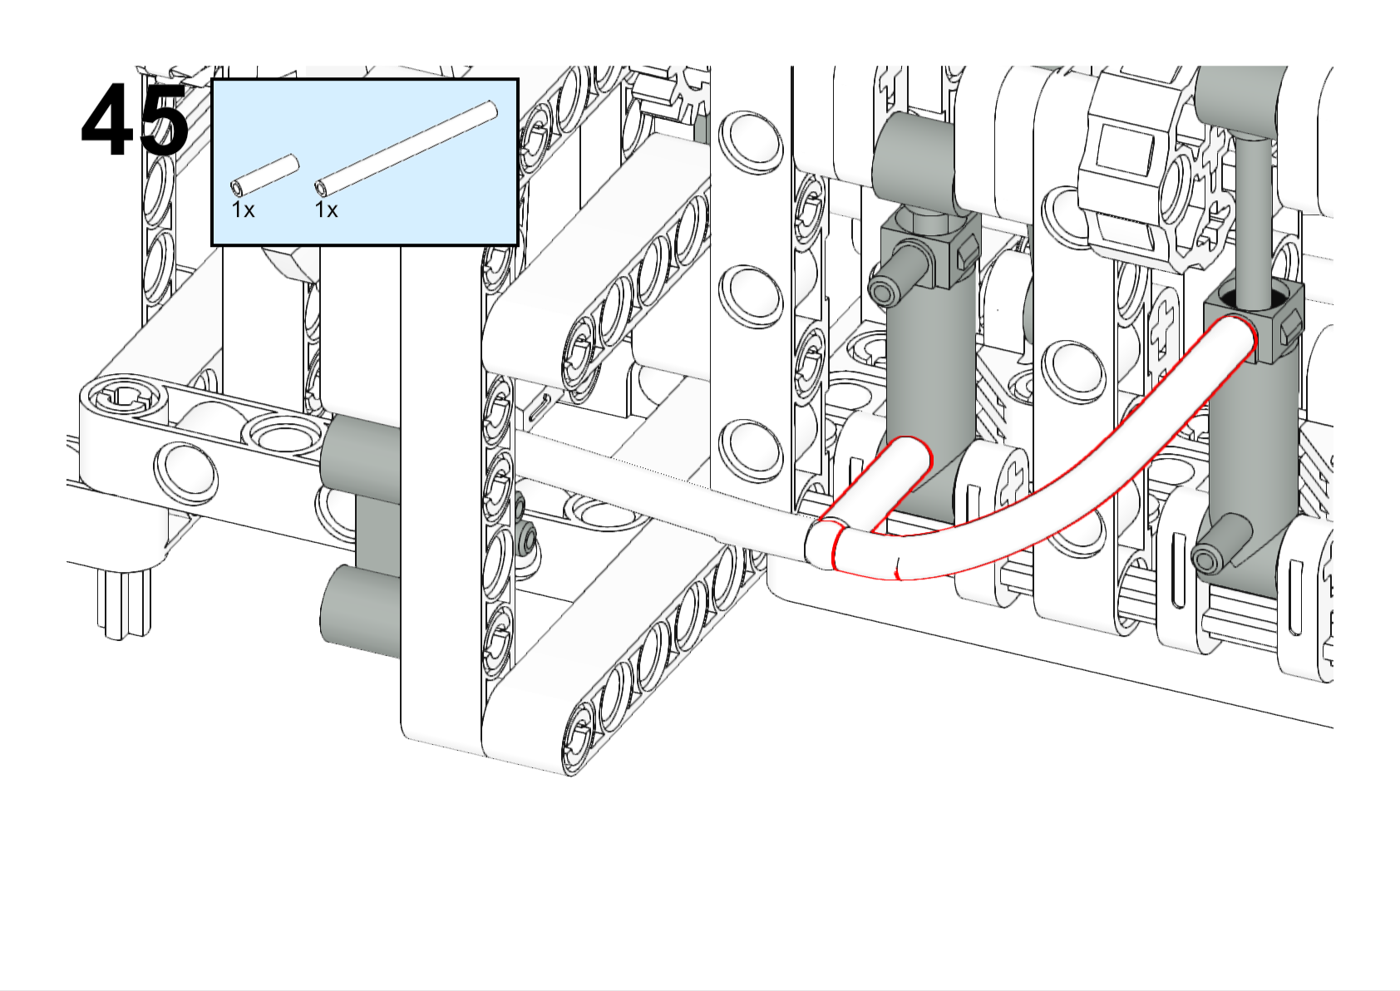
build_guide/Step02/45Lego.png
