SebicheParrilla/The-primis/build_guide/Step02/48Lego.png

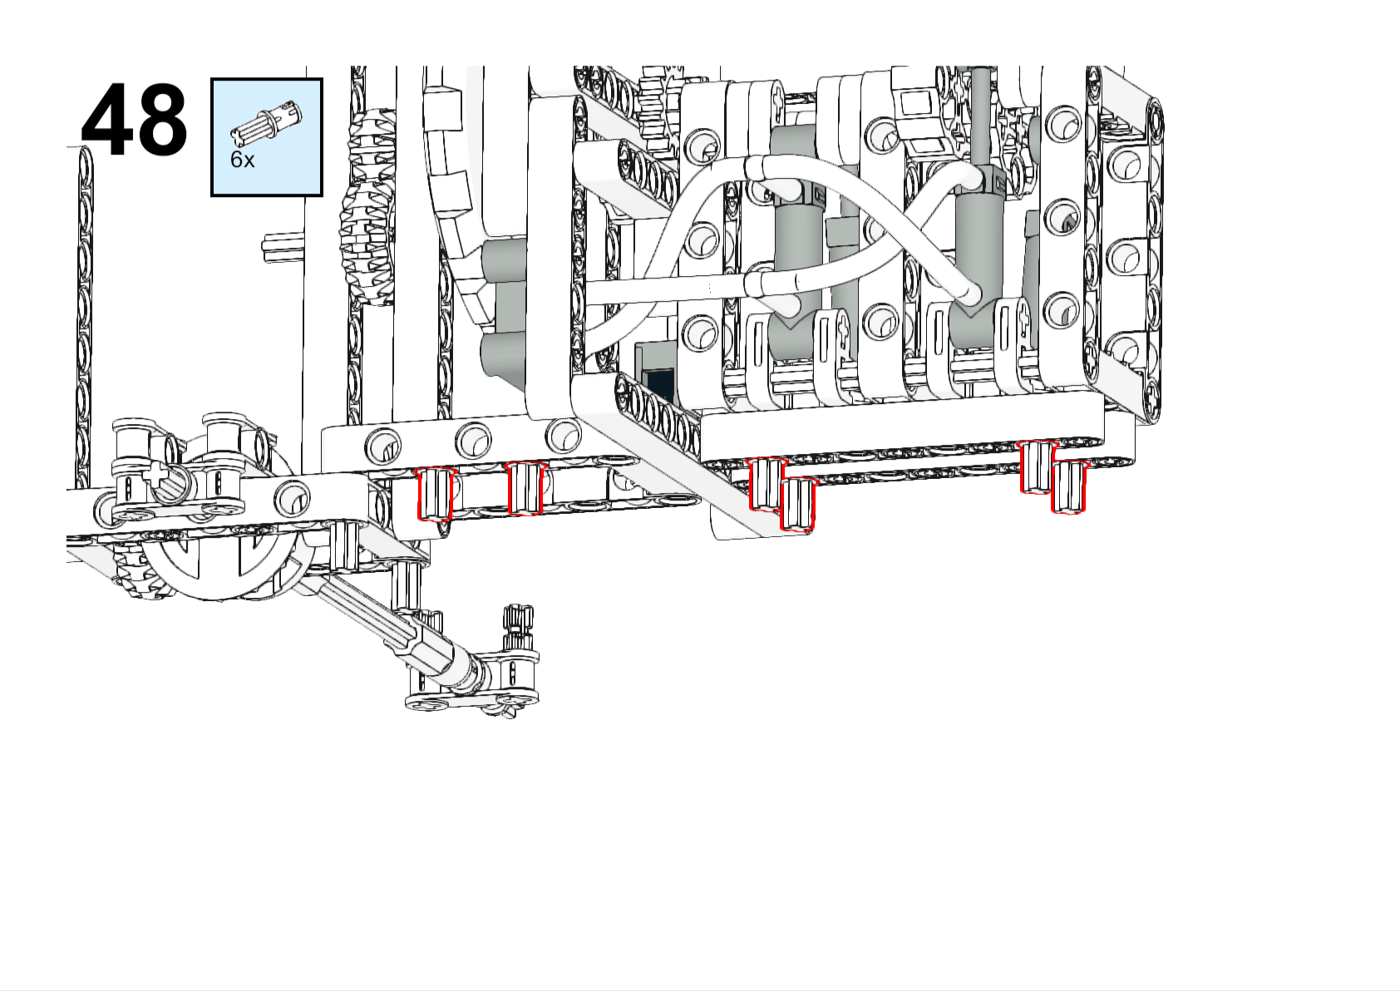
build_guide/Step02/48Lego.png
