SebicheParrilla/The-primis/build_guide/Step02/49Lego.png

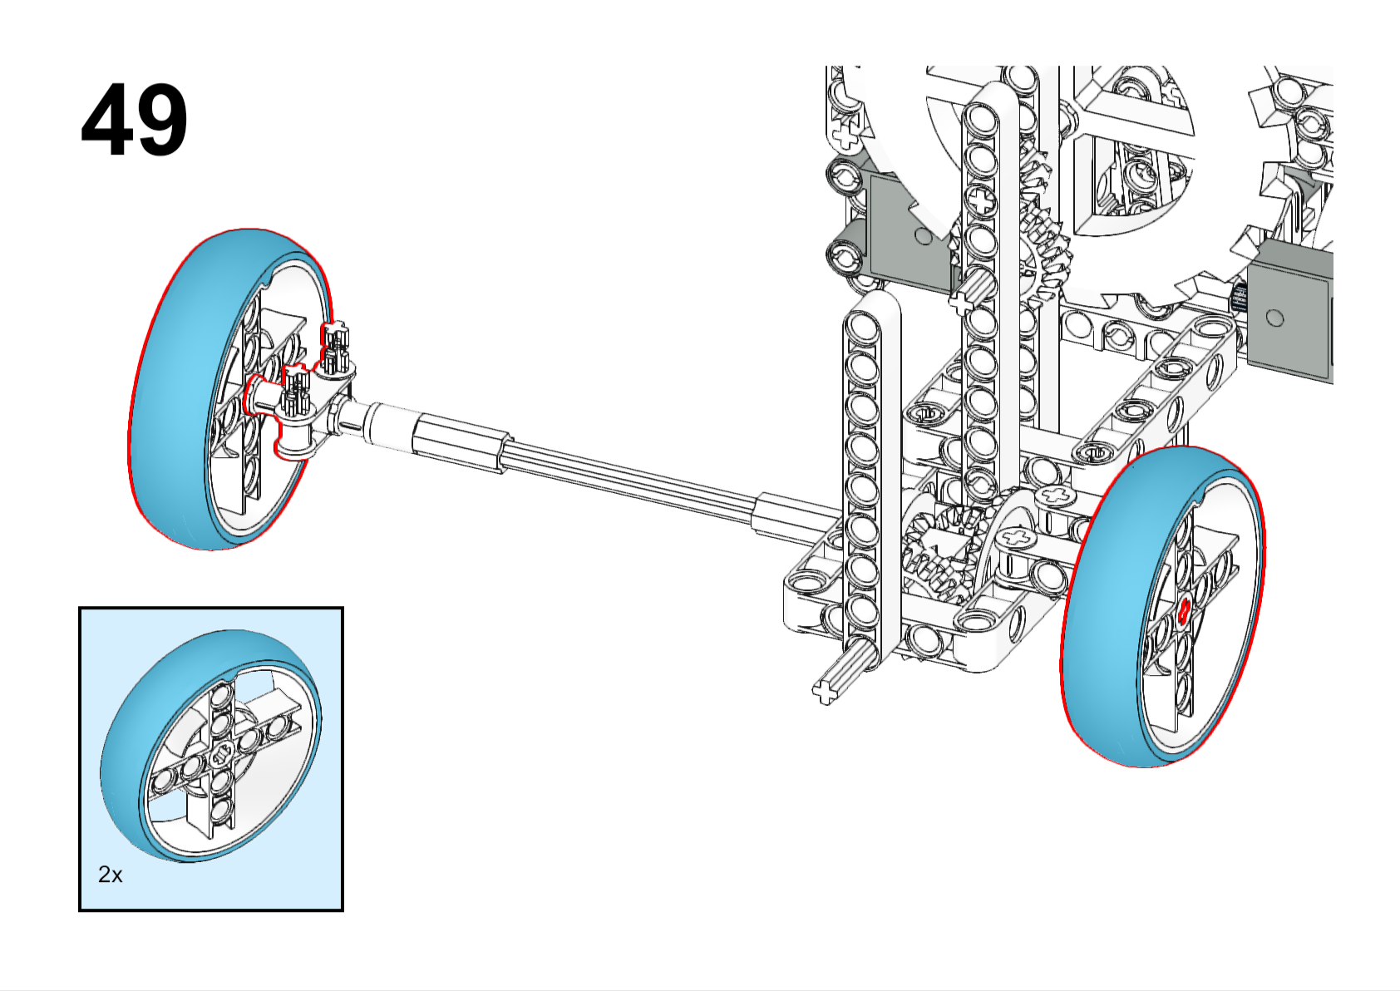
build_guide/Step02/49Lego.png
