SebicheParrilla/The-primis/build_guide/Step02/51Lego.png

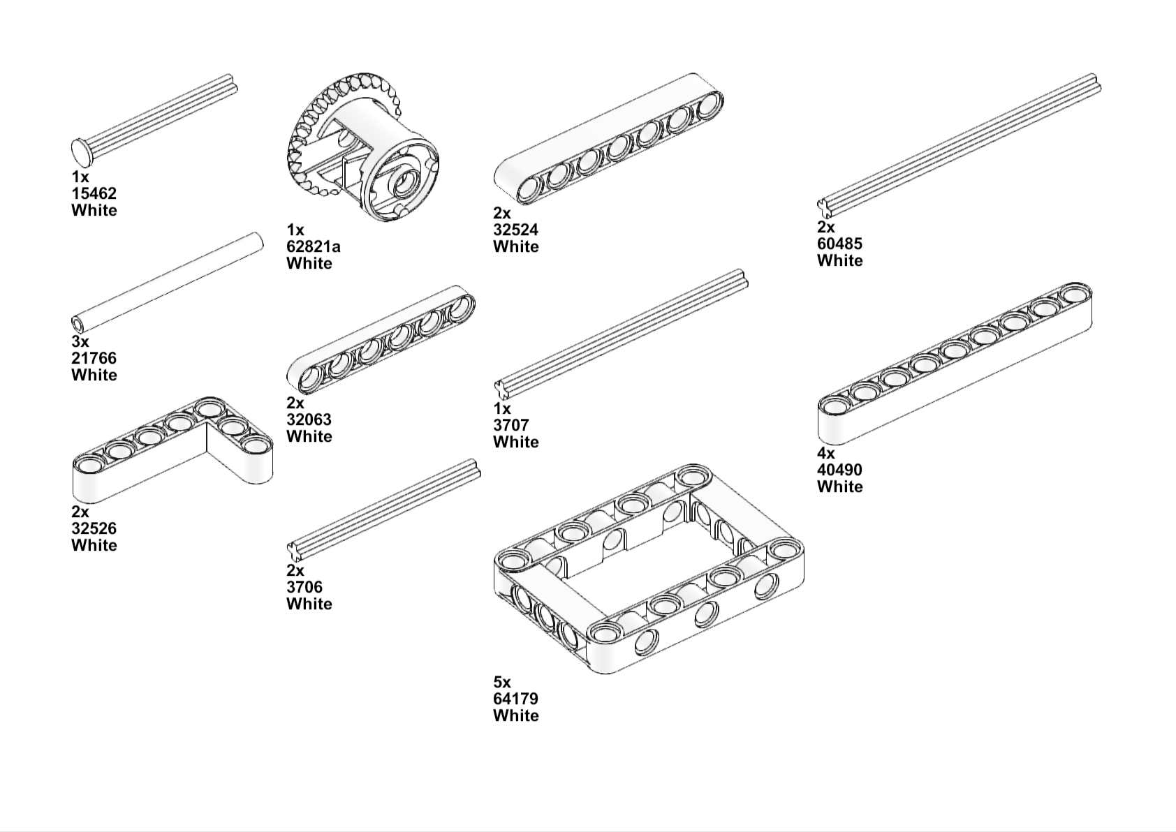
build_guide/Step02/51Lego.png
