SebicheParrilla/The-primis/build_guide/Step02/52Lego.png

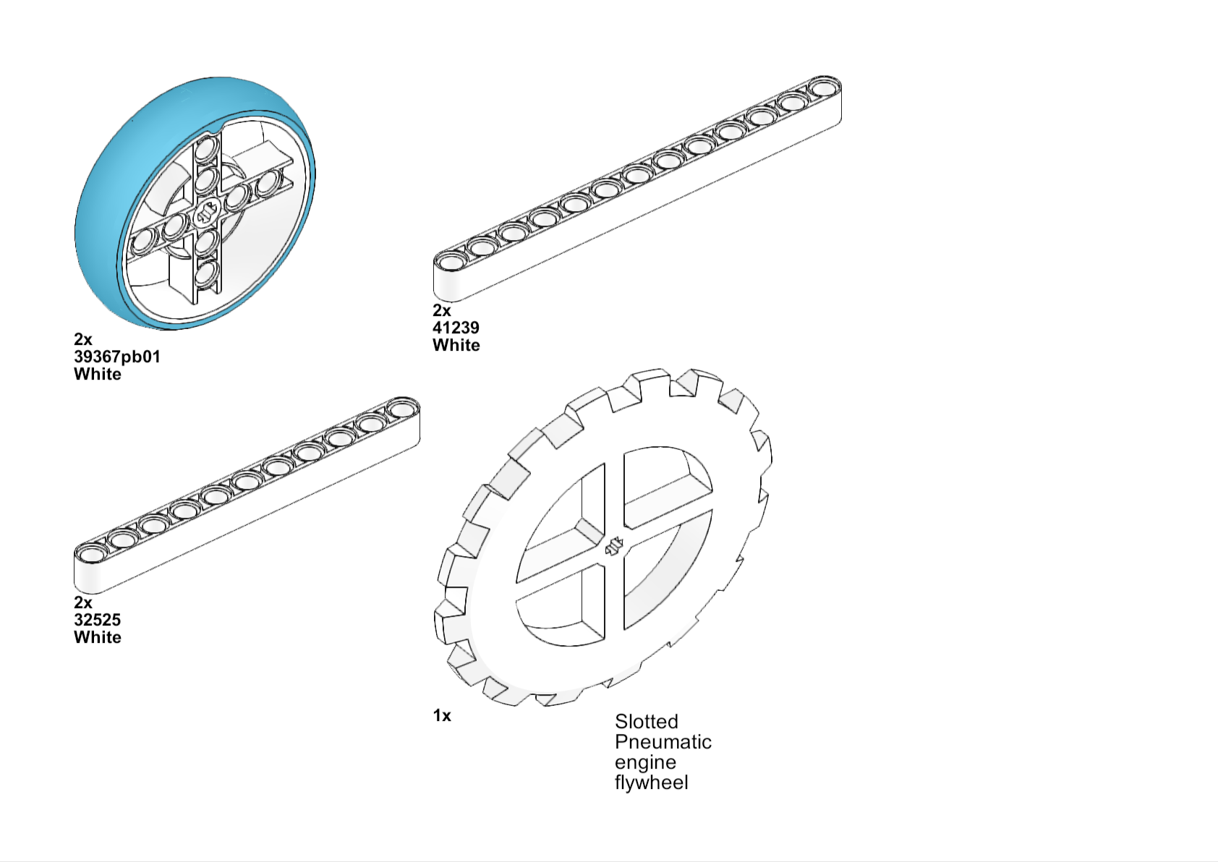
build_guide/Step02/52Lego.png
