SebicheParrilla/The-primis/build_guide/Step02/Lego1.png

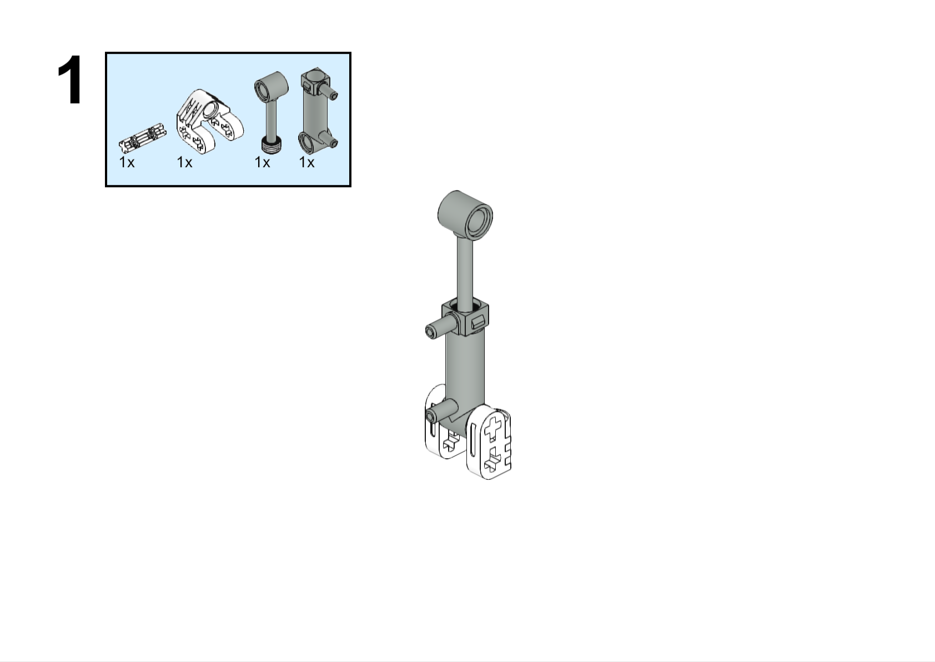
build_guide/Step02/Lego1.png
