SebicheParrilla/The-primis/build_guide/Step02/Lego2.png

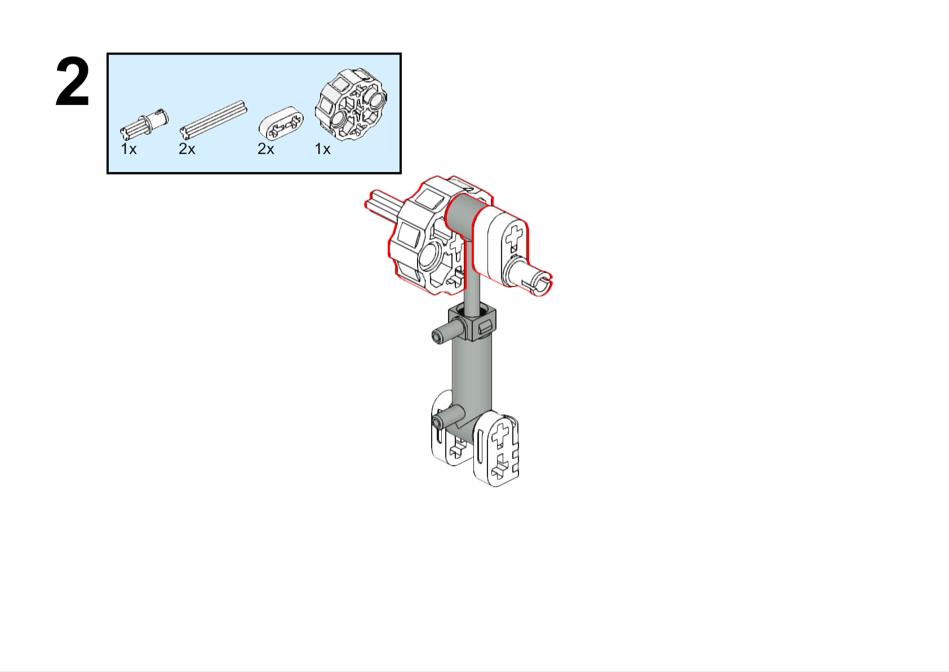
build_guide/Step02/Lego2.png
