SebicheParrilla/The-primis/build_guide/Step02/Lego4.png

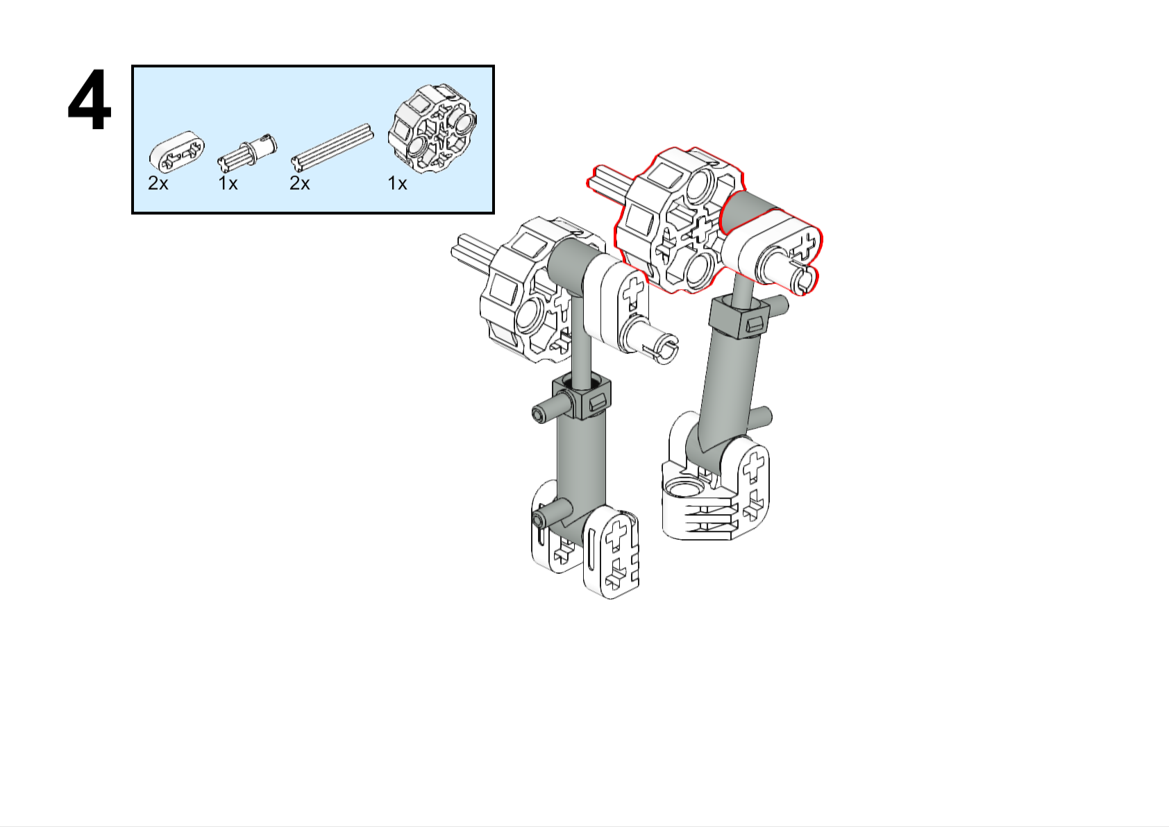
build_guide/Step02/Lego4.png
