SebicheParrilla/The-primis/build_guide/Step02/Lego5.png

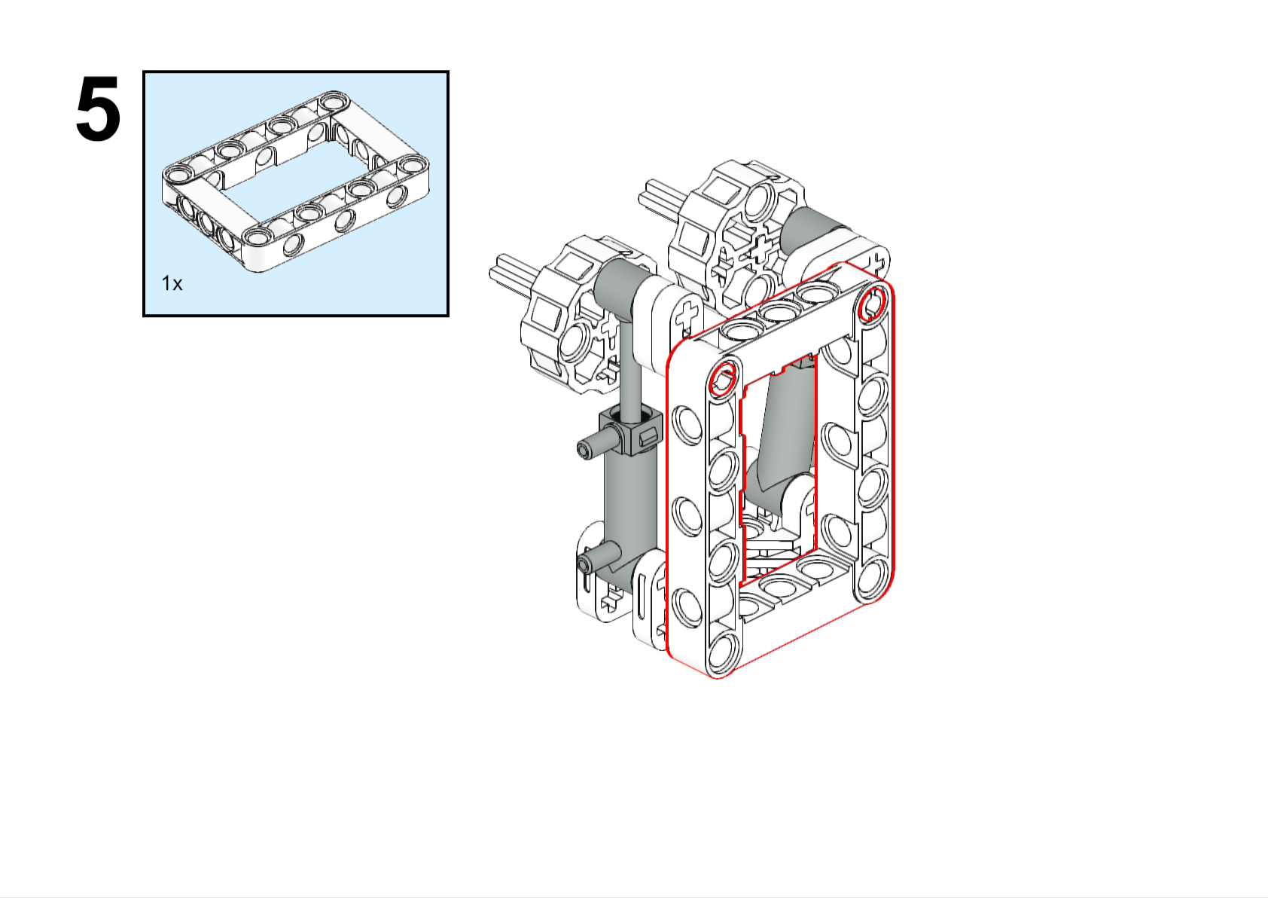
build_guide/Step02/Lego5.png
