SebicheParrilla/The-primis/build_guide/Step02/Lego13.png

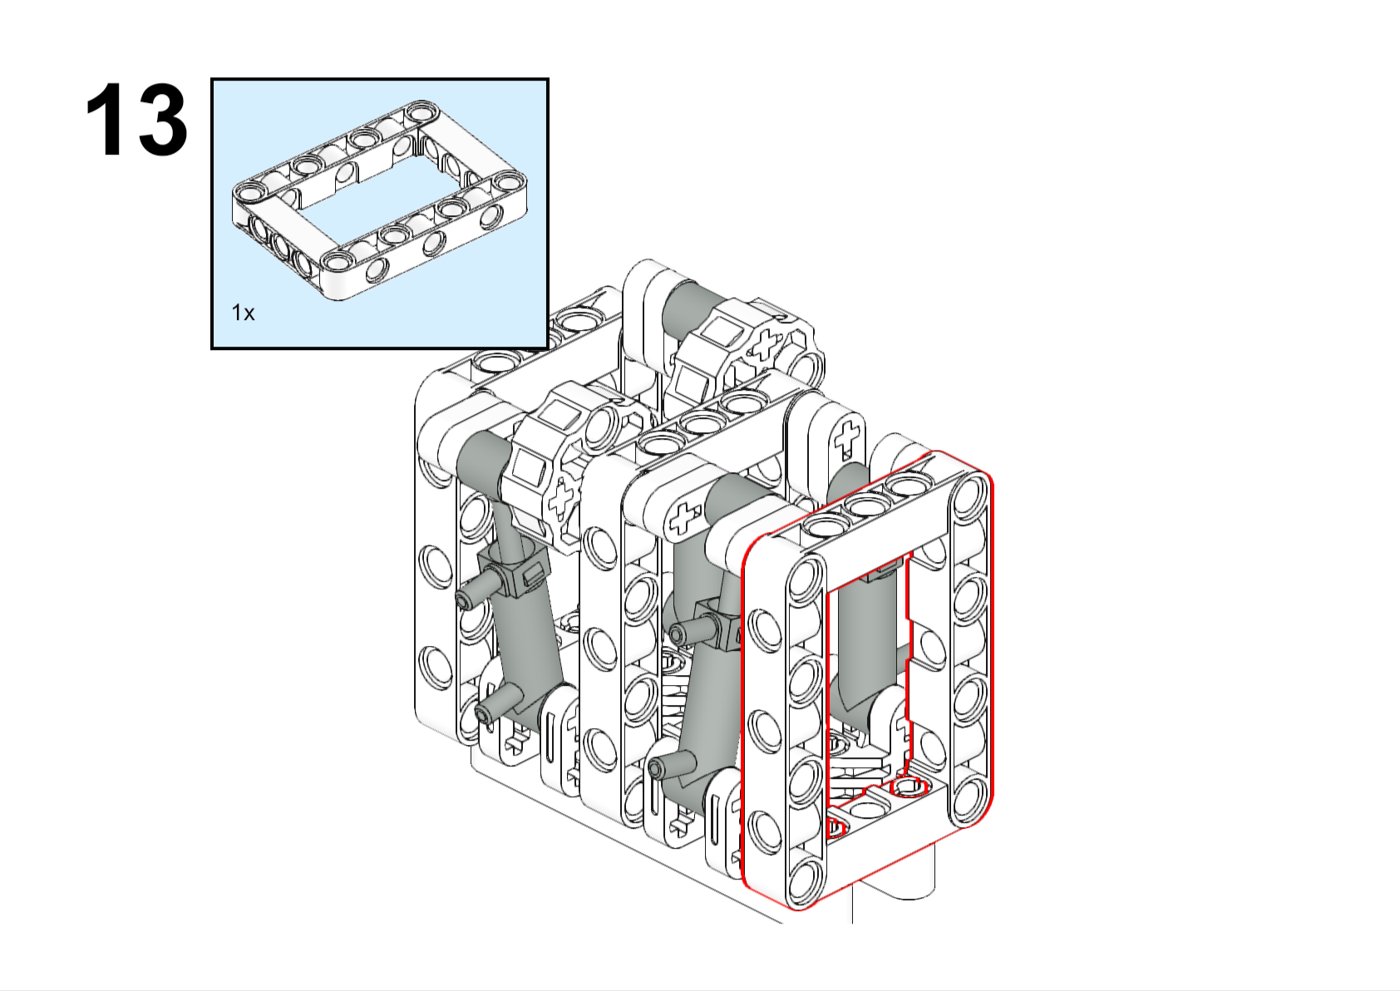
build_guide/Step02/Lego13.png
