SebicheParrilla/The-primis/build_guide/Step02/Lego14.png

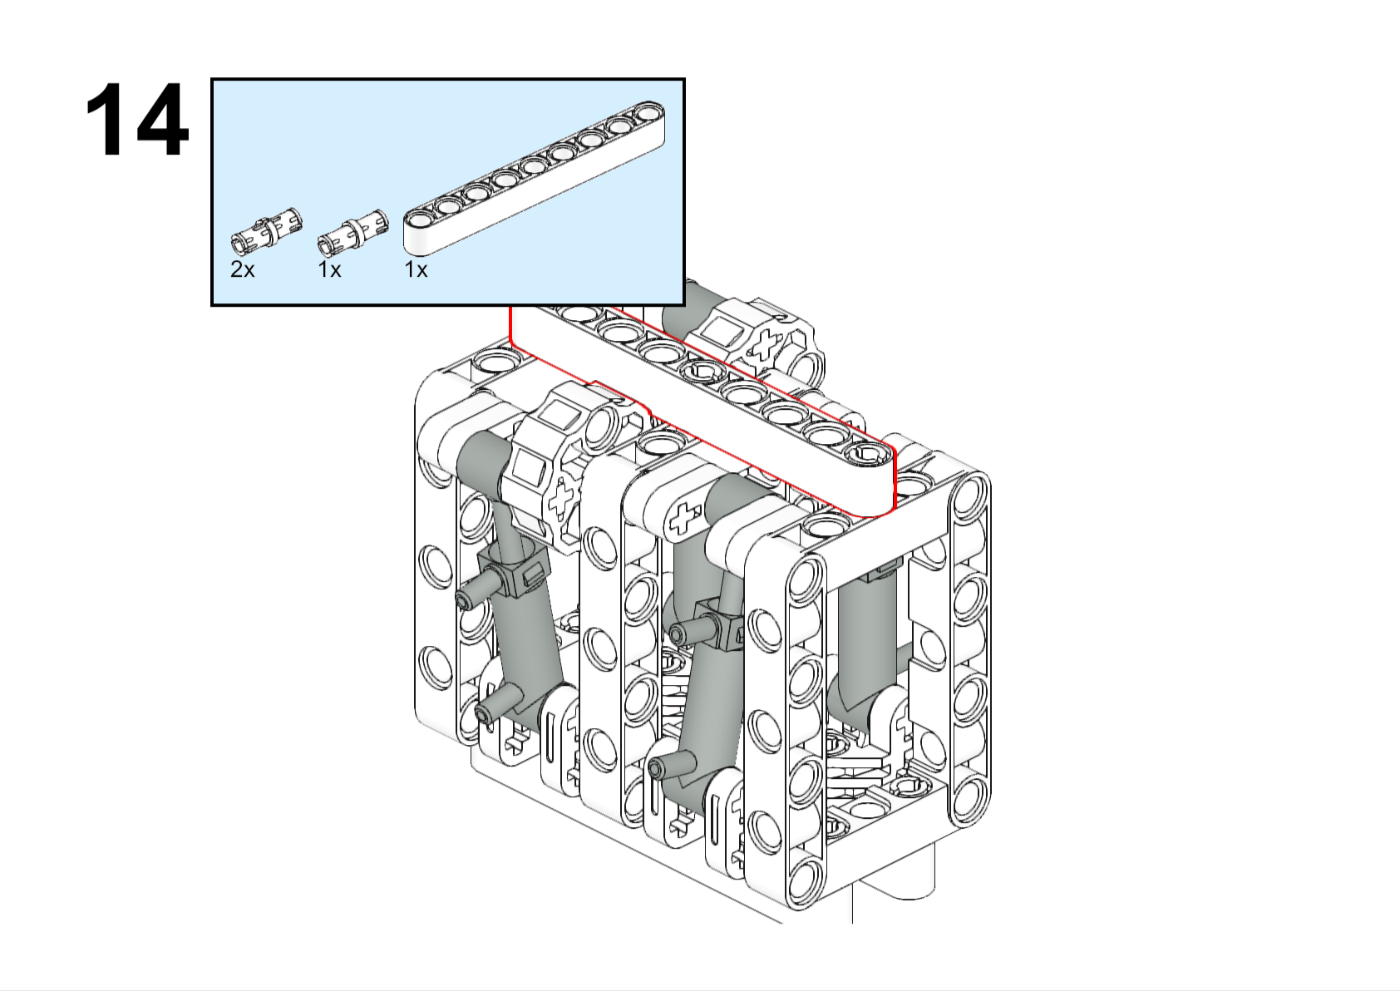
build_guide/Step02/Lego14.png
