SebicheParrilla/The-primis/build_guide/Step02/Lego16.png

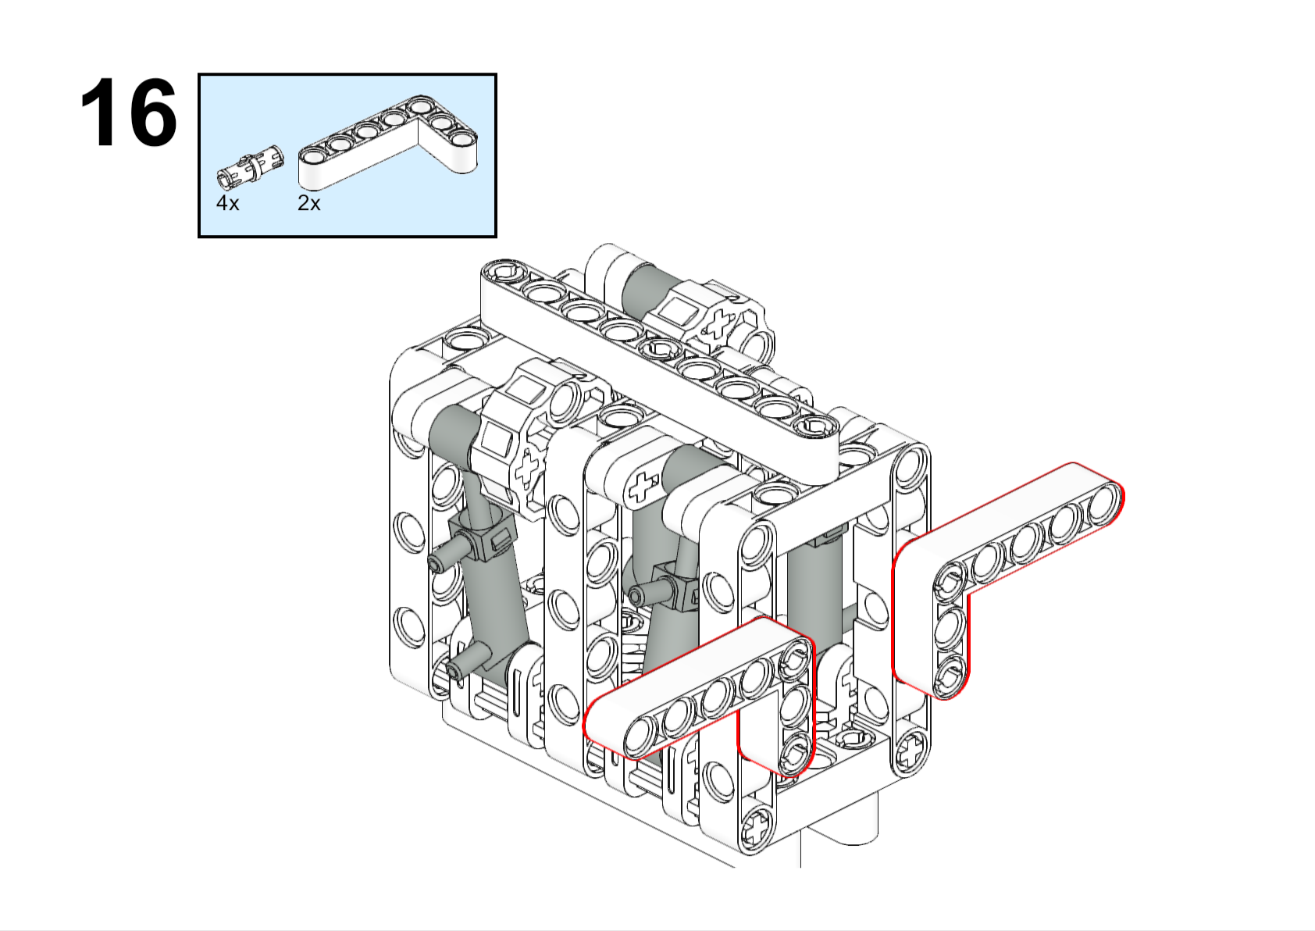
build_guide/Step02/Lego16.png
