SebicheParrilla/The-primis/build_guide/Step02/Lego20.png

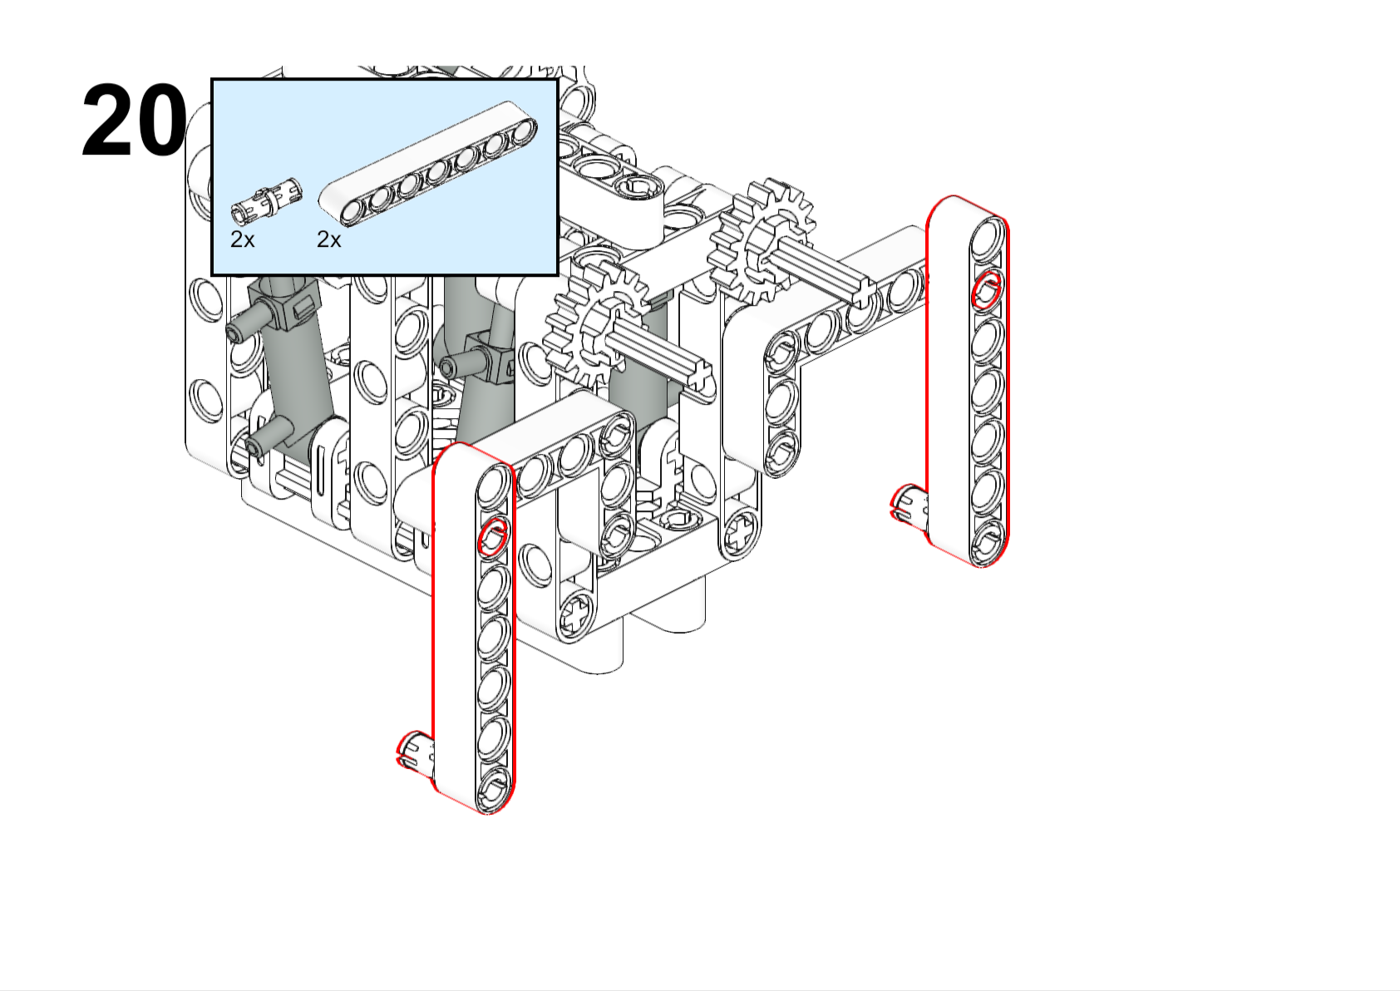
build_guide/Step02/Lego20.png
