SebicheParrilla/The-primis/build_guide/Step02/Lego22.png

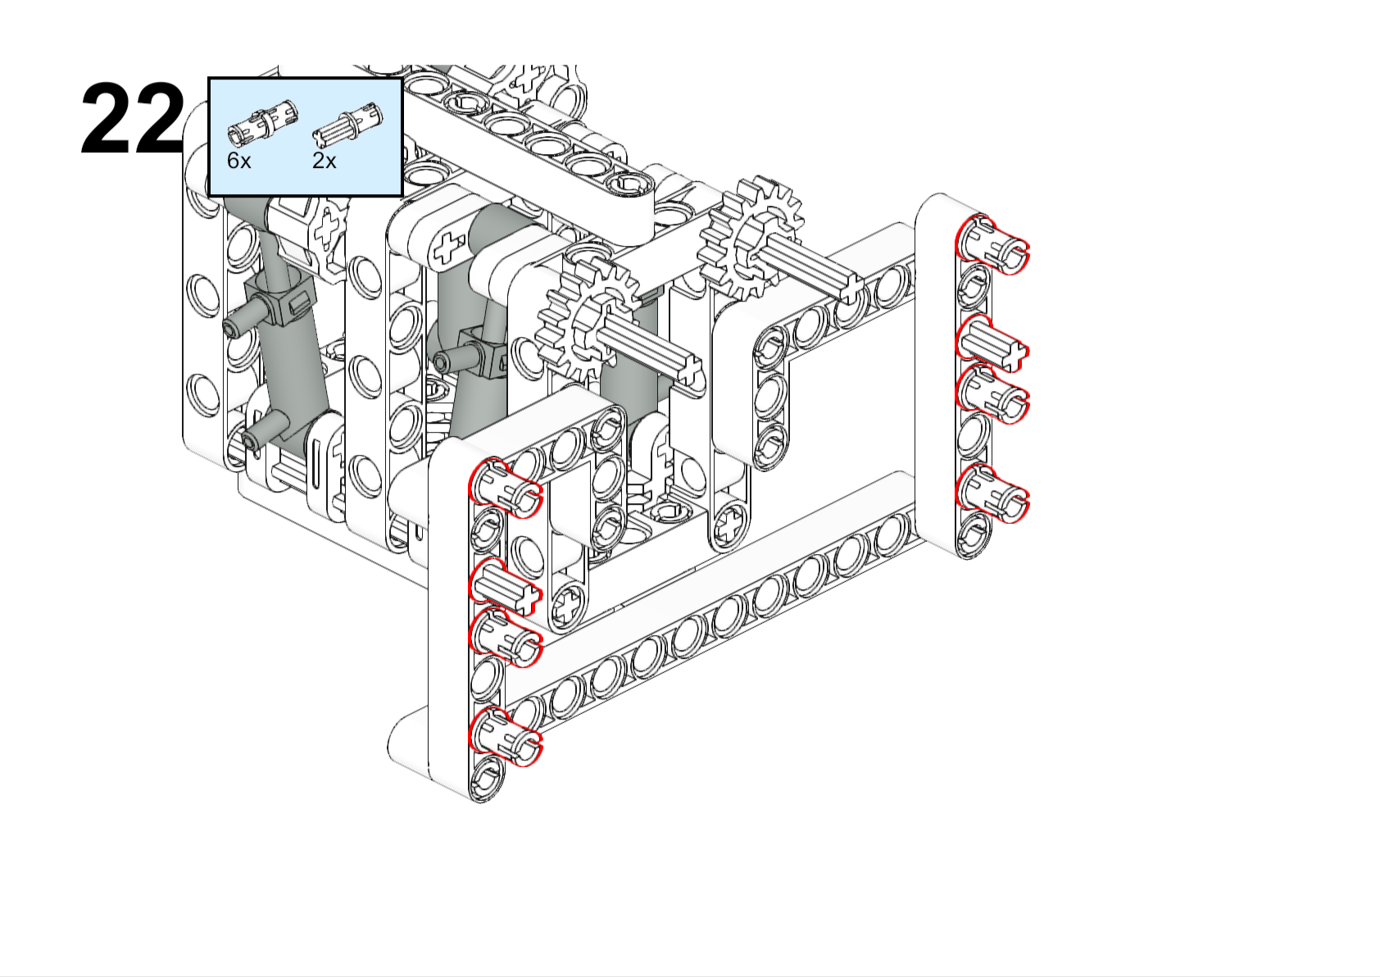
build_guide/Step02/Lego22.png
