SebicheParrilla/The-primis/build_guide/Step02/Lego23.png

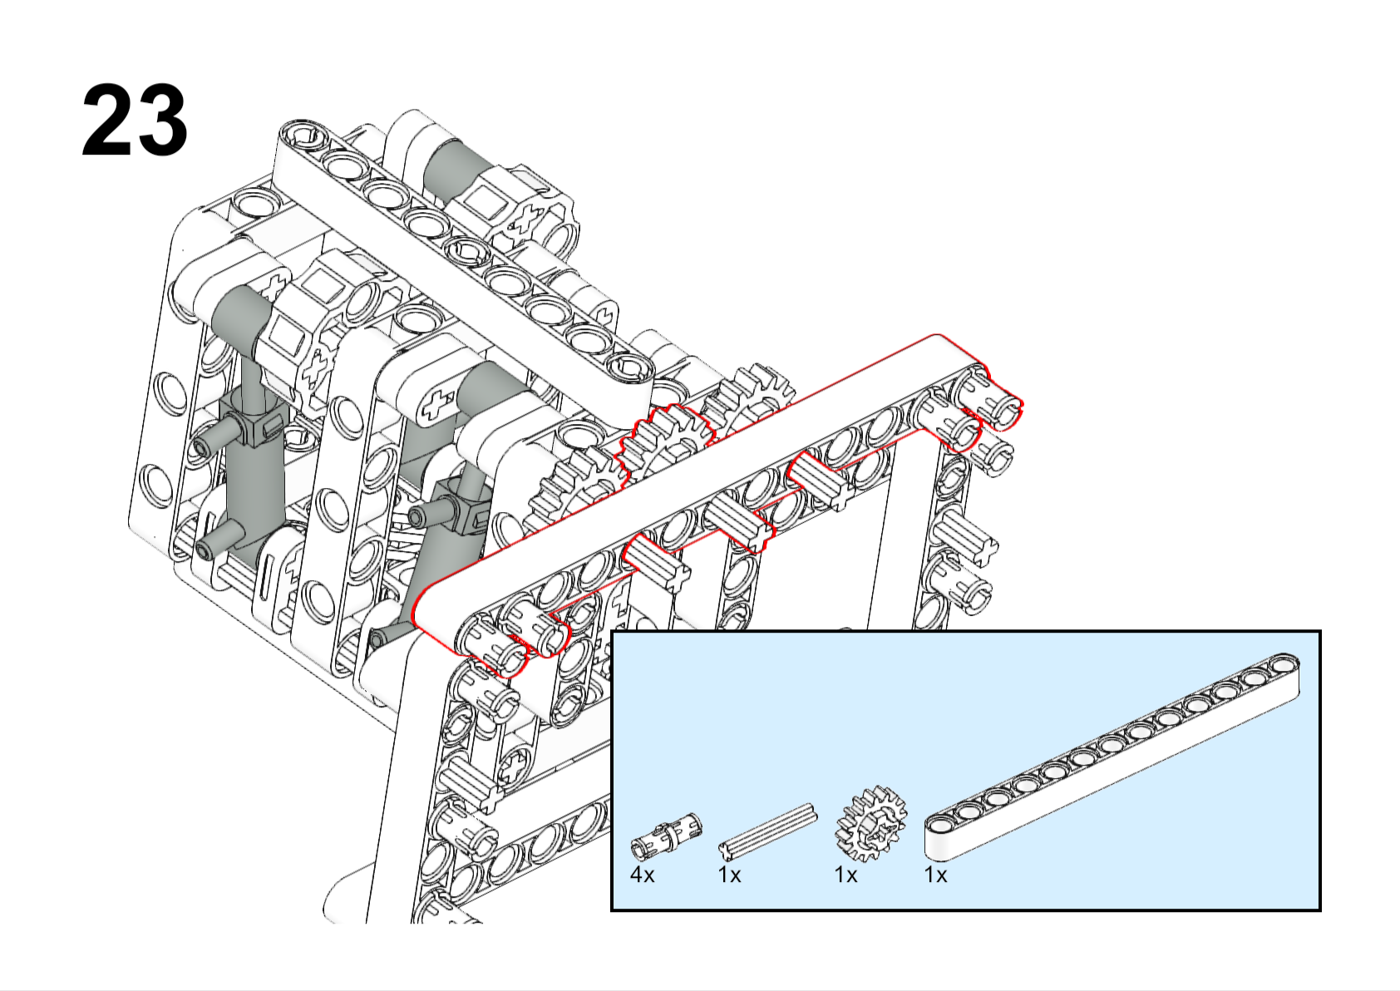
build_guide/Step02/Lego23.png
