SebicheParrilla/The-primis/build_guide/Step02/Lego24.png

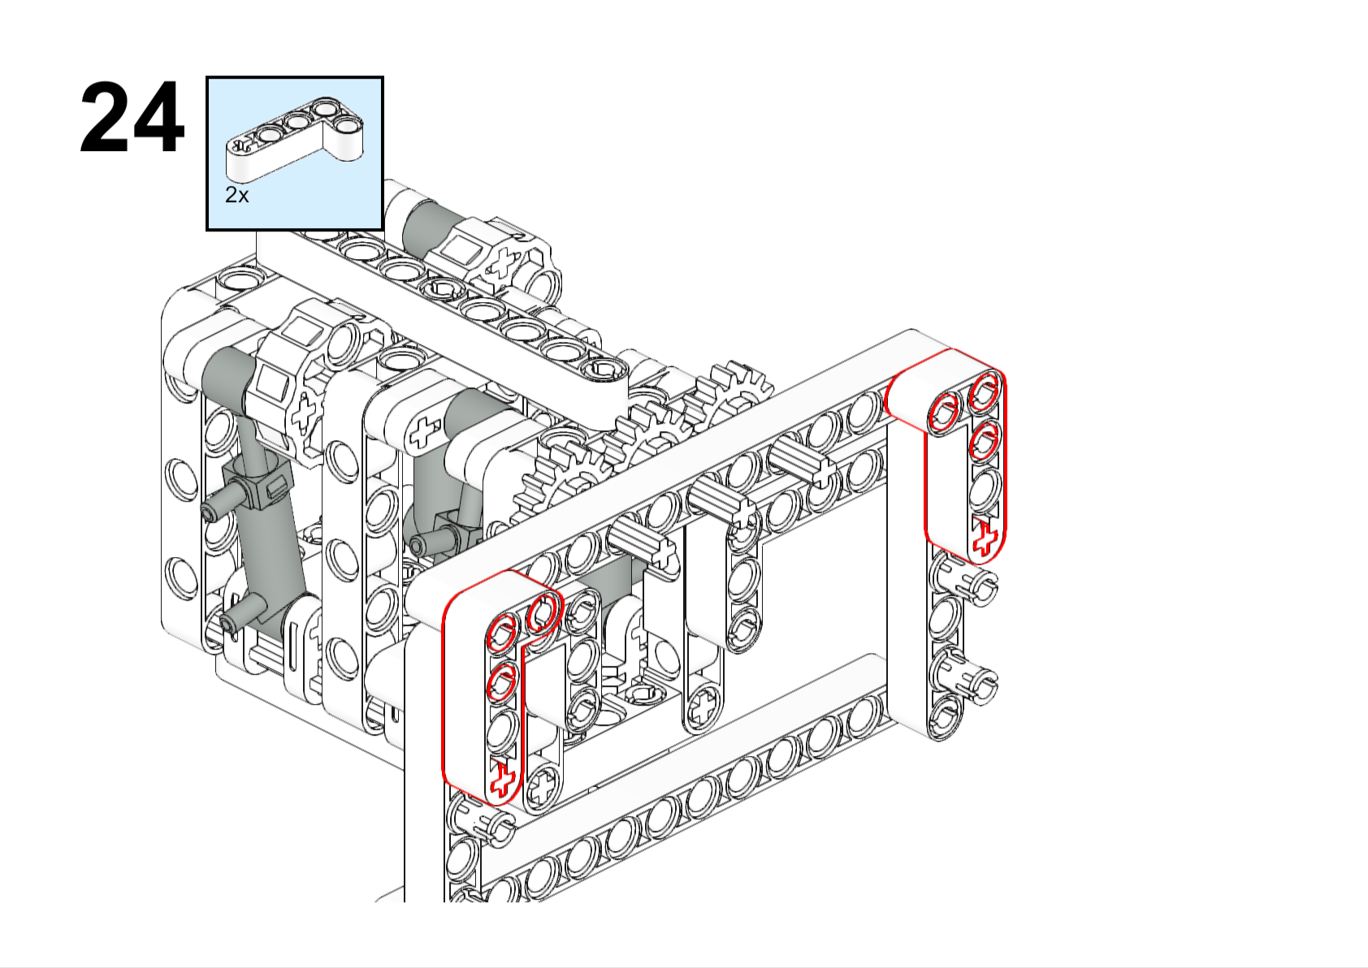
build_guide/Step02/Lego24.png
