SebicheParrilla/The-primis/build_guide/Step02/Lego26.png

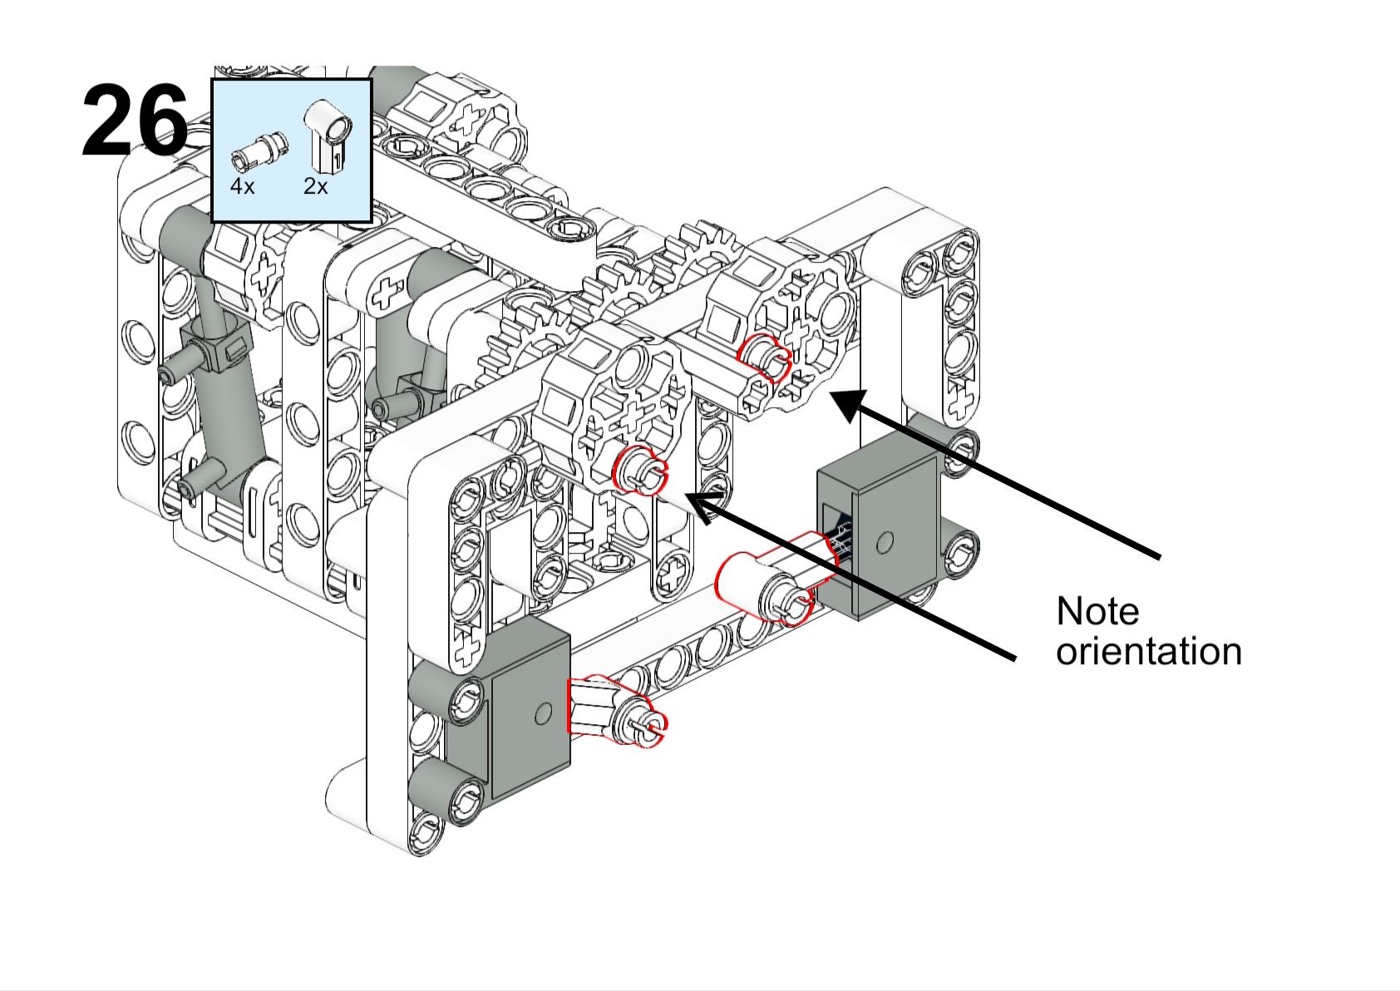
build_guide/Step02/Lego26.png
