SebicheParrilla/The-primis/build_guide/Step02/Lego27.png

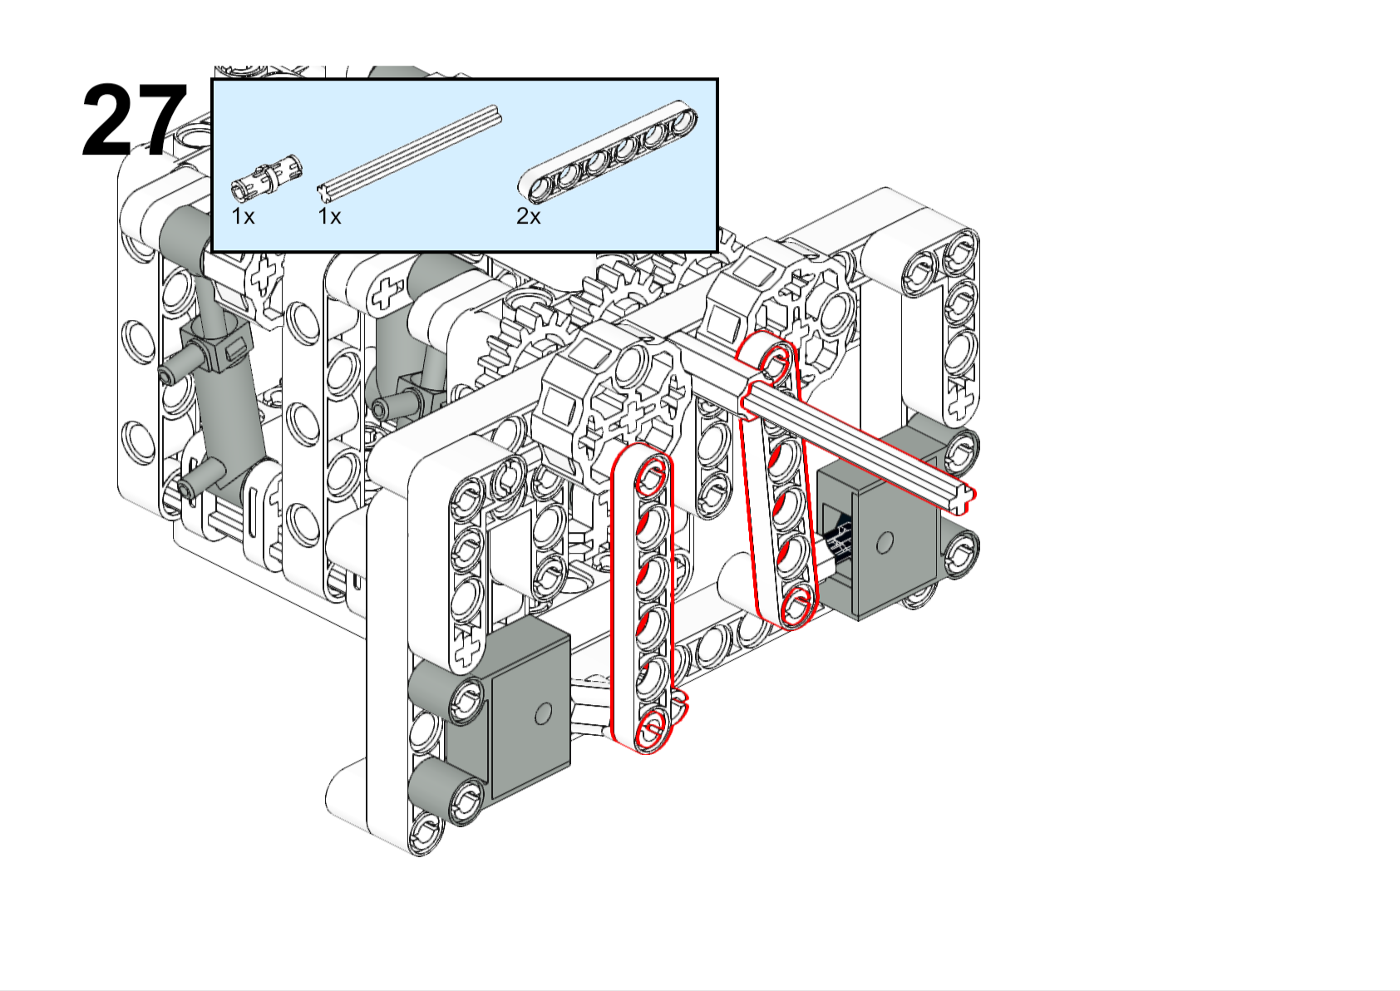
build_guide/Step02/Lego27.png
