SebicheParrilla/The-primis/build_guide/Step02/Lego28.png

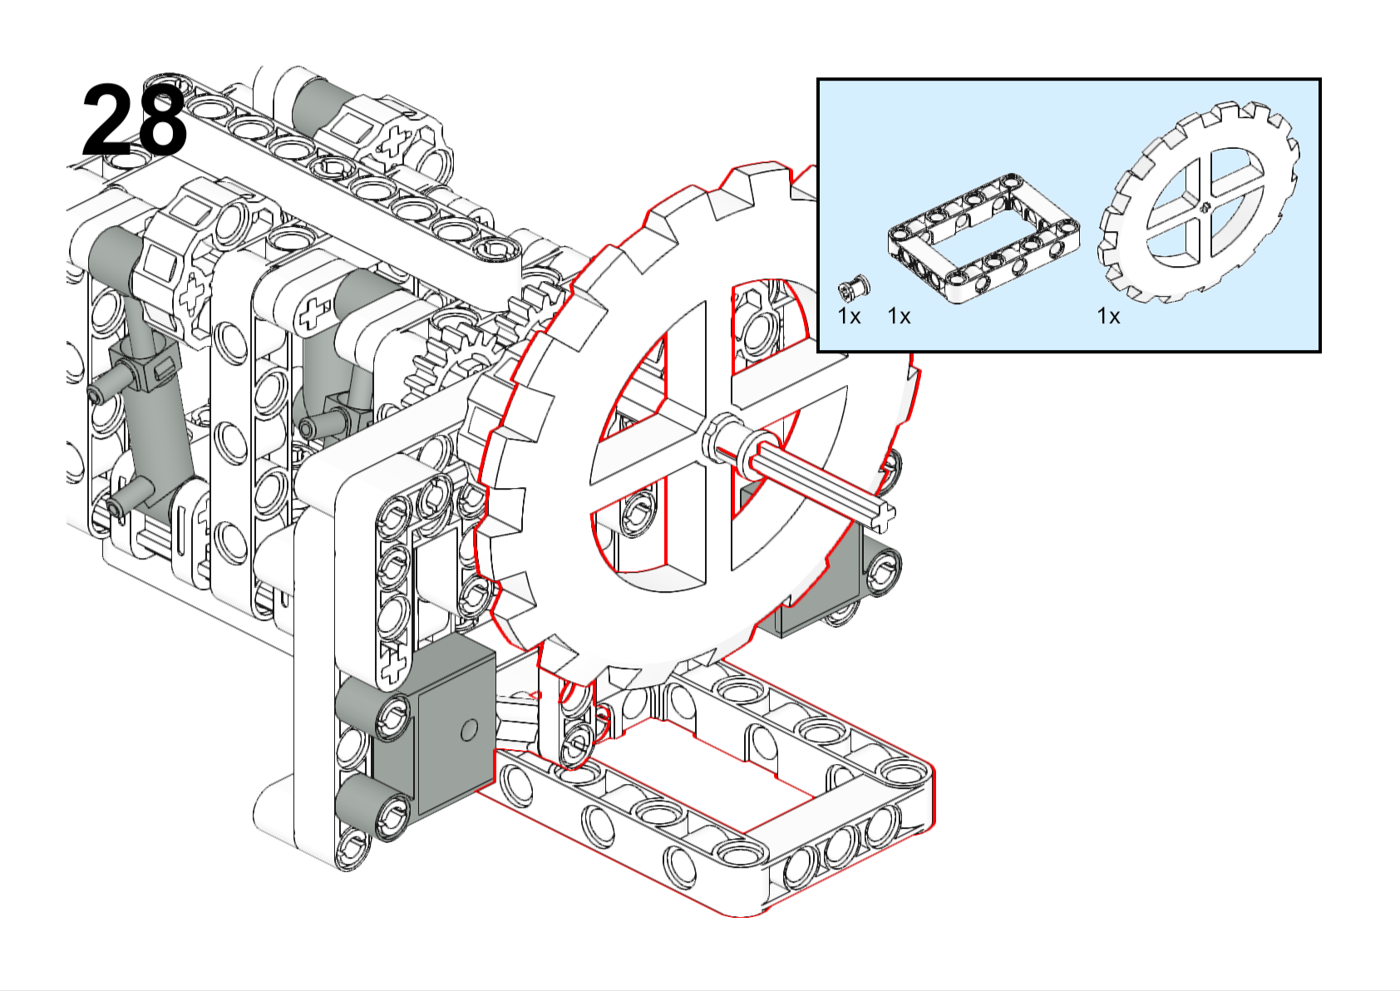
build_guide/Step02/Lego28.png
