SebicheParrilla/The-primis/build_guide/Step02/Lego30.png

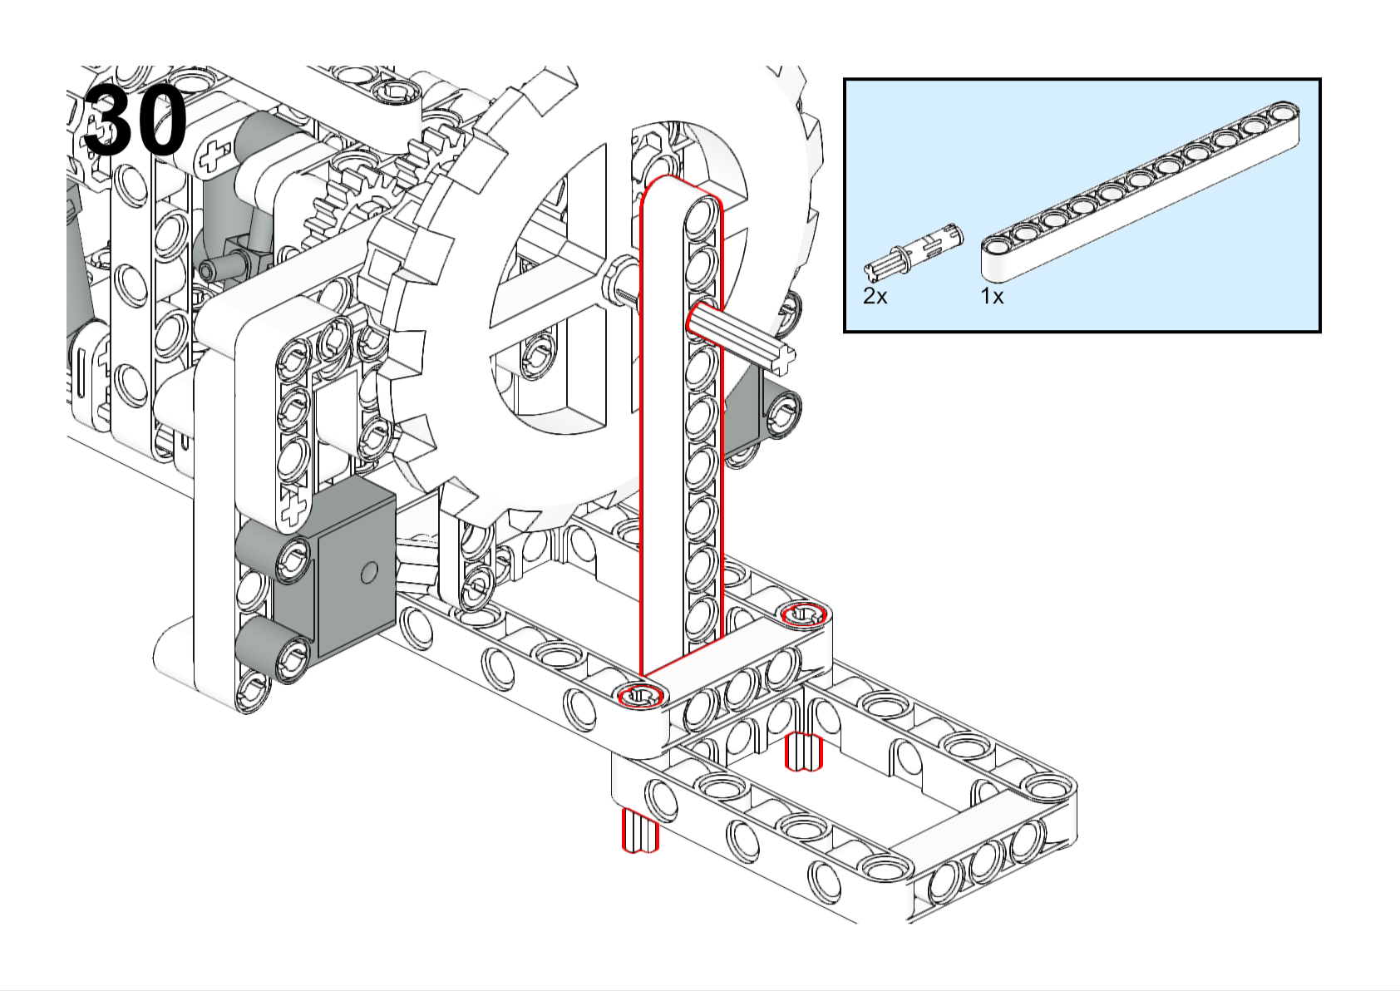
build_guide/Step02/Lego30.png
