SebicheParrilla/The-primis/build_guide/Step02/Lego38.png

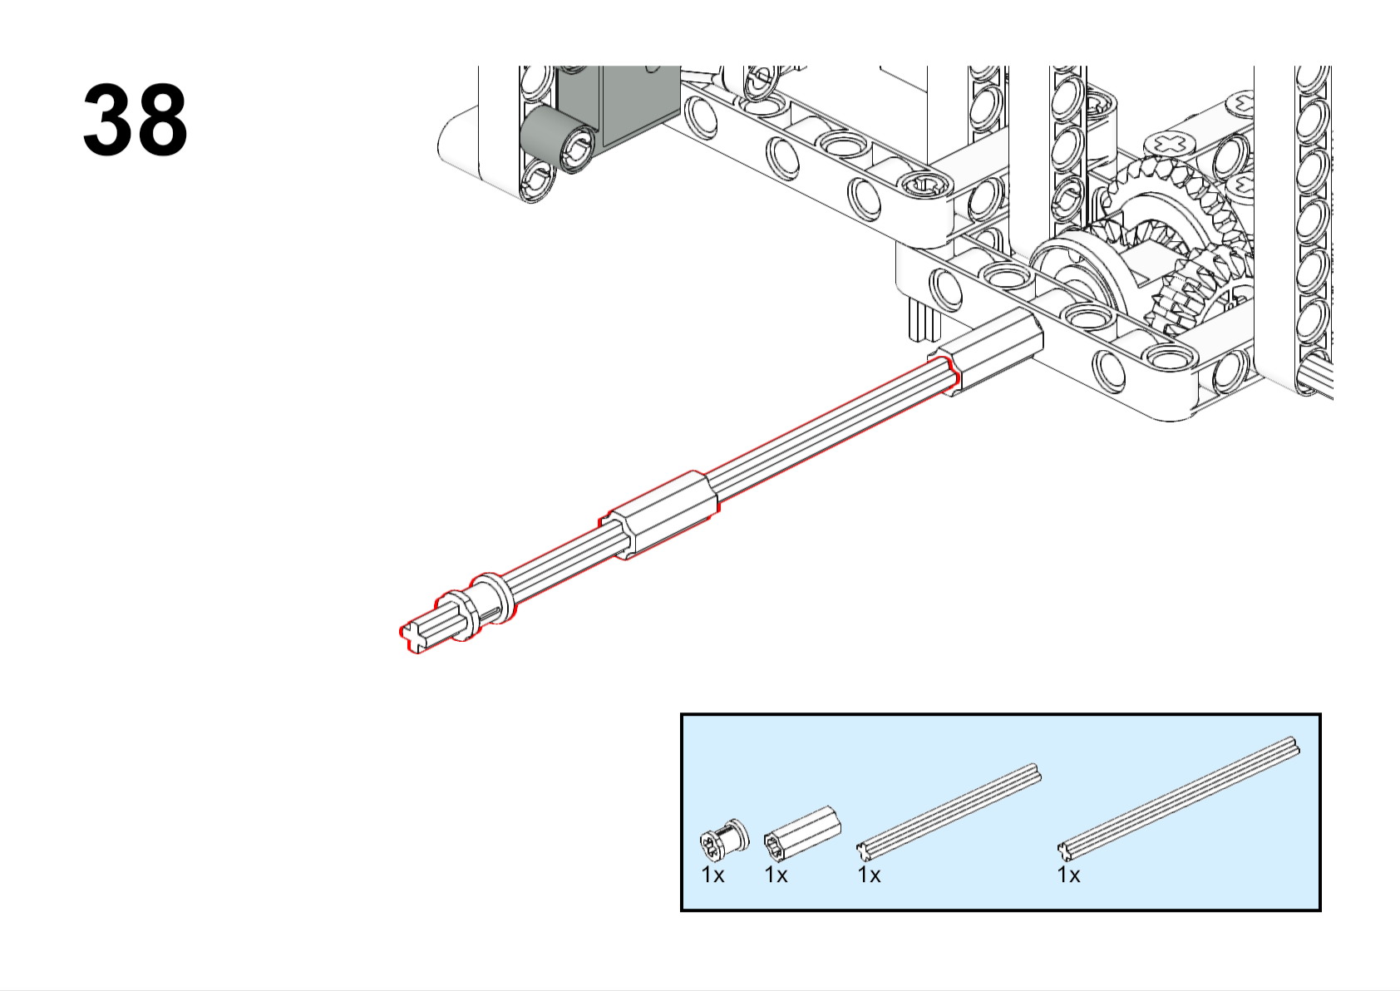
build_guide/Step02/Lego38.png
