SebicheParrilla/The-primis/build_guide/Step02/Lego40.png

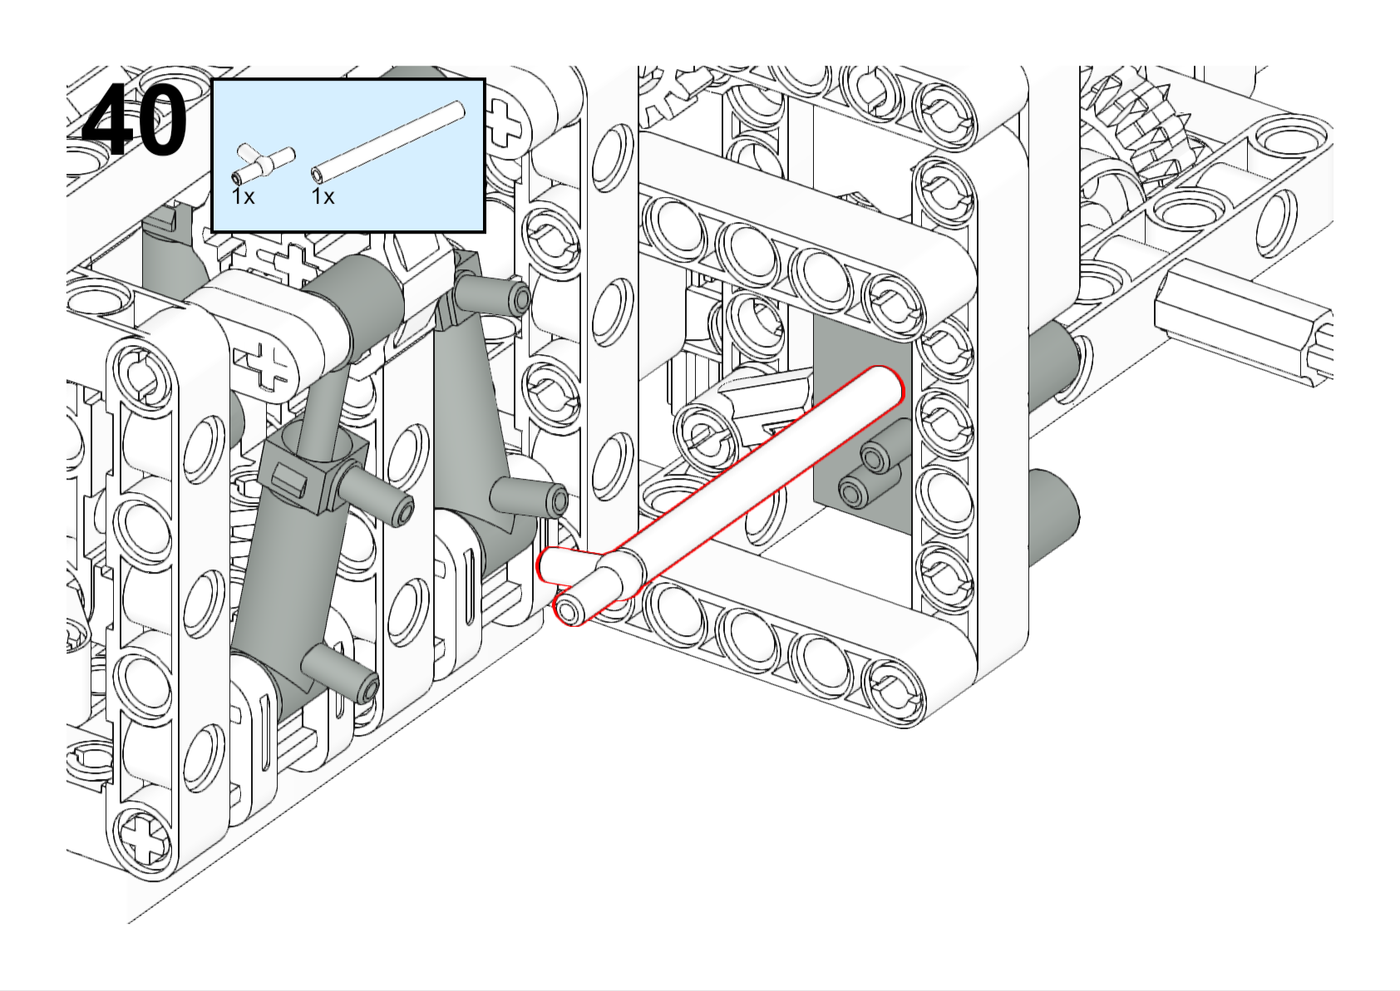
build_guide/Step02/Lego40.png
