SebicheParrilla/The-primis/build_guide/Step02/Lego50.png

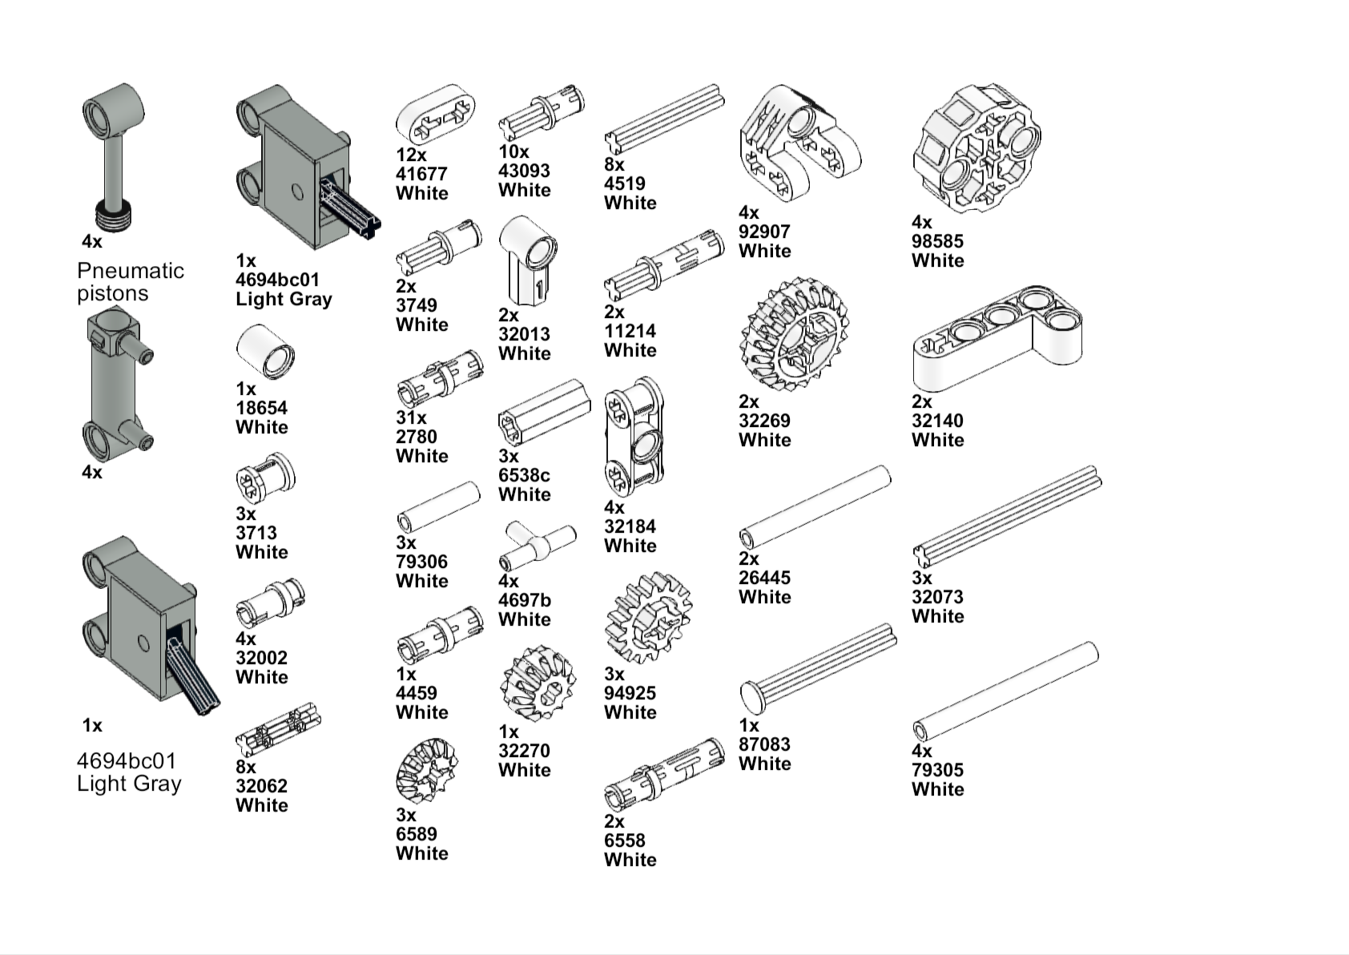
build_guide/Step02/Lego50.png
