SebicheParrilla/The-primis/build_guide/Step03/eCVT02.png

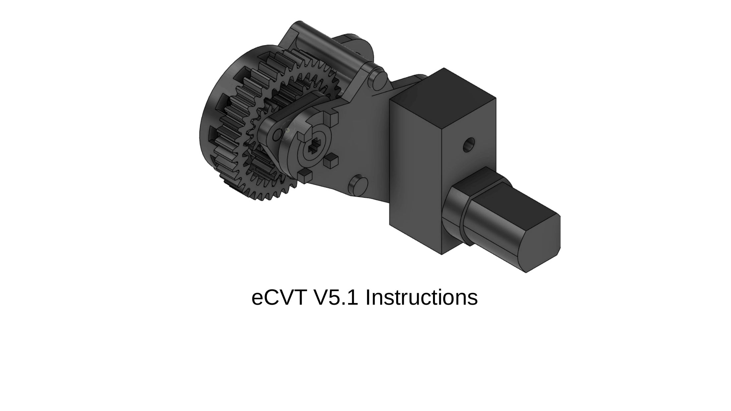
build_guide/Step03/eCVT02.png
