SebicheParrilla/The-primis/build_guide/Step03/eCVT03.png

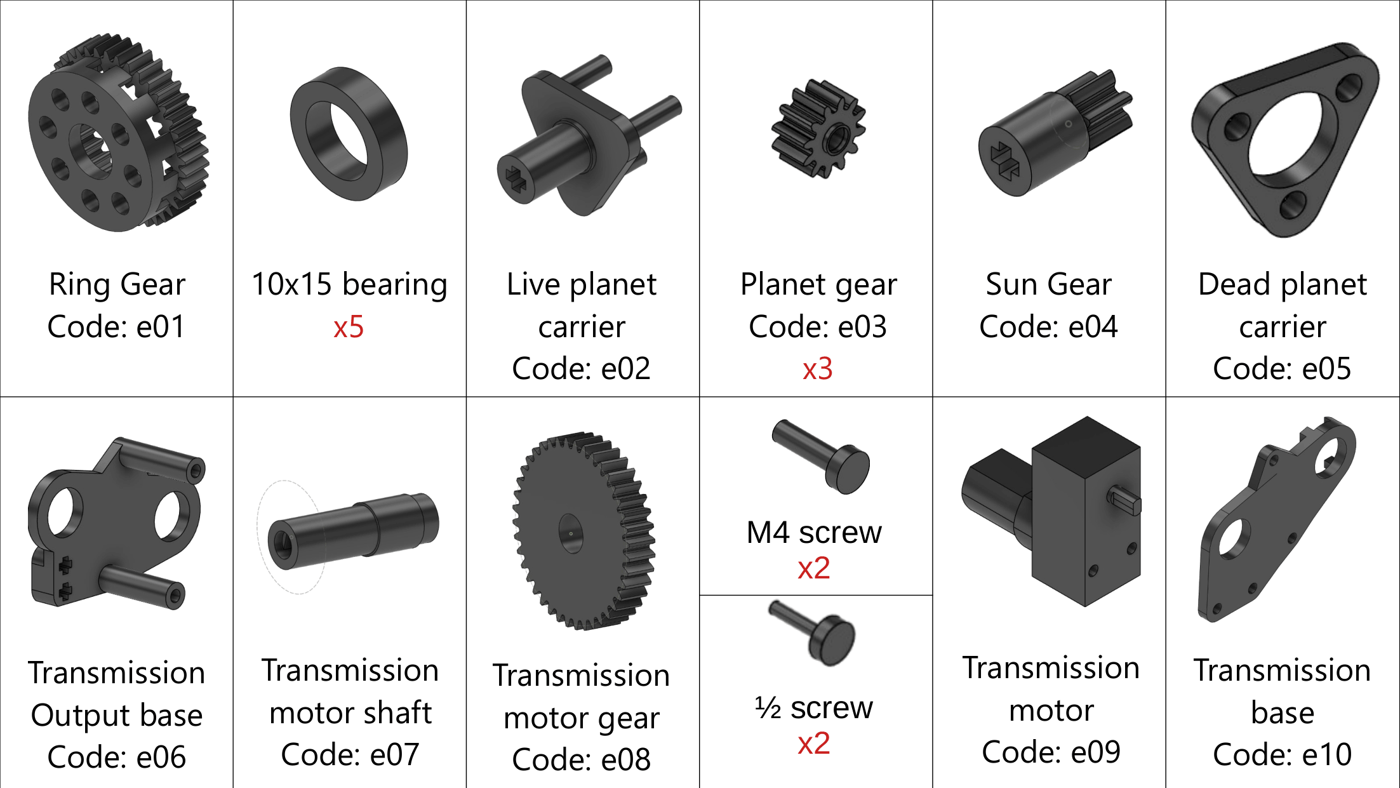
build_guide/Step03/eCVT03.png
