SebicheParrilla/The-primis/build_guide/Step03/eCVT04.png

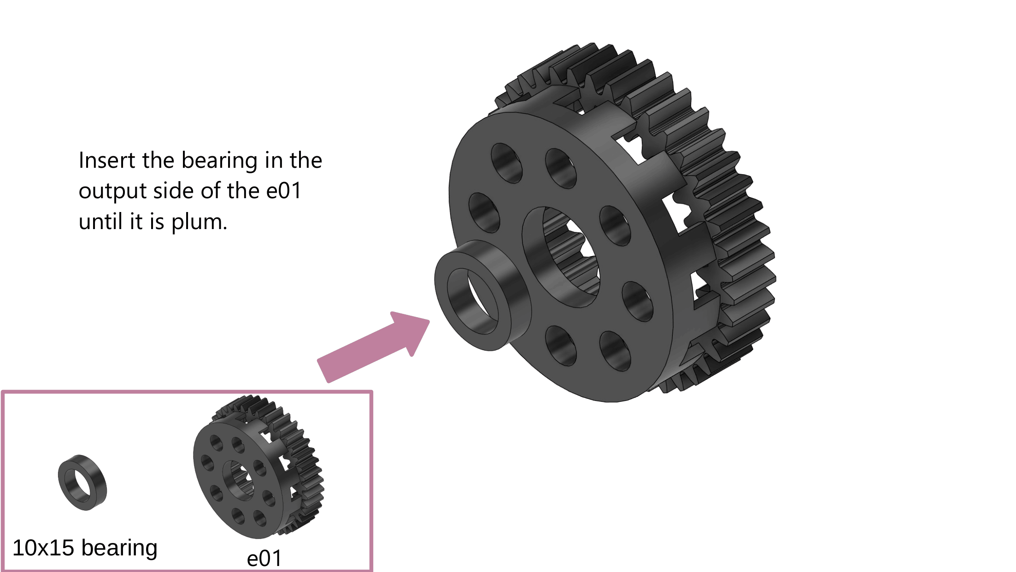
build_guide/Step03/eCVT04.png
