SebicheParrilla/The-primis/build_guide/Step03/eCVT5.png

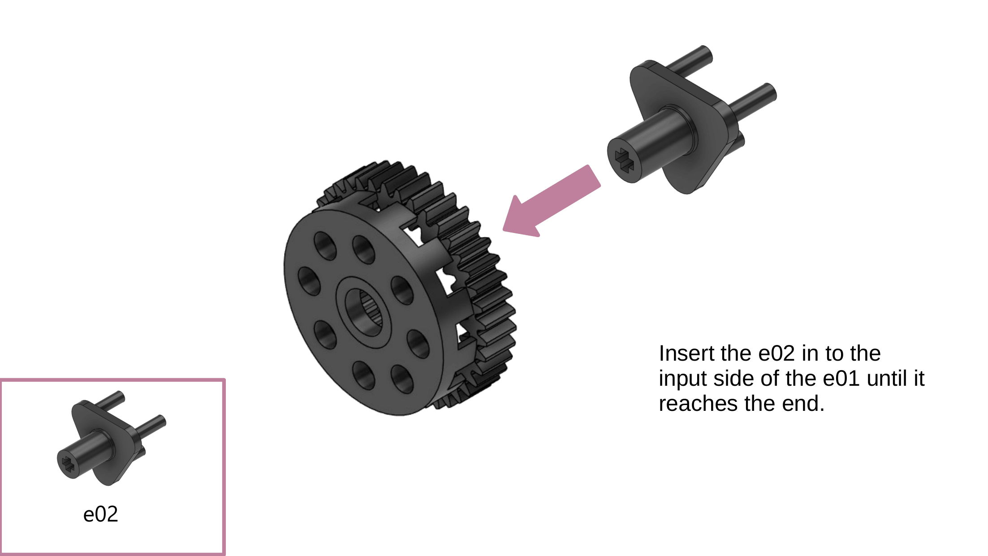
build_guide/Step03/eCVT5.png
