SebicheParrilla/The-primis/build_guide/Step03/eCVT06.png

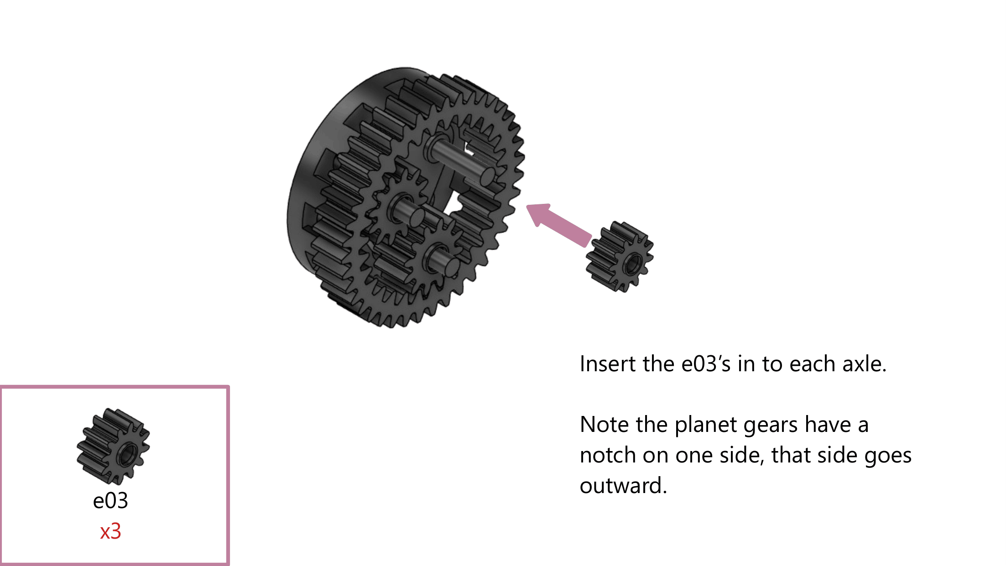
build_guide/Step03/eCVT06.png
