SebicheParrilla/The-primis/build_guide/Step03/eCVT07.png

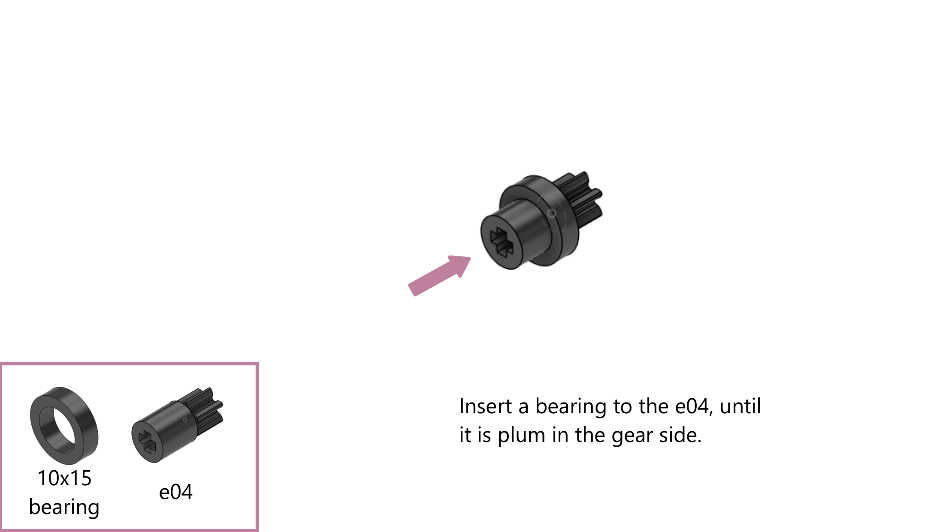
build_guide/Step03/eCVT07.png
