SebicheParrilla/The-primis/build_guide/Step03/eCVT08.png

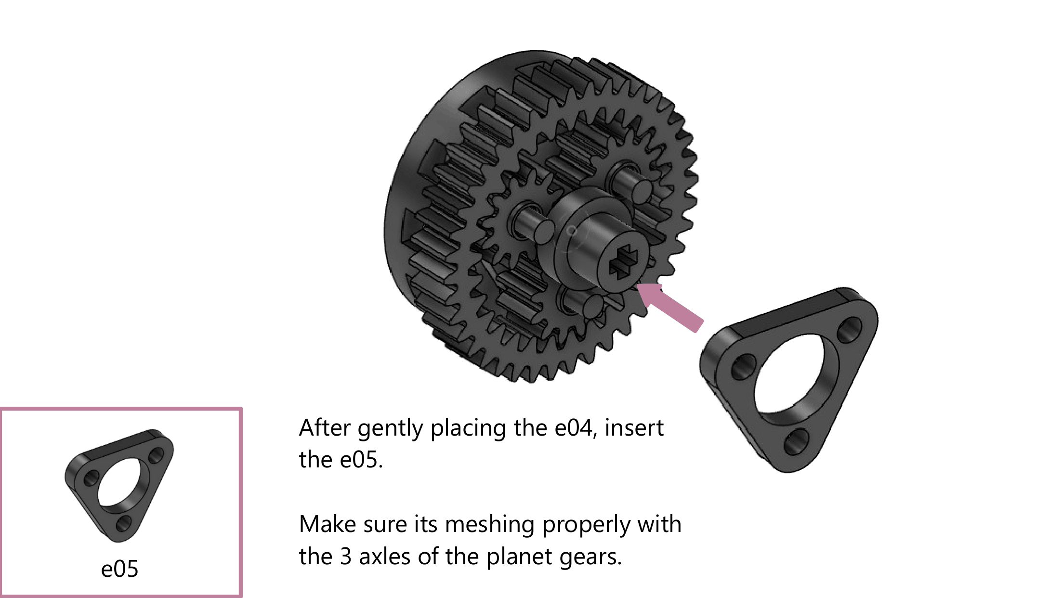
build_guide/Step03/eCVT08.png
