SebicheParrilla/The-primis/build_guide/Step03/eCVT09.png

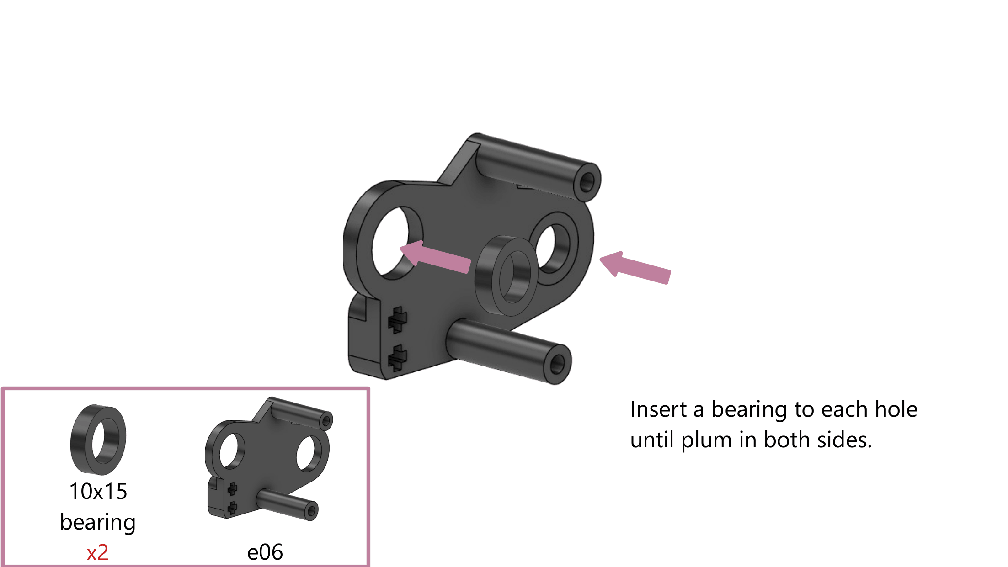
build_guide/Step03/eCVT09.png
