SebicheParrilla/The-primis/build_guide/Step03/eCVT10.png

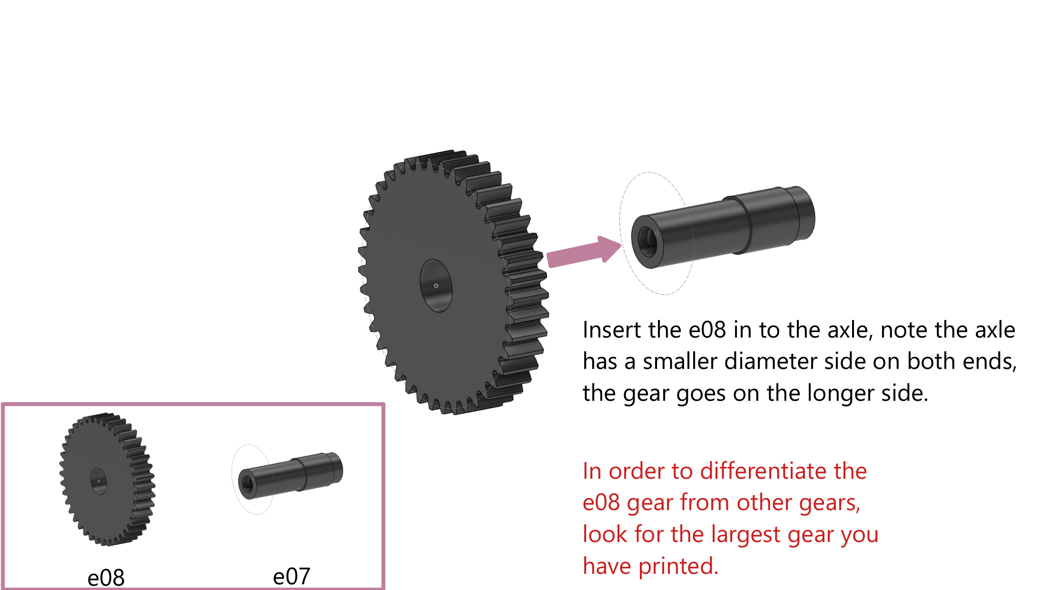
build_guide/Step03/eCVT10.png
