SebicheParrilla/The-primis/build_guide/Step03/eCVT11.png

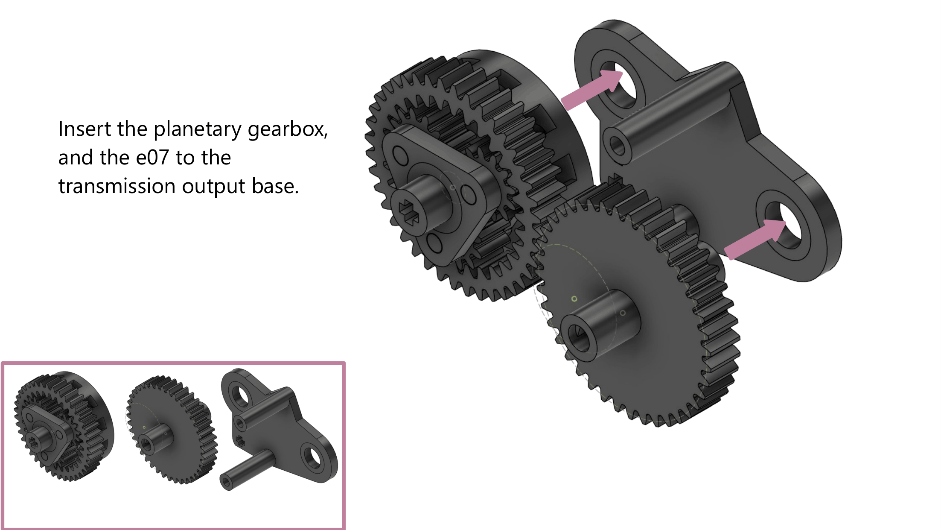
build_guide/Step03/eCVT11.png
