SebicheParrilla/The-primis/build_guide/Step03/eCVT12.png

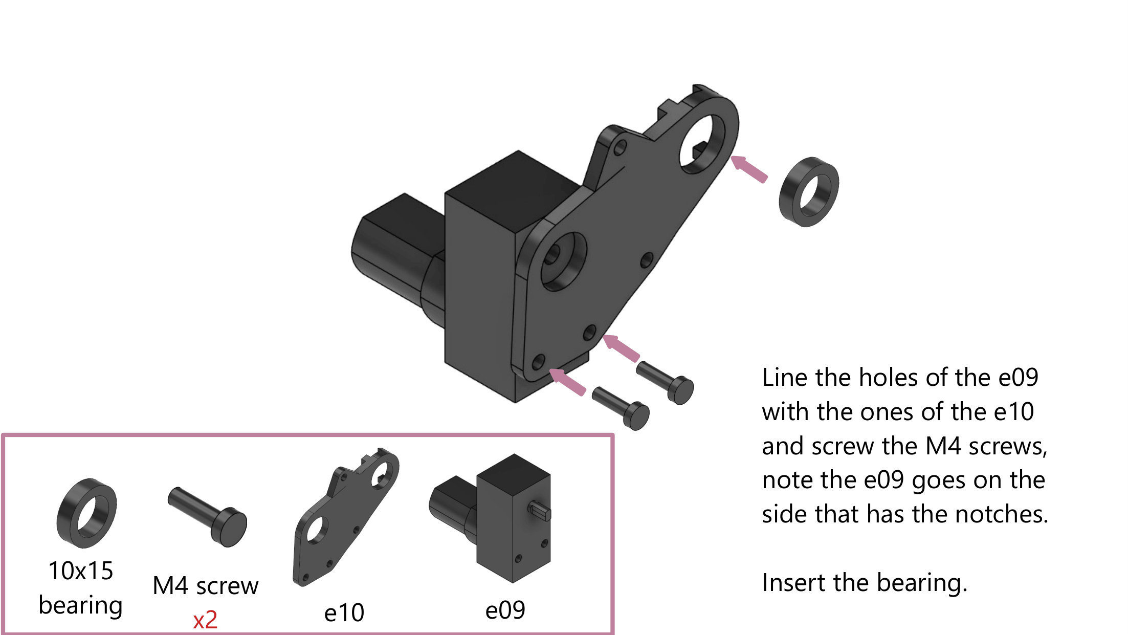
build_guide/Step03/eCVT12.png
