SebicheParrilla/The-primis/build_guide/Step03/eCVT13.png

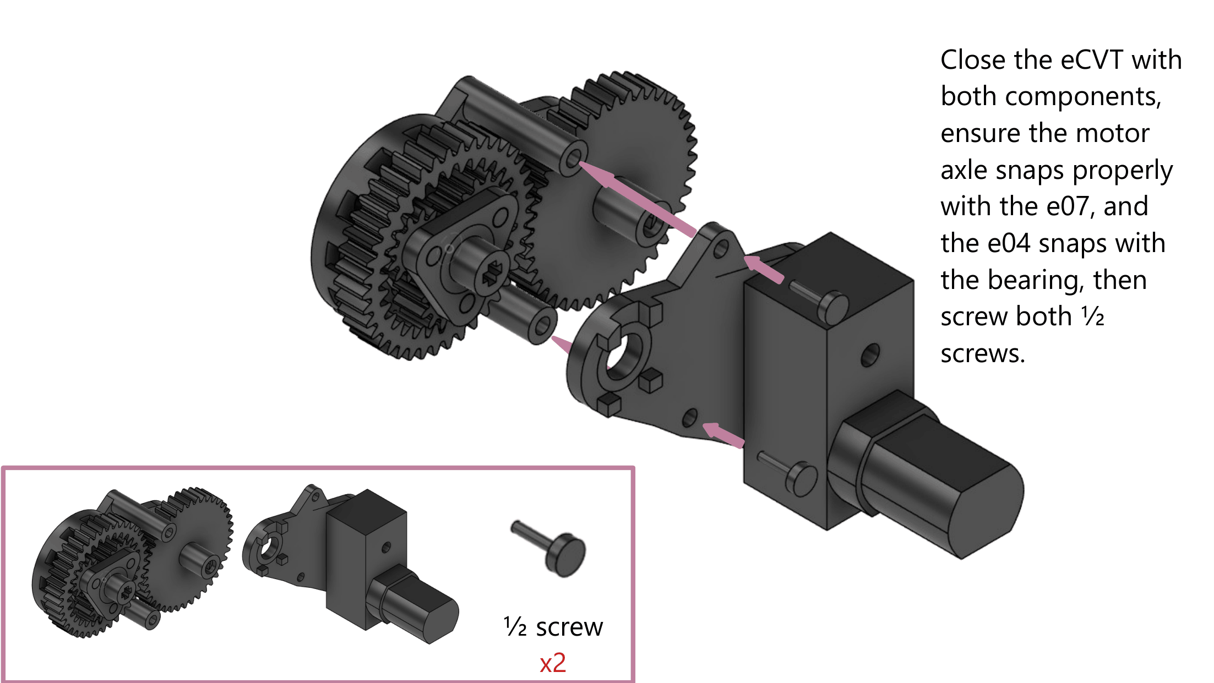
build_guide/Step03/eCVT13.png
