SebicheParrilla/The-primis/build_guide/Step03/eCVT14.png

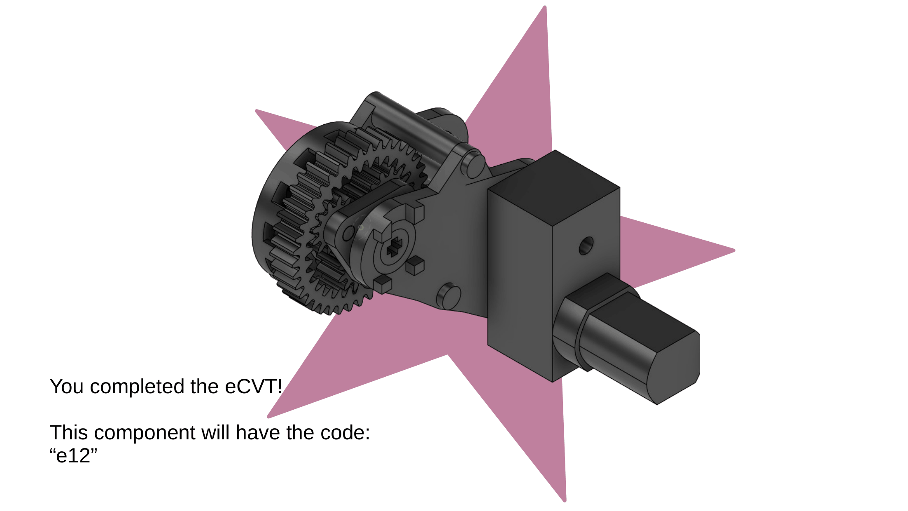
build_guide/Step03/eCVT14.png
