SebicheParrilla/The-primis/build_guide/Step04/ASMS (1).png

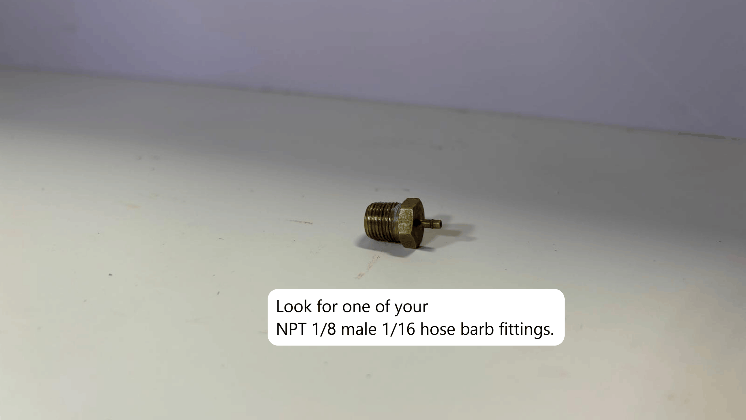
build_guide/Step04/ASMS (1).png
