SebicheParrilla/The-primis/build_guide/Step04/ASMS (2).png

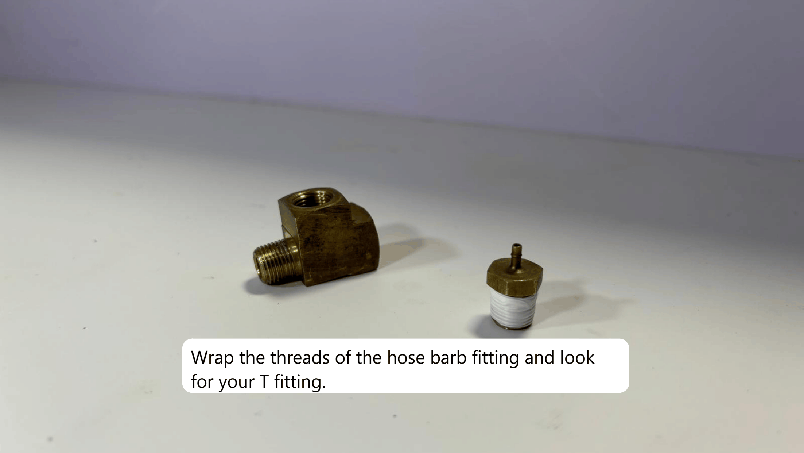
build_guide/Step04/ASMS (2).png
