SebicheParrilla/The-primis/build_guide/Step04/ASMS (3).png

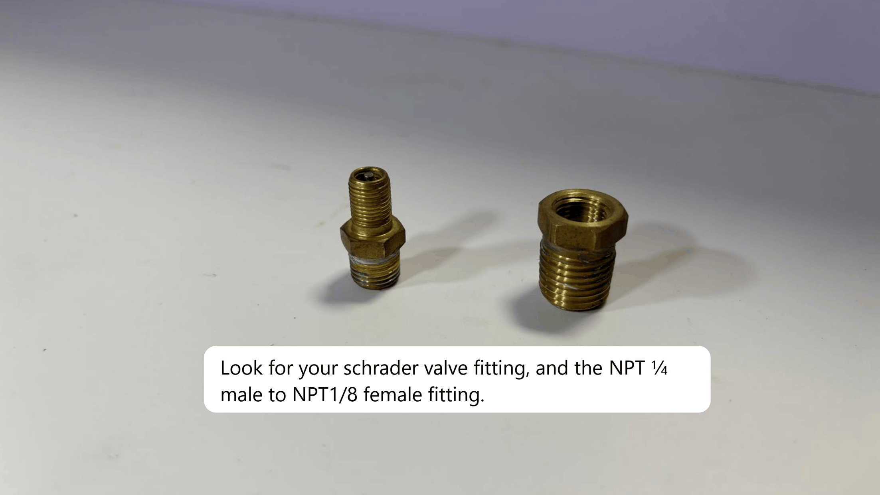
build_guide/Step04/ASMS (3).png
