SebicheParrilla/The-primis/build_guide/Step04/ASMS (4).png

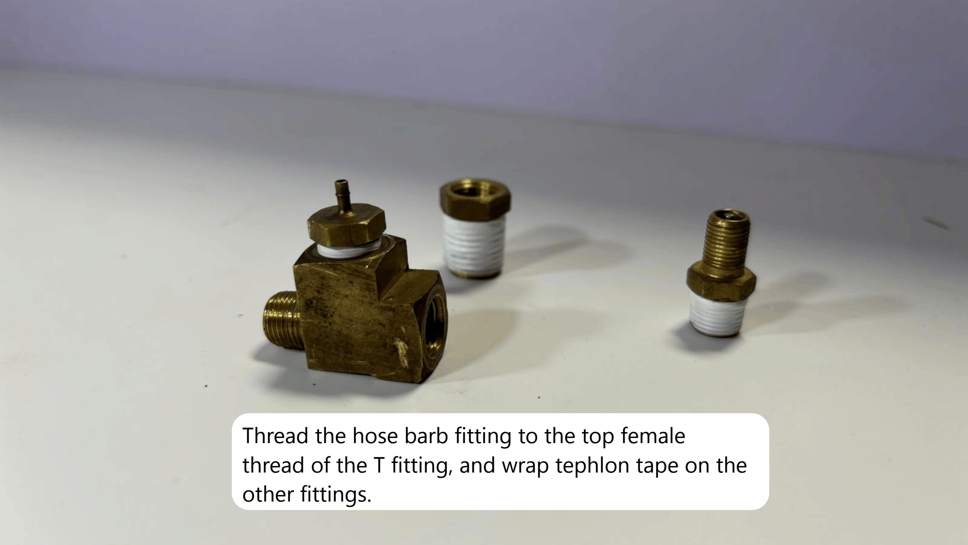
build_guide/Step04/ASMS (4).png
