SebicheParrilla/The-primis/build_guide/Step04/ASMS (5).png

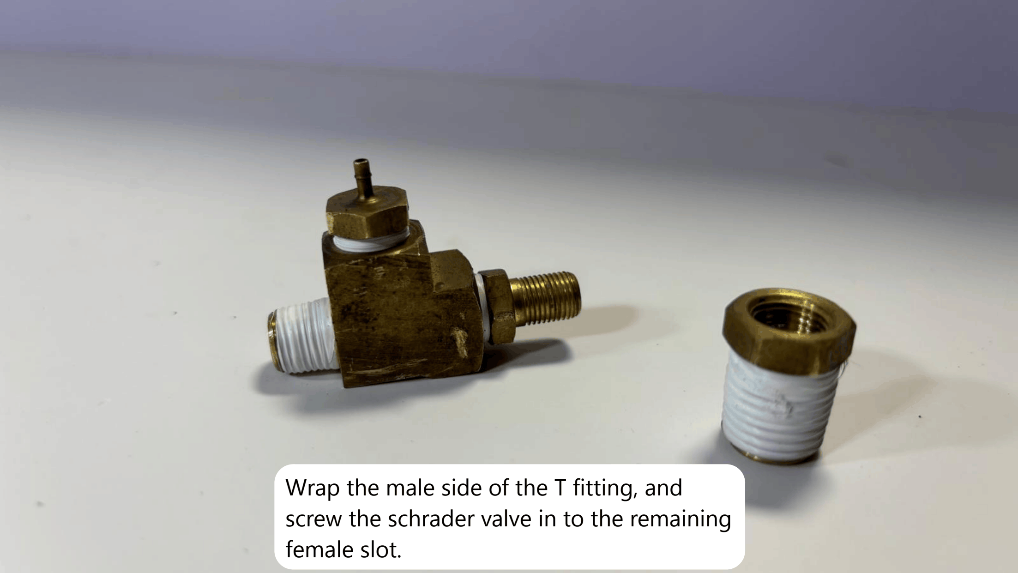
build_guide/Step04/ASMS (5).png
