SebicheParrilla/The-primis/build_guide/Step04/ASMS (9).png

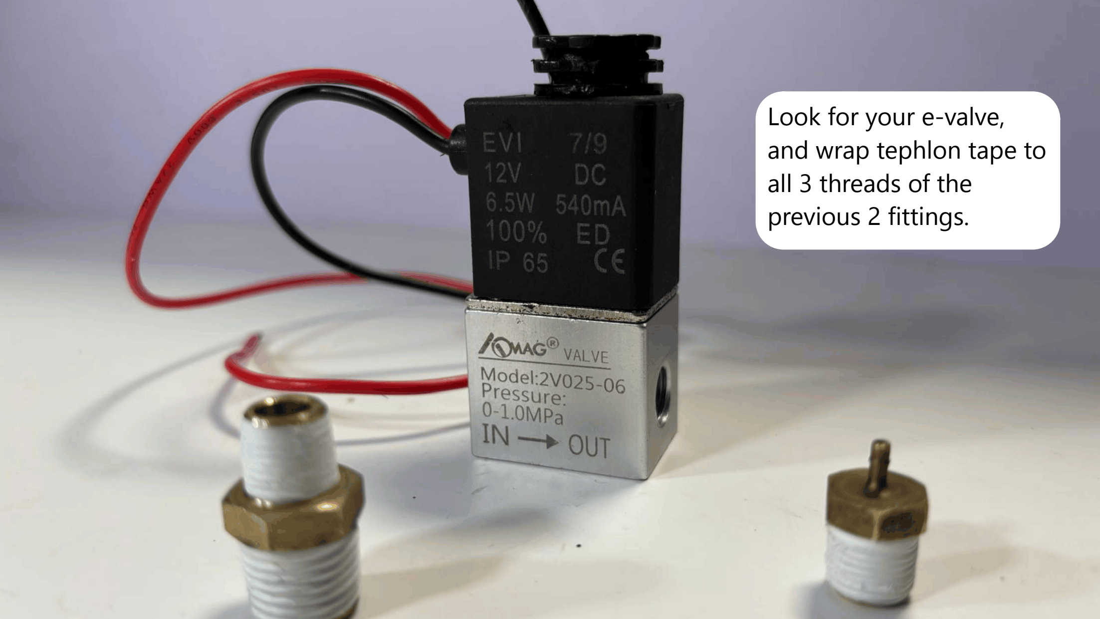
build_guide/Step04/ASMS (9).png
