SebicheParrilla/The-primis/build_guide/Step04/ASMS (10).png

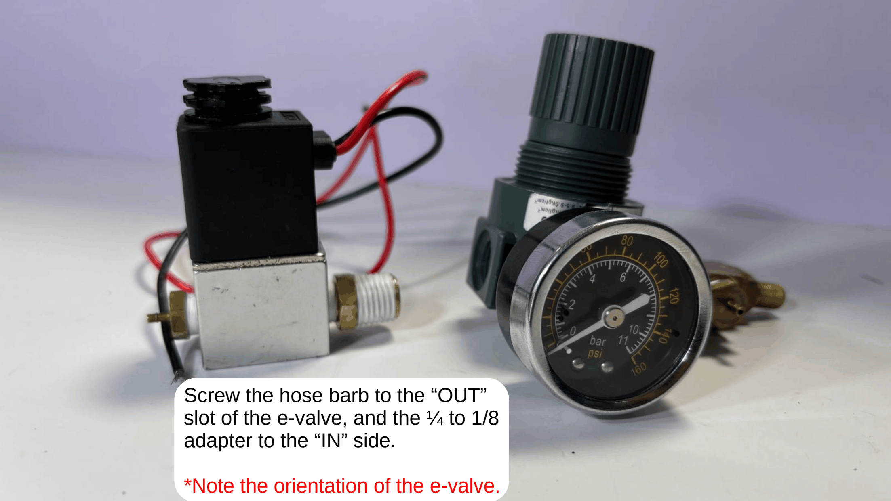
build_guide/Step04/ASMS (10).png
