SebicheParrilla/The-primis/build_guide/Step04/ASMS (12).png

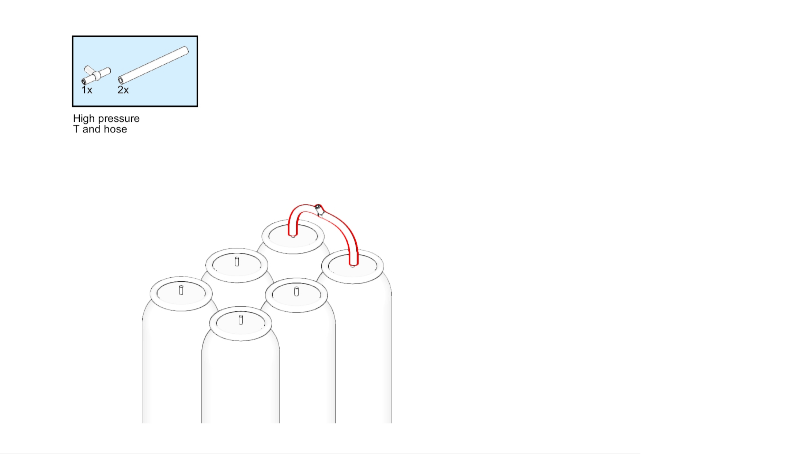
build_guide/Step04/ASMS (12).png
