SebicheParrilla/The-primis/build_guide/Step04/ASMS (16).png

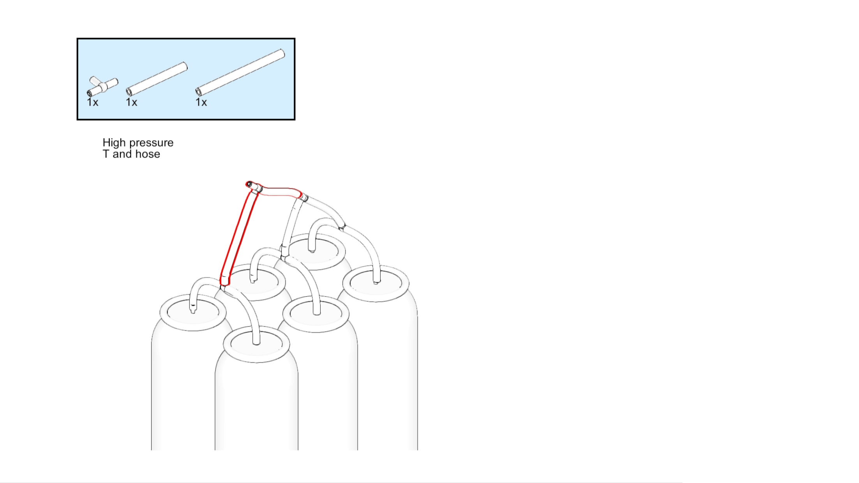
build_guide/Step04/ASMS (16).png
