SebicheParrilla/The-primis/build_guide/Step04/ASMS (18).png

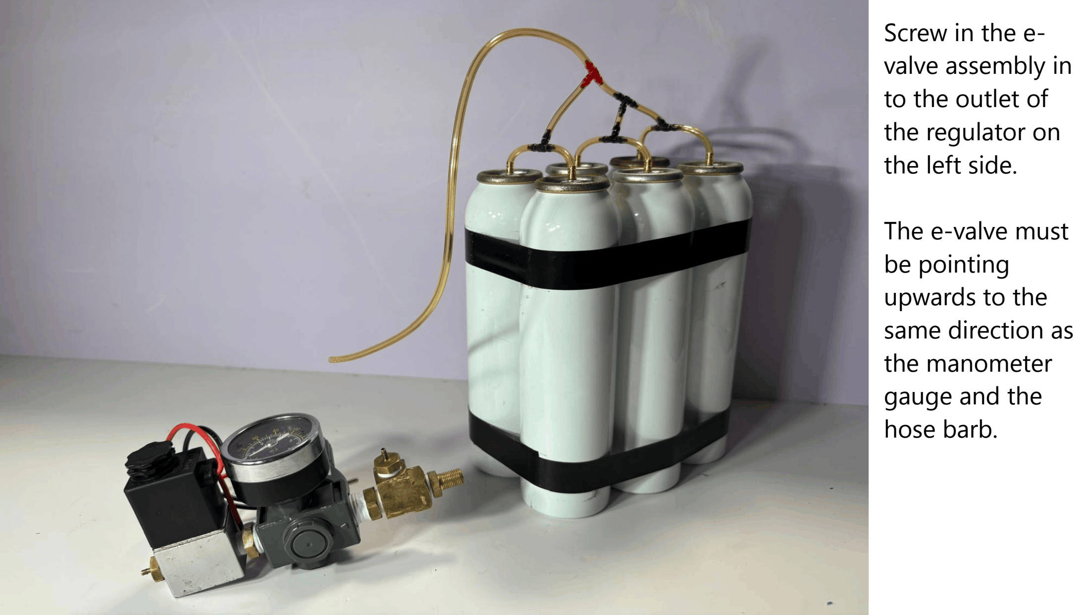
build_guide/Step04/ASMS (18).png
