SebicheParrilla/The-primis/build_guide/Step04/ASMS(06).png

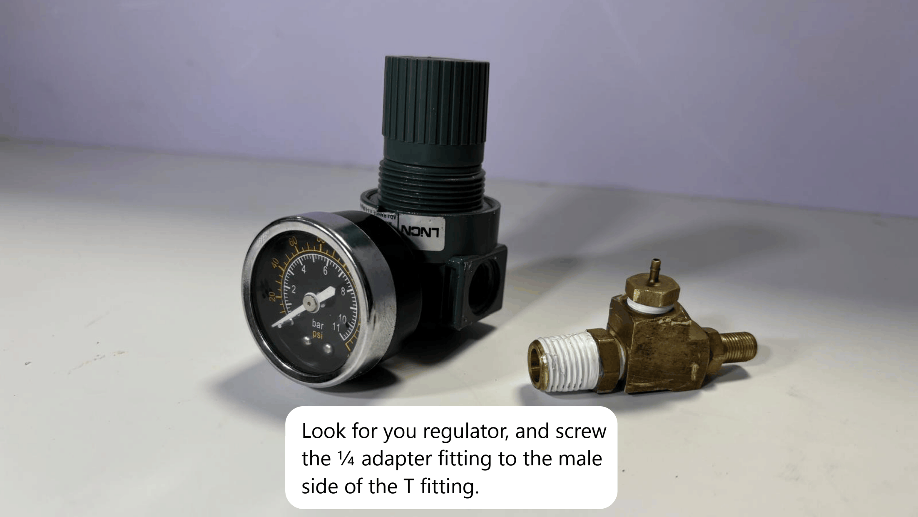
build_guide/Step04/ASMS(06).png
