SebicheParrilla/The-primis/build_guide/Step05/Steering (1).png

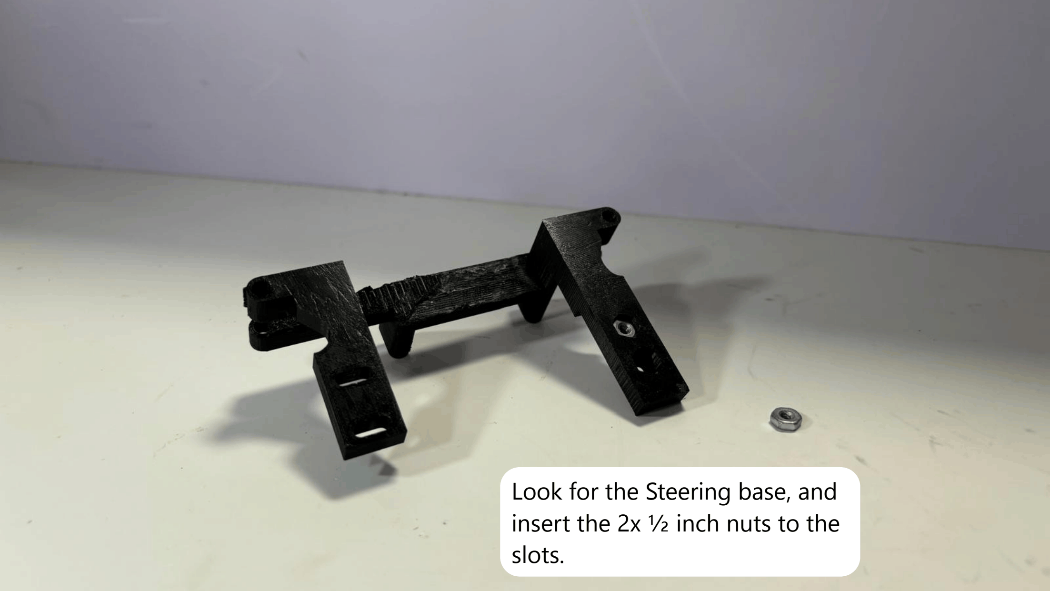
build_guide/Step05/Steering (1).png
