SebicheParrilla/The-primis/build_guide/Step05/Steering (2).png

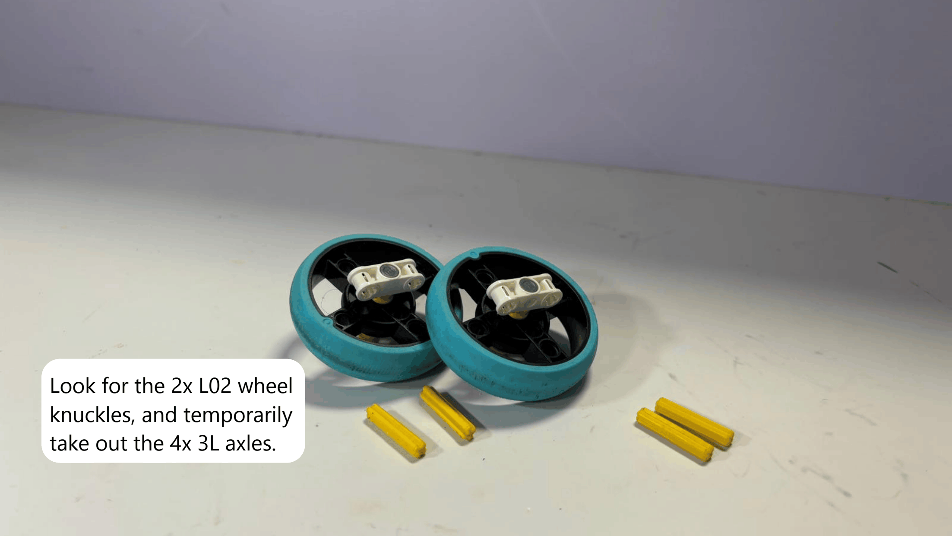
build_guide/Step05/Steering (2).png
