SebicheParrilla/The-primis/build_guide/Step05/Steering (3).png

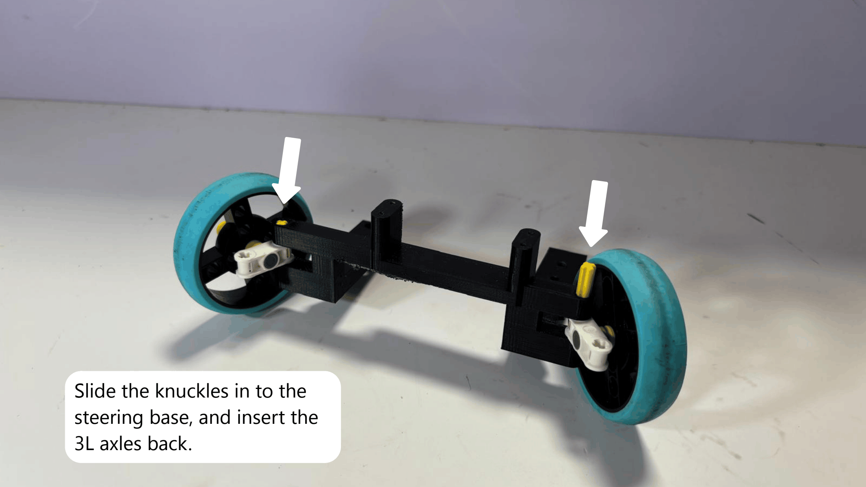
build_guide/Step05/Steering (3).png
