SebicheParrilla/The-primis/build_guide/Step05/Steering (5).png

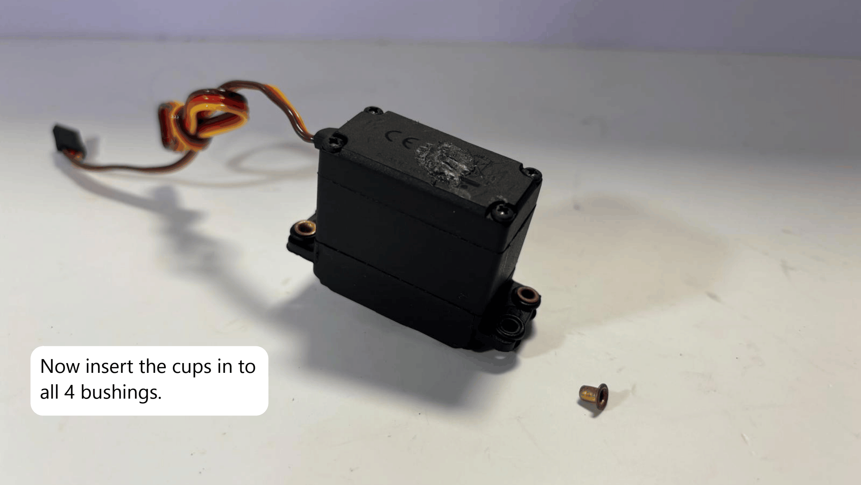
build_guide/Step05/Steering (5).png
