SebicheParrilla/The-primis/build_guide/Step05/Steering (7).png

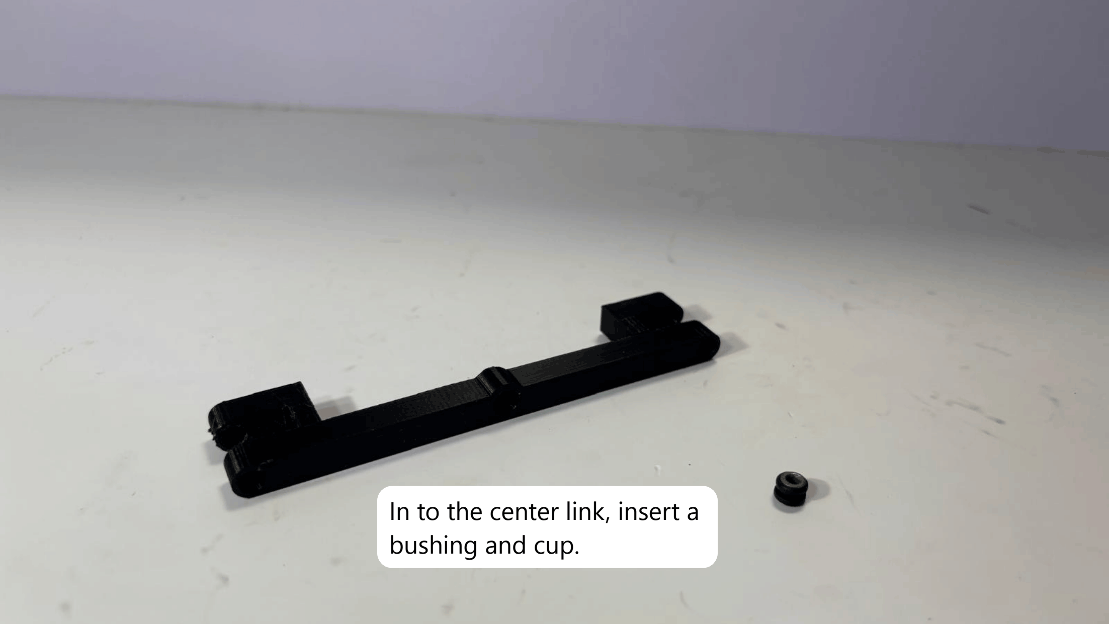
build_guide/Step05/Steering (7).png
