SebicheParrilla/The-primis/build_guide/Step05/Steering (8).png

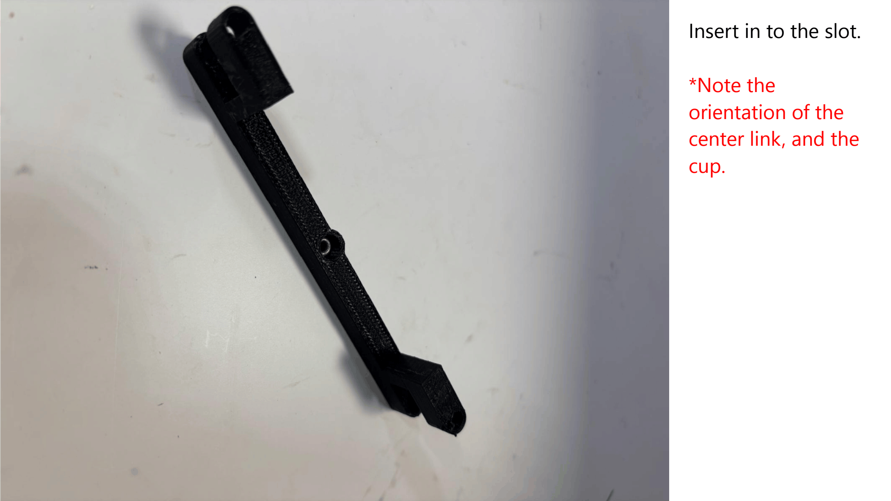
build_guide/Step05/Steering (8).png
