SebicheParrilla/The-primis/build_guide/Step05/Steering (09).png

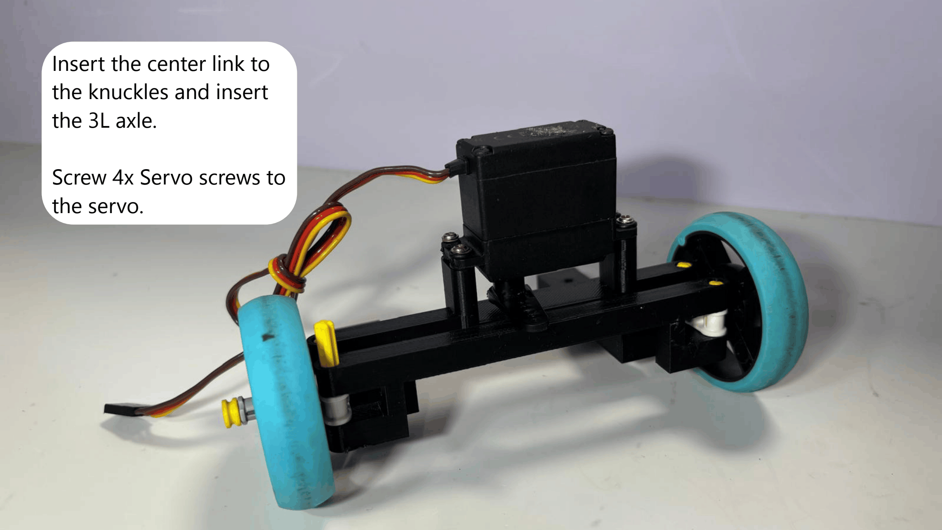
build_guide/Step05/Steering (09).png
