SebicheParrilla/The-primis/build_guide/Step05/Steering(04).png

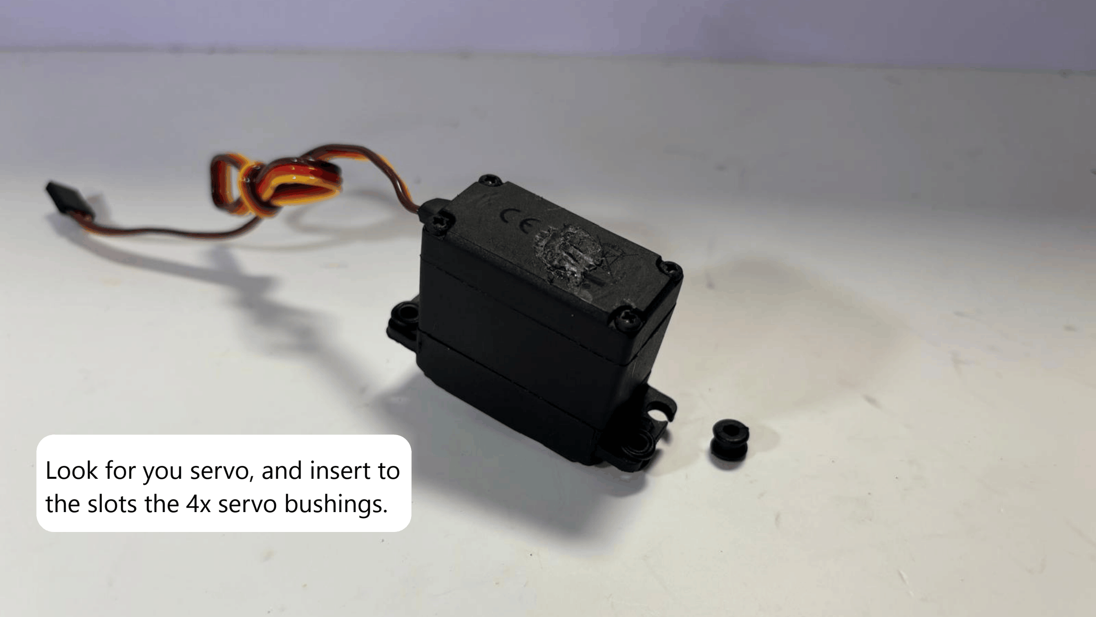
build_guide/Step05/Steering(04).png
