SebicheParrilla/The-primis/logs/5-26-2026 TEST.md

## eCVT logic coding
> Retrospective log: This entry's information was digitized from the physical engineering notebook on 2026-07-10.

The transmission motor as well as the flywheel on the pneumatic engine have encoders, these count the pulses on a disk that is rotating, calculating how many slots per revolution (360° spin of a axle) and its speed.

This allows us to:

- While the pneumatic engine is on make the transmission motor cancel out its movement and making the vehicle stationary.
- Slowly increase or decrease speed of the vehicle
- Calculate how much the vehicle traveled 

We made a test bench to make the program for the eCVT logic. Using an electric motor as a simulator of the pneumatic engine without the need of refilling the air tanks, we will test the combination of encder values and power supply to the transmission motor to cancel out the movement of both thus making the car not move. 

[Vehicle Neutral Hold Code](../code\EcvtLogicNeutral5262026.py)

Then we made a code testing the vehicles gradual acceleration, this demonstrates how reliable the optic sensors are.

[Vehicle Acceleration Code](../code\EcvtLogicForward5262026.py)

We concluded that with a good program we could use reliably both sensors allthough the flywheel encoder worked almost perfectly compared to the motor encoder which had sudden spikes of values, we think it could relate to a smaller sample size since the disk only has 9 slots, and the flywheel has 16, this means theres less information being read per revolution.
