SebicheParrilla/The-primis/development_process/digitalized_notebook/engineering_notebook_page_007-1.png

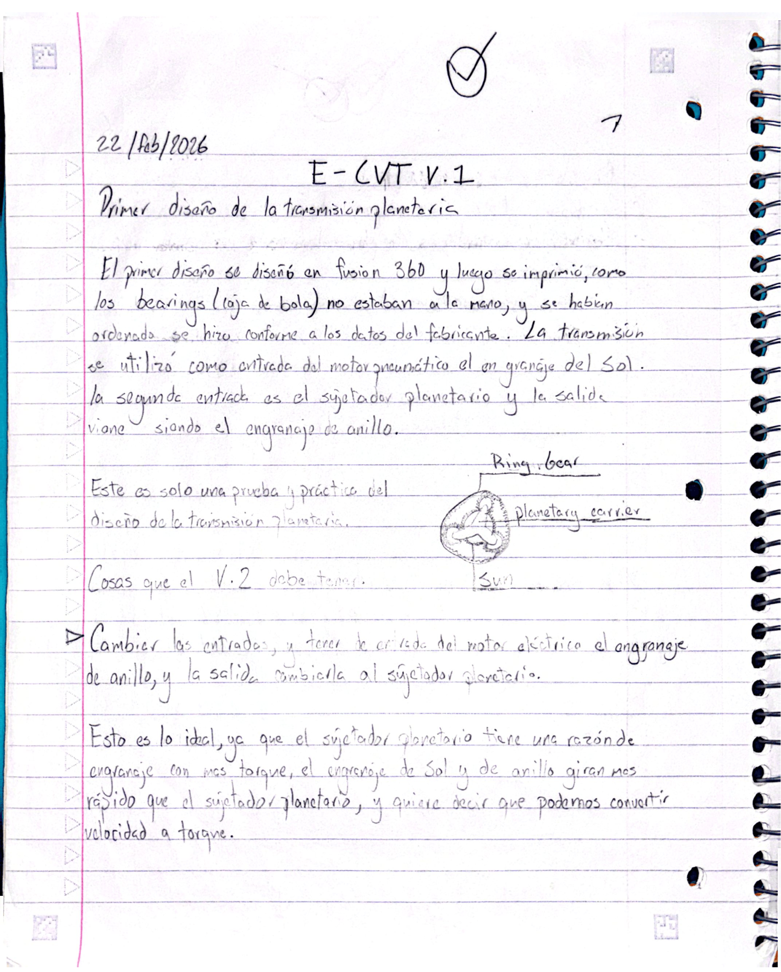
development_process/digitalized_notebook/engineering_notebook_page_007-1.png
