SebicheParrilla/The-primis/(commit log)

2026-05-01 actualizacion de fotos
2026-07-10 adding info
    added subcomponents to the mosfet driver folder
2026-09-18 pneumatic engine's README
    added pictures to explain the chain reaction of a engine, and the context.
2026-09-22 Repo structure changing
    adding and brainstorming necessary files like BOM, build_guide, and added the buildguide link to the README
2026-10-27 Testing stl files
    adding stl files for the building instructins.
2026-11-11 Chassis instructions
    Chassis instruction added, BOM completed.
2026-11-12 Adding sensor architecture
    Readme addign and colapsed the electrical folder to make only files.
